farev/robotarmtest/sim/fea-v1/plots/stress_map.png

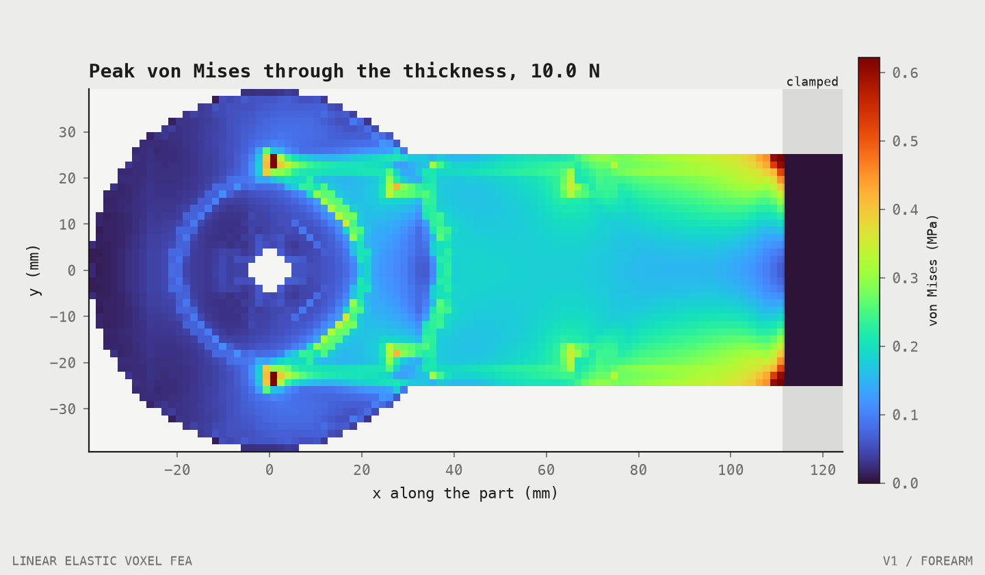
sim/fea-v1/plots/stress_map.png
