farev/robotarmtest/.mechy/reviews/2026-10-29-design-2.md

# Design review, 2026-10-29 (re-review 2)

Verdict: not ready (2 blocking, 13 should fix, 8 unverified)
Files read: design/v1/assembly.yaml, design/v1/poses/{elbow-up,reach-table,shoulder-down,yaw-150,service-tower,stretched,service-j2,up,folded}/assembly.yaml,
design/v1/printed/*.py (layout, gripper_layout, features, style and every part and coupon script), design/v1/printed/*.step (20),
design/v1/print_list.csv, design/v1/views/{iso,front,side,top}.png, design/v1/summary.md, design/v1/check_results.json,
docs/v1/build-notes.md, control/joint_limits.yaml, parts/models/{flange-coupling-5mm,nema17-42shdc}.yaml, parts/models/std_parts.py,
parts/models/std_parts_yaml.py, parts/components.yaml, requirements.yaml, decisions.md, previous review .mechy/reviews/2026-10-29-design.md,
.claude/skills/{assembly/SKILL.md, printable-part-design/references/fdm_pla_rules.md, industrial-design/references/legible_cad.md},
engine data standard_parts/fasteners_hex_nuts.csv, https://vxb.com/products/4-pack-5mm-rigid-flange-shaft-couplings-with-8-scr

## Blocking

1. **Carriage clamp nuts (stage-2 tension)**: the captive-nut slots are wide enough for the M3 nut to spin, so the two carriage clamp screws cannot be tightened.
   - The slot width is `nut_w / cos(30°)` = 5.8 / 0.866 = 6.70 mm (upper-arm.py:127-130). A section of upper-arm.step at print z = 1.35 measures both nut slots at **6.697 mm**.
   - An M3 nut is 5.5 across flats and 6.01 min / 6.35 nominal across corners (fasteners_hex_nuts.csv), so it turns freely in a 6.70 slot. §2 asks for a side-entry slot of s + 0.3 = 5.8.
   - You cannot hold the nut either. The slots sit 14 ± 3 mm from the intermediate shaft, under the 60T flange (r 21) and hub (1 mm off the wall). Build-notes §3.5 tensions stage 2 with those pulleys already fitted.
   - The screw also barely clears the nut. The M3 x 12 tip is at y -81.0 (placed bbox), and the nut seated on the slot floor spans -78.5..-80.9. That leaves 0.1 mm protruding, while §2 asks for at least 1 pitch (0.5).
   - Fix: make the slot 5.8 wide (drop the `/cos(30°)`), and deepen `CARR_CBORE` (pack-carriage.py:17) by 0.5 so the tip protrudes 0.6. It then still clears the 60T hub face at -82.2 by 0.7.
2. **J1 motor screws under the J1 belt**: as the build notes specify them, the two inner J1 screw heads sit inside the running belt, and a key cannot reach them once the belt is on.
   - Build-notes §2 calls for "M3 × 10 + 2 × M3 washers" on the deck top. That puts the head at z 61..64. The belt spans z 63.7..69.7 (centre 66.7, 20T teeth 63.2..70.2).
   - At the inner holes (±15.5, 57.57), the belt pitch line is at x = (38.2 − 0.4356·57.57)/0.9001 = 14.6. The head spans x 12.75..18.25, so it sits under the belt.
   - Scratch check (home pose plus 4 × m3x10-shcs at the J1 holes; nothing in the project changed):
     - with washers: `belt-j1 / screw-j1-1` and `belt-j1 / screw-j1-2` interfere, 2.261 mm³ each;
     - with the Ø5 key keep-outs, the keep-outs also cross the belt: 38.9 mm³ with washers, 40.9 mm³ without.
   - Without washers the heads clear the belt, but M3 x 10 through the 5 mm deck then engages 5.0 in a thread estimated at 4.5 deep (nema17-42shdc.yaml), so it bottoms out.
   - Build-notes §3.1 loops the belt and then says "Slide the J1 motor outward to tension; tighten its screws". The inner pair cannot be reached at that point. The J1 motor screws are not modelled (summary.md "Not modelled ... motor screws of J1/J3/J4"), which is why `check` passed.
   - Fix (re-check after either): rotate the J1 motor 45° about its axis. The screws then sit on the belt centreline (for example (0, 51.15): the belt runs are at x ±17.7 there) and clear the turret plate circle (r 43.1). Or tighten before looping the belt, with heads that clear the belt by at least 0.5 mm and a length that engages at least 4.5 without bottoming. Model the screws and key keep-outs either way.

## Should fix

1. **Thread engagement below 1.5 × d (§2)**: four joints engage only 4.0 mm, below 4.5.
   - J1: M3 x 10 + 2 washers through the 5 mm deck.
   - J2, J3, J4: M3 x 8 through the 4 mm plates.
   - build-notes §2 justifies this as "≥ 1 d in steel, machine_elements §7.3". That reference is not in this project's skills, and the rule in fdm_pla_rules.md §2 is 1.5 × d.
   - Fix: thin the plates locally or counterbore the heads.
2. **Re-tensioning the J2 drive needs a teardown**:
   - Stage 1 can only be set on the bench: summary.md says the J2 screws are behind the tower wall at every shoulder angle (scan_service.py).
   - Stage 2 needs the pack cover, the J3 motor and the J3 belt off.
   - decisions.md:8 accepts PLA everywhere for the deadline, and §8 says clamped and preloaded PLA creeps ("re-tension after a week").
   - Write the re-tension procedure in build-notes, or give one stage an adjuster you can reach in place.
3. **Hex-key keep-outs smaller than the assembly skill's**:
   - The skill asks for head Ø + 1 = 6.5 mm. m3-key-keepout is Ø5.0 (inspect bbox ±2.5), and m3-key-keepout-narrow is Ø3.5 (±1.75). The narrow one is used for J2 screws 2 and 4 (poses/service-j2/assembly.yaml:235-246, 283-294).
   - The two carriage clamp screws, which are tightened on the tower, have no keep-out in any pose (home or service-j2).
   - By hand: from +Y their key path clears the J2 body (screws at UA z ±7, body top z -29.6), and the elbow motor is off with the cover.
4. **pack-carriage 625 pocket walls (§4)**:
   - With `CH` = 25 the pocket wall is (25 − 16.1)/2 = 4.45, against max(3.0, 0.4 × 16.1 = 6.44).
   - The pocket-to-counterbore wall is 14 − 3.25 − 8.05 = 2.70, below 3.0.
   - Better than before (2.95), and the part is PETG, but the rule still fails.
5. **Nut-slot floor 1.3 mm**: the 4.0 wall minus the 2.7 nut slot leaves 1.3 mm (printcheck upper-arm min_wall_mm 1.3). This floor carries the clamp load, and §4 asks for 2.0 on a load-bearing wall. Fix it together with Blocking 1.
6. **Hardware list (parts/components.yaml:83)**:
   - It lists "M3 nuts x 3". Build-notes §2 needs 7: 4 behind the coupling flange, 2 captive carriage nuts and 1 jam nut.
   - The 8 washers are for the J1 stack. Update that count if Blocking 2 drops the washers.
   - parts/build_plan.md:25 still lists a "DIN 9021 M3 washer". The design now uses a 12 mm OD fender washer.
   - The screw total does match: §2 gives 19 × M3x10, 26 × M3x8, 10 × M3x12, 1 × M3x30 and 1 × M3x6, which is 57.
7. **Out-of-date or conflicting documents**:
   - control/joint_limits.yaml:10 says the servo is powered from "the D24V22F6 regulator"; components.yaml lists an LM2596.
   - layout.py:13 and layout.py:247 (comment "4 mm of the 5 mm hub on the shaft") and decisions.md:20 still describe the Pololu 1998 hub.
   - pack-cover.py:2, forearm-cover.py:1 and base-deck.py:42 say "button heads"; build-notes §2 and style.py `DRIVE` say SHCS throughout.
   - gripper-finger-right.py:2 still says "DIN 9021 washer".
   - decisions.md:34 gives a shoulder height of 201; it is now 187.
   - summary.md gives the finger overhang as 64; printcheck gives 56.0.
   - Driver current conflicts: build-notes §0 and joint_limits.yaml:22 say 0.6 A, build-notes §4 says "start at **0.7 A**".
   - hub-pololu-1998.step/.yaml are now unused model files.
8. **Kinematics length**: joint_limits.yaml:18 and summary.md:17 give elbow → pad centre as 219. From the CAD it is 220: `COUPLING_FACE` 145 (layout.py:247) plus `X_TIP` 75 (gripper_layout.py:25) in the G frame, which starts at the flange face. That is a 1 mm IK error.
9. **Print files**: print_list.csv has no rows for coupon-fits and coupon-yaw. Build-notes §1 says "not in print_list.csv", but both are printed models with STLs and are meant to print first.
10. **Soft limits are not backed by a check**:
    - joint_limits.yaml:20-21 says "J2 < 0 together with J3 < -45 can reach the base: test reachable poses slowly first". Summary says J2 −30 with J3 −60 collides.
    - No pose sits on the stated boundary (r 130 / z 100). The poses cover (0,45,−90), (0,0,0), (0,90,0), (0,90,−135), (0,0,−60), (90,−30,0), (0,30,120) and (150,45,−90).
    - Add a pose at the limit, for example J2 −30 / J3 −45, and check it.
11. **End-stops**: build-notes §4 says "Mounts are not in v1: home by eye", and the soft limits above depend on homing. This is carried over from the previous review.
12. **Tower lightening window is a finger trap (legible_cad §5.7)**:
    - The window is 26 mm wide (`hw` 13) and spans z 104.2..151 (shoulder-tower.py:64-68), which is in the 10.2-35.6 mm finger range.
    - The stage-2 20T and belt pass 2.7 mm off the tower's +Y face (layout.py:166). At J2 = 90 the 20T sits at z ≈ 141, in front of the window.
    - Fix: close the window, or make it smaller than 10 mm.
13. **Looks (legible_cad §5.3, §5.8)**:
    - Only base-shell has the `C_BED` bed-edge chamfer (summary.md "Open items for looks").
    - pack-carriage.py has a literal chamfer `CORNER_CHAMFER = 3.0` (line 21) and a fillet of `R_INNER - 1.0` (line 41) outside style.py.
    - Dead constants remain: `CLAMP_Z` (shoulder-tower.py:26) and `M2_PILOT` (layout.py:110).
    - The PETG parts carry the PLA Jade White colour, and no PETG filament is named.

## Unverified

1. **Generic 5 mm flange coupling (hub-j4)**: most of its dimensions are not on the page cited.
   - The VXB page (opened today) gives only "Cylinder bore ID 5 mm", "Base plate diameter 22 mm with M3 screw holes" and "OD 10 mm", "height 10 mm".
   - The 16 mm hole circle ("WHEELTEC listing", no URL), the 2 mm flange thickness and whether the holes are plain or tapped are not confirmed. The purchase is an Amazon search (components.yaml:232).
   - The nuts behind the flange are tight against the hub. A nut flat sits at 8 − 2.75 = 5.25 from the axis against the hub at r 5.0, a 0.25 mm gap. The corners (r 4.82-5.0) reach the hub.
   - If the hole circle is ≤ 15.5 or the hub is > 10.5, the nuts do not seat.
   - Measure the coupling before printing gripper-base.
2. **Motor body 40 / shaft 24** (estimates, nema17-42shdc.yaml:15-16): several clearances depend on these numbers.
   - The J1 shaft tip at z 79.0 is 1.2 mm under the rotating turret plate (80.2).
   - The pack axial gap is 1.0.
   - The J4 motor back (x 80) is 6 mm from the forearm cover bosses (x 66-74).
   - The coupling engagement also depends on the shaft length.
   - Measure an owned motor before printing.
3. **Pulley envelopes** (gt2-20t/60t yaml: flange, hub and length are all "estimate"). These set whether the 60T covers the nut slots (Blocking 1), the 2.7 mm gap from the 20T to the tower, and the J1 belt height in Blocking 2.
4. **Bearing inner-ring lands** (6806 ~33.5, 608 ~12.1 "[est]"): carried over.
5. **MG90S horn dimensions** ("[est]" in gripper-finger-left.py:15-18): carried over.
6. **E-stop and panel jack inside the base**: not modelled. Carried over.
7. **Slicer**: printcheck's slice failed on all 20 STEPs ("BambuStudio crashed (signal 11)").
8. **Stiffness of the 6 mm turret plate and the shoulder rod in PLA bores**: rough estimates only. Carried over.

## Checked

- `check v1` and all 9 poses (elbow-up, reach-table, shoulder-down, yaw-150, service-tower, stretched, service-j2, up, folded) ran today: 0 interferences, 0 clearance issues, 0 unverified_contacts. uno-cnc-shield has 33 solids and 0 non-solid bodies; every other part is 1 solid.
- Large allow_contact pairs: I re-ran the home pose and 7 poses in a scratch copy without forearm/motor-j4 and shoulder-tower/shoulder-pulley-80t. The only overlap was forearm/motor-j4 at 0.055 mm³ (shoulder-down), which matches the boolean-noise reason in summary.md.
- `printcheck` on all 20 STEPs: every part fits the bed, with no thin walls and no small holes.
  - Overhangs: base-shell 87.22, turret-hub 85.14, 80T 106.95, forearm 207.26, upper-arm 216.27, pack-carriage 84.89, gripper-base 24.97, fingers 56.0, tower 2.52, coupon-fits 25.31 mm².
  - Each overhang has a written reason in summary.md.
- Previous Blocking 1 (tower foot) is fixed.
  - The inserts are at (±30, −136.4 / −110.4): 6.5 mm off the wall's −Y face and 7.5 mm off its +Y face. The head edge is at x 32.75, against the gussets at 37.5.
  - The placed axes match the turret inserts (perpendicular offset 0.000). An M3 x 12 engages 6 mm.
  - The turret insert hole runs through the 6 mm plate (depth 6.0, not 6.7). Acceptable, because nothing is below it there.
- Previous Blocking 2 (shaft lock) is fixed. The M3 x 30 tip is at z 191, the rod top (placed bbox). The passage is 3.6 and the head stands 4 mm proud, which fits the 2.4 jam nut.
- Previous Blocking 3: J2 moved to 300°. service-j2 checks clean with keep-outs, which are undersized (Should fix 3). The carriage screws are now put in from inside the pack, but Blocking 1 is new on that joint.
- Placed hole axes, computed with the assembly transform: all perpendicular offsets 0.000 and all axes parallel.
  - Joints: hub-j4/gripper-base (4), motor-j4/forearm (4), 80T/tower (4), tower/turret (4), pack-cover/upper-arm (5), forearm-cover/forearm (4), servo/gripper-base (2).
  - The coupling and gripper-plate hole centres are 3.00 apart along the axis, which is 1 + 2 half-depths, so the faces touch.
- Screw lengths and engagement:
  - Into inserts: deck M3x10 (5), foot M3x12 (6), 80T M3x12 (5.5), pack cover M3x10 (6), forearm cover M3x8 (5), idler M3x6 + 0.8 washer (5.2). The idler washer overlaps the 8.4 bore by 1.8 mm.
  - Through nuts: servo M2x8 through 2.5 + 3 + nut protrudes 0.9.
  - All are OK except the items in Blocking 1-2 and Should fix 1.
- Previous should-fix items now resolved:
  - forearm insert wall is 2.0 (INS_Z 20.85, boss flush with ZW_OUT 24.85);
  - tower bore is an 8.3 teardrop;
  - panel holes are teardrops;
  - the stage-2 20T clears the tower by 2.7;
  - the web and floor holes are gone;
  - the motor-against-mount allowances are removed;
  - the coupons have 4 columns (−0.1..+0.2).
- Views: the 4 home views are newer than assembly.yaml, so I did not re-render them. Looked at all 4: nothing floats or is sunk, belts sit on their pulleys, and the keep-outs show the plug exits. The reach-table pose views are older than that pose's assembly and were not re-rendered or used.
- print_list.csv: 18 rows; bearing-shim qty 3 matches its 3 instances. PETG on base-deck, upper-arm, pack-cover, pack-carriage and forearm, the same as assembly.yaml. Every listed STL exists and is newer than its STEP, and there are no stale STLs.
- flange-coupling-5mm.step inspected: 22 × 12, 4 × Ø3.2 holes at r 8.0, Ø5 bore, matching `model_mm`.
