farev/robotarmtest/.mechy/reviews/2026-10-29-design-3.md

# Design review, 2026-10-29 (re-review 3)

Verdict: ready (0 blocking, 8 should fix, 8 unverified)
Files read: design/v1/assembly.yaml, design/v1/poses/{elbow-up,folded,reach-table,service-j2,service-tower,shoulder-down,soft-limit,stretched,up,yaw-150}/assembly.yaml,
design/v1/check_results.json, design/v1/make_assembly.py, design/v1/scan_j2.py, design/v1/printed/{layout,gripper_layout,upper-arm,pack-carriage,base-deck,base-shell,turret-hub,shoulder-tower,gripper-base}.py,
design/v1/printed/*.step (20, printcheck), design/v1/print_list.csv, design/v1/views/{iso,front,side,top}.png, design/v1/poses/reach-table/views/front.png,
design/v1/summary.md, docs/v1/build-notes.md, control/joint_limits.yaml, parts/models/{nema17-42shdc,nema17-42shdc.py,flange-coupling-5mm,m3-key-keepout}.yaml,
parts/components.yaml, parts/build_plan.md, .claude/skills/{assembly/SKILL.md, printable-part-design/references/fdm_pla_rules.md, build-plan/references/machine_elements.md §7.3},
previous reviews .mechy/reviews/2026-10-29-design.md and -2.md

## Blocking

None.

## Should fix

1. **Soft limits and the table (new)**: the documented soft limit lets the gripper go deep into the table. `check` cannot catch this because the table is not modelled.
   - Pad-centre height = Z_SH + L2·sin q2 + 220·sin(q2 + q3), with Z_SH 187, L2 135 and elbow → pad 220 (layout.py, joint_limits.yaml:16-18).
   - Pose `soft-limit` (0, −30, −30) is called "clear" in joint_limits.yaml:20-21 and summary.md:19-21. Its pad is at 187 − 67.5 − 190.5 = **−71 mm**, at x = 116.9 + 110 = 227, which is outside the base (r 115), so the pad is inside the table.
   - Pose `reach-table` (0, 0, −60): in poses/reach-table/assembly.yaml:585-596 the coupling face is placed at (207.5, 61.43). The pad centre, 75 further on, is at z = 61.43 − 75·0.866 = **−3.5**, and the pad's lower edge is at about −6. make_assembly.py:265 says "pads ~11 mm above the table". That was true with the old shoulder height of 201 (201 − 190.5).
   - The rule "only when J2 < 0" also misses J2 ≥ 0. For example, (0, 0, −90) puts the pad at 187 − 220 = −33.
   - Fix: make the firmware limit a table constraint: 187 + 135 sin q2 + 223 sin(q2 + q3) ≥ 10, which is about q3 ≥ −53° at J2 = 0. Or add a table keep-out slab (z −20..0, r 400) to the poses and re-check. Then correct joint_limits.yaml:20-21, summary.md:19-21 and the reach-table comment.
2. **Thread engagement in the motor threads**: engagement is at or below the rule, and the written justification does not hold.
   - J2, J3 and J4 use M3 × 8 through 4 mm plates, which engages 4.0 mm. Build-notes §2 cites machine_elements.md §7.3, "steel ≥ 1 d". But the same line (machine_elements.md:716) says "aluminium ≥ 1.5–2 d", and NEMA 17 front end caps are aluminium. So 4.0 is below 4.5.
   - J1 uses M3 × 10 + 1 washer through the 5 mm deck, which engages 4.5. That equals the *estimated* thread depth of 4.5 ± 0.5 (nema17-42shdc.yaml:11), so there is zero margin before the screw bottoms.
   - Fix: extend the "screw an M3 into a motor hole and measure" step in build-notes §2 to J1. If the depth is under 5 mm, use 2 washers on J1: the heads now sit clear of the belt in XY, so the extra 0.5 mm costs nothing.
3. **Hex-key keep-outs are Ø5; the assembly skill asks for head Ø + 1 = 6.5** (m3-key-keepout.yaml:10). I checked the Ø6.5 case by hand, and every tightened screw still clears by more than 0.5 mm:
   - J1 (0, 51.15): 47.9 to the 120T flange (r 39.2), 14.4 to the belt runs at x ±17.7.
   - J1 (±21.92, 73.07): 10.7 to the 20T flange.
   - J2 screw (−32.23, −35.26): it sits inside the stage-1 loop, about 2.1 mm from the belt's inner face.
   - Tower foot: 4.25 to the gussets.
   - Carriage: Ø6.5 equals its counterbore.
   - Enlarge the keep-out model so `check` covers this.
4. **pack-carriage 625 pocket walls (§4)**: unchanged. The pocket wall is 4.45 against the required 6.44, and the pocket-to-counterbore wall is 14 − 3.25 − 8.05 = 2.70 against 3.0 (pack-carriage.py:16; printcheck min wall 2.13). summary.md:75 now gives a reason. Confirm the press fit on the PETG coupon before relying on it.
5. **End-stops**: still "Mounts are not in v1: home by eye" (build-notes §4). Every soft limit in item 1 depends on homing, so with no switches the item-1 limits are only as good as by-eye homing.
6. **Out-of-date documents and numbers**:
   - parts/components.yaml:239 says "4 x M3 x 10 + nuts" for the coupling. Build-notes §2 and gripper-base.py:1 say M3 × 8, which leaves the tip 1.0 mm past the plate front.
   - docs/v1/build-notes.md:20 still says the coupons are "not in print_list.csv". They are now rows 2-3.
   - summary.md:39-40 says the upper J2 pair is checked with a "narrow Ø3.5 key envelope". Every J2 keep-out in poses/service-j2 is now m3-key-keepout (Ø5).
   - summary.md:40 claims "≥ 4 mm for the full Ø5 envelope". scan_j2.py:11 and :35 measure to the belt's *outer* surface. Screw (−32.23, −35.26) sits inside the loop, so the gap to the inner face is about 2.8 (Ø5).
   - summary.md:80 gives upper-arm as 231.7 × 141.6 × 55.8. printcheck gives 231.74 × 155.59 × 55.8.
   - poses/reach-table/views/*.png are stale. They still show the tower window and web holes, which no longer exist. Re-render them or delete them; summary.md:53 cites them as looked at.
   - print_list.csv rows 2-3 make the coupons PLA only. The PETG reprints of base-deck, upper-arm, pack-carriage and forearm (608/625/6806 pockets) need a PETG coupon first. Say so in build-notes §1.
7. **STEPs older than their sources**:
   - pack-cover.py (19:42:13) vs .step (19:41:04).
   - shoulder-tower.py (19:42:10) vs .step (19:41:14).
   - forearm-cover.py (19:42:15) vs .step (15:37:50).
   - gripper-finger-right.py (19:42:12) vs .step (18:29:09).
   - layout.py was also edited at 19:42:09, after most STEPs.
   - base-deck.step does match the new layout: inspect shows the J1 slots at (±21.92, 73.07), (0, 51.15) and (0, 95.0) in assembled coordinates. I could not confirm that the other edits are comment-only.
   - Re-run build_all.py, then `export` and `check`, so that every STEP and STL is newer than its source.
8. **Looks (legible_cad §5.3, §5.8)**:
   - Only base-shell has the `C_BED` chamfer (summary.md:86).
   - pack-carriage.py:22 has the literal `CORNER_CHAMFER = 3.0`, and pack-carriage.py:42 has `R_INNER - 1.0`. Both live outside style.py.
   - shoulder-tower.py:63 has a dead `win` plane.
   - The PETG parts still use the PLA Jade White colour, and no PETG filament is named.
   - parts/models/mg90s-keepout.step has no yaml.

## Unverified

1. **Generic 5 mm flange coupling**: the 16 mm hole circle, the 2 mm flange and the 10 mm hub are not on the cited VXB page (flange-coupling-5mm.yaml:19-38; components.yaml:232 is an Amazon search).
   - With the new layout, the M3 heads sit behind the flange. The head edge is at 8 − 2.75 = 5.25 from the axis, against the hub at r 5.0, a **0.25 mm** gap.
   - With a 10.5 hub (the build-notes §3.8 limit) the gap is 0.0.
   - Measure the coupling before printing gripper-base.
2. **Motor body 40, shaft 24, thread depth 4.5, corner chamfer 5** (all estimates, nema17-42shdc.yaml:11-16 and nema17-42shdc.py:17). These feed:
   - the J1 shaft tip at 1.2 under the turret plate;
   - the 1.0 pack axial gap;
   - item 2 above;
   - the J1 motor, now turned 45°. Its +Y corner (r 26.4 with the 5 mm chamfer) is 4.1 mm from the shell's deck boss at (0, 108.5, r 5), and 1.1 mm at the +3 slot end. A smaller real chamfer reduces this.
3. **Pulley envelopes** (gt2-20t/60t yaml, estimates). The carriage screw tip, 0.3 past the wall, clears the 60T hub face (1 mm off the wall) by 0.7 only if the hub is where the model has it.
4. **Bearing inner-ring lands** (6806 ~33.5, 608 ~12.1 "[est]"): carried over.
5. **MG90S horn dimensions** ("[est]" in gripper-finger-left.py): carried over.
6. **E-stop, panel jack and LM2596 inside the base**: not modelled. Carried over.
7. **Slicer**: printcheck's slice failed on all 20 STEPs ("BambuStudio crashed (signal 11)").
8. **Stiffness** of the 6 mm turret plate and the shoulder rod in PLA bores: rough estimates only. Carried over.

## Checked

- `check v1` and all 10 poses ran today: elbow-up, folded, reach-table, service-j2, service-tower, shoulder-down, soft-limit, stretched, up and yaw-150.
  - Every run gave `ok: true`, with 0 interferences, 0 clearance issues and 0 unverified_contacts. check_results.json agrees.
  - The J1 motor screws (screw-j1-1..4) are now modelled in every pose. They have key keep-outs in service-tower, and the carriage screws have keep-outs in service-j2.
- `printcheck` on all 20 STEPs: every part fits the bed, with no thin walls and no small holes.
  - Overhangs: base-shell 87.22, coupon-fits 25.31, forearm 207.26, gripper-base 67.1, fingers 56.0, pack-carriage 84.89, 80T 106.95, tower 2.52, turret-hub 85.14, upper-arm 187.89 mm².
  - Each has a written reason in summary.md:64-81.
- Previous Blocking 1 (carriage nuts) is **fixed**.
  - `inspect upper-arm.step` shows both nut slots as Ø5.8 partial arcs, 2.7 deep, at print (−58.16, 7.0) and (−33.92, −7.0). That matches CARR_SCREWS. 5.8 < 6.01 min across corners, so the nut cannot turn.
  - CARR_CBORE = 16 + 4 + 0.3 − 12 = 8.3 puts the tip at y −81.5. The nut spans −78.5..−80.9, so the tip protrudes 0.6, which is at least 1 pitch.
  - The 1.3 mm slot floor is now justified as pure compression between the nut and the carriage face (summary.md:74). I accept that.
- Previous Blocking 2 (J1 screws under the belt) is **fixed**.
  - J1_MOTOR_ROT = −45 (layout.py:126). The model's (±15.5, ±15.5) holes rotate to (±21.92, 0) and (0, ±21.92), which match J1_SCREWS_XY and the deck slots (inspect).
  - Screw (0, 51.15) sits between the belt runs (x ±17.7). The other three are 10+ mm off the belt and the 20T.
  - Heads span z 60.5..63.5 and the belt spans 63.7..69.7.
  - Build-notes §3.1 now tightens them after tensioning, with the turret arm turned away.
- Previous should-fix items now resolved:
  - The re-tensioning procedure is in build-notes §3.
  - The tower window is gone: shoulder-tower.py:64 has no cut, and the front and iso views show a solid wall.
  - The coupons are in print_list.csv.
  - Elbow → pad is 220 in both joint_limits.yaml:18 and summary.md:17.
  - The LM2596 is consistent in components.yaml and joint_limits.yaml:10.
  - Driver current is 0.6 A everywhere (0.7 A once PETG).
  - No "button head", "DIN 9021", "201" or Pololu-hub leftovers remain in the sources, and hub-pololu-1998 model files are gone.
  - `CLAMP_Z` and `M2_PILOT` are removed.
  - components.yaml:83 now lists 7 nuts, 4 washers and the fender washer.
  - parts/build_plan.md:25 matches.
- Screw totals: 15 × M3x10, 30 × M3x8, 10 × M3x12, 1 × M3x30 and 1 × M3x6 = 57, which matches components.yaml:83. Inserts: 35 in both files.
- Gripper joint: the M3 × 8 runs through the 2 mm flange and the 5 mm plate into a 5.75 × 2.7 front nut pocket. The nut seats at 2.3 and the tip ends 1.0 past the plate front, so the full nut is engaged.
- Views: the 4 home views (19:47) are newer than assembly.yaml (19:46:52), so I did not re-render them. Looked at all 4:
  - nothing floats or is sunk;
  - the belts sit on their pulleys;
  - the J1 screws show around the 20T in the top view;
  - the plug keep-outs exit at the pack notches;
  - the tower has no window.
- print_list.csv: 20 rows, one per printed model; bearing-shim qty 3 matches its 3 instances. The PETG set matches make_assembly.py:85. Every listed STL exists, and there are no stale STLs.
