farev/robotarmtest/inbox/20261029-182627.md

---
from: user
created: 2026-10-29T22:26:27Z
---

Did you finish? Also I need to finish this saturday so lets use parts that I can get from here: https://epay.gatech.edu/C20793_ustores/web/store_main.jsp?STOREID=324&SINGLESTORE=true
or that I can order quickly from amazon. Also I have access to Georgia Tech’s Invention Studio so I have acess to screws and nuts of all types and to heat inserts if useful.
