farev/robotarmtest/inbox/done/20261030-162351.md

---
from: user
created: 2026-10-30T20:23:51Z
---

Here there is no gap for the belt. Fix that.

## Redlines

Numbers match the red badges I drew.

1. Freehand mark on the CAD tab, centre (x 60%, y 41%).

Attached inspiration:
- inspiration/redline-20261030-162351.png
