farev/robotarmtest/inbox/done/20261029-205316.md

---
from: user
created: 2026-10-30T00:53:16Z
---

Did you modify the design so we can buy most of the components from the Invention Studio Store? https://epay.gatech.edu/C20793_ustores/web/store_main.jsp?STOREID=324&SINGLESTORE=true

What parts can’t we get from the invention studio store currently?
