farev/robotarmtest/inbox/done/20261029-210241.md

---
from: user
created: 2026-10-30T01:02:41Z
---

My answers:

I can't see the Invention Studio Store's products: the page only loads them in a logged-in browser, so my tools see an empty page. Could you paste the store's product list (or the items under its mechanical/electronics categories), or a screenshot of them? Even just a yes/no on these would do: 608 bearings, 625 bearings, 6806 (30x42x7) bearings, GT2 pulleys (20T / 60T, 5 mm bore), GT2 closed belts (200 / 300 / 520 mm), 8 mm and 5 mm steel rod, 8 mm shaft collars, 5 mm flange coupling, MG90S servo, buck converter, DC barrel jack, E-stop button, inline fuse holder, stepper extension cables.
Here is the full extracted product catalog: {
  "store_name": "Invention Studio Store",
  "store_id": "324",
  "store_url": "https://epay.gatech.edu/C20793_ustores/web/store_main.jsp?STOREID=324&SINGLESTORE=true",
  "captured_date": "2026-10-29",
  "captured_timezone": "America/New_York",
  "capture_completed_at": "2026-10-29T20:59:12-04:00",
  "summary": {
    "products": 94,
    "top_level_categories": 17,
    "subcategories": 4,
    "option_choices": 19,
    "products_with_options": 5,
    "out_of_stock_products": 3
  },
  "notes": [
    "Snapshot captured October 29, 2026, America/New_York. Prices can change.",
    "Scope: all product links exposed by the store homepage, all 17 top-level categories, and all 4 discovered subcategories. 94 unique product IDs.",
    "The Miscellaneous category advertises 16 products but displays 15. The missing count could not be resolved from the public category page.",
    "Acrylic 12 x 12 (6706) is present on the homepage and in store search, but not in the category listings. It is included without an inferred category.",
    "Two top-level categories are named Electronics (IDs 577 and 688); they are kept distinct.",
    "Category membership comes from category listings. Product-page breadcrumbs retain the previously visited category and are not reliable membership data.",
    "No stock warning means the page displayed no out-of-stock notice. Checkout inventory was not tested. Listed prices exclude any charges only shown at checkout. USD is inferred from the dollar sign and US store.",
    "19 size/color choices were selected on 5 product pages. Their displayed prices stayed unchanged. No items were added to the cart.",
    "Product and category descriptions, eligibility restrictions, retailer reference links, and product image URLs are retained. Missing descriptions and images are left empty.",
    "Reference links are the store-provided links; their destination content and prices were not used to replace store details. Default placeholder images are omitted."
  ],
  "products": [
    {
      "product_id": "4873",
      "stock_number": "110001",
      "name": "11 oz. Industrial Strength Silicone Lubricant",
      "price": 4.0,
      "currency": "USD",
      "availability": "No stock warning",
      "purchase_restriction": "",
      "categories": [
        {
          "id": "683",
          "name": "Adhesives, Lubricants, & Removers",
          "path": "Adhesives, Lubricants, & Removers",
          "url": "https://epay.gatech.edu/C20793_ustores/web/store_cat.jsp?STOREID=324&CATID=683&SINGLESTORE=true"
        }
      ],
      "listing_descriptions": [
        "The Home Depot link (for reference only)\nPlease place orders on the Invention Studio store site for free pickup at the Studio Store"
      ],
      "product_description": "The Home Depot link (for reference only)\nPlease place orders on the Invention Studio store site for free pickup at the Studio Store",
      "options": [],
      "reference_urls": [
        "https://www.homedepot.com/p/Blaster-11-oz-Industrial-Strength-Silicone-Lubricant-Case-of-12-16-SL/205048085"
      ],
      "image_urls": [
        "https://epay.gatech.edu/C20793_ustores/web/uploaded_images/store_324/Silicone_Lubricant.PNG"
      ],
      "source_url": "https://epay.gatech.edu/C20793_ustores/web/product_detail.jsp?PRODUCTID=4873&SINGLESTORE=true",
      "category_source_urls": [
        "https://epay.gatech.edu/C20793_ustores/web/store_cat.jsp?STOREID=324&CATID=683&SINGLESTORE=true"
      ],
      "notes": ""
    },
    {
      "product_id": "6248",
      "stock_number": "",
      "name": "0.472\" Diameter, 0.197\" Thick Ceramic Disc Magnet Pack (40 pk)",
      "price": 14.0,
      "currency": "USD",
      "availability": "No stock warning",
      "purchase_restriction": "",
      "categories": [
        {
          "id": "682",
          "name": "Arts & Crafts",
          "path": "Arts & Crafts",
          "url": "https://epay.gatech.edu/C20793_ustores/web/store_cat.jsp?STOREID=324&CATID=682&SINGLESTORE=true"
        }
      ],
      "listing_descriptions": [],
      "product_description": "",
      "options": [],
      "reference_urls": [],
      "image_urls": [
        "https://epay.gatech.edu/C20793_ustores/web/uploaded_images/guid/b/f/f9d379-3d24-472e-b0c5-b491e6e8fbf3.jpg"
      ],
      "source_url": "https://epay.gatech.edu/C20793_ustores/web/product_detail.jsp?PRODUCTID=6248&SINGLESTORE=true",
      "category_source_urls": [
        "https://epay.gatech.edu/C20793_ustores/web/store_cat.jsp?STOREID=324&CATID=682&SINGLESTORE=true"
      ],
      "notes": ""
    },
    {
      "product_id": "6250",
      "stock_number": "",
      "name": "1\" x 0.875\" x 0.25\" Ceramic Latch Magnet (20 pk)",
      "price": 11.5,
      "currency": "USD",
      "availability": "No stock warning",
      "purchase_restriction": "",
      "categories": [
        {
          "id": "682",
          "name": "Arts & Crafts",
          "path": "Arts & Crafts",
          "url": "https://epay.gatech.edu/C20793_ustores/web/store_cat.jsp?STOREID=324&CATID=682&SINGLESTORE=true"
        }
      ],
      "listing_descriptions": [],
      "product_description": "",
      "options": [],
      "reference_urls": [],
      "image_urls": [
        "https://epay.gatech.edu/C20793_ustores/web/uploaded_images/guid/3/1/855525-ba03-44e2-8013-5e2c1c77afbe.jpg"
      ],
      "source_url": "https://epay.gatech.edu/C20793_ustores/web/product_detail.jsp?PRODUCTID=6250&SINGLESTORE=true",
      "category_source_urls": [
        "https://epay.gatech.edu/C20793_ustores/web/store_cat.jsp?STOREID=324&CATID=682&SINGLESTORE=true"
      ],
      "notes": ""
    },
    {
      "product_id": "5054",
      "stock_number": "100005",
      "name": "Canvas - 12'' x 12'', 1-1/2\"",
      "price": 12.0,
      "currency": "USD",
      "availability": "No stock warning",
      "purchase_restriction": "",
      "categories": [
        {
          "id": "682",
          "name": "Arts & Crafts",
          "path": "Arts & Crafts",
          "url": "https://epay.gatech.edu/C20793_ustores/web/store_cat.jsp?STOREID=324&CATID=682&SINGLESTORE=true"
        }
      ],
      "listing_descriptions": [
        "Blick Premier Gallery Profile Cotton Canvas - 12'' x 12''"
      ],
      "product_description": "",
      "options": [],
      "reference_urls": [],
      "image_urls": [
        "https://epay.gatech.edu/C20793_ustores/web/uploaded_images/store_324/07139-1212-2-4ww.jpg"
      ],
      "source_url": "https://epay.gatech.edu/C20793_ustores/web/product_detail.jsp?PRODUCTID=5054&SINGLESTORE=true",
      "category_source_urls": [
        "https://epay.gatech.edu/C20793_ustores/web/store_cat.jsp?STOREID=324&CATID=682&SINGLESTORE=true"
      ],
      "notes": ""
    },
    {
      "product_id": "5055",
      "stock_number": "100006",
      "name": "Canvas - 12'' x 12'', 2-3/8''",
      "price": 18.0,
      "currency": "USD",
      "availability": "No stock warning",
      "purchase_restriction": "",
      "categories": [
        {
          "id": "682",
          "name": "Arts & Crafts",
          "path": "Arts & Crafts",
          "url": "https://epay.gatech.edu/C20793_ustores/web/store_cat.jsp?STOREID=324&CATID=682&SINGLESTORE=true"
        }
      ],
      "listing_descriptions": [
        "Blick Premier Museum Profile Cotton Canvas - 12'' x 12'', 2-3/8'' Profile"
      ],
      "product_description": "",
      "options": [],
      "reference_urls": [],
      "image_urls": [
        "https://epay.gatech.edu/C20793_ustores/web/uploaded_images/store_324/07138-groupw-2-4ww.jpg"
      ],
      "source_url": "https://epay.gatech.edu/C20793_ustores/web/product_detail.jsp?PRODUCTID=5055&SINGLESTORE=true",
      "category_source_urls": [
        "https://epay.gatech.edu/C20793_ustores/web/store_cat.jsp?STOREID=324&CATID=682&SINGLESTORE=true"
      ],
      "notes": ""
    },
    {
      "product_id": "5053",
      "stock_number": "100007",
      "name": "Canvas - 18'' x 24'', 2-3/8''",
      "price": 32.0,
      "currency": "USD",
      "availability": "No stock warning",
      "purchase_restriction": "",
      "categories": [
        {
          "id": "682",
          "name": "Arts & Crafts",
          "path": "Arts & Crafts",
          "url": "https://epay.gatech.edu/C20793_ustores/web/store_cat.jsp?STOREID=324&CATID=682&SINGLESTORE=true"
        }
      ],
      "listing_descriptions": [
        "Blick Premier Museum Profile Cotton Canvas - 18'' x 24'', 2-3/8'' Profile"
      ],
      "product_description": "",
      "options": [],
      "reference_urls": [],
      "image_urls": [
        "https://epay.gatech.edu/C20793_ustores/web/uploaded_images/store_324/Screenshot_2021-07-09_213848.jpg"
      ],
      "source_url": "https://epay.gatech.edu/C20793_ustores/web/product_detail.jsp?PRODUCTID=5053&SINGLESTORE=true",
      "category_source_urls": [
        "https://epay.gatech.edu/C20793_ustores/web/store_cat.jsp?STOREID=324&CATID=682&SINGLESTORE=true"
      ],
      "notes": ""
    },
    {
      "product_id": "6232",
      "stock_number": "",
      "name": "Sunlite Bike Inner-Tube Replacement (26 x 2.00-2.40, 48mm Schrader valve))",
      "price": 8.0,
      "currency": "USD",
      "availability": "No stock warning",
      "purchase_restriction": "",
      "categories": [
        {
          "id": "686",
          "name": "Bike Repair",
          "path": "Bike Repair",
          "url": "https://epay.gatech.edu/C20793_ustores/web/store_cat.jsp?STOREID=324&CATID=686&SINGLESTORE=true"
        }
      ],
      "listing_descriptions": [],
      "product_description": "",
      "options": [],
      "reference_urls": [],
      "image_urls": [
        "https://epay.gatech.edu/C20793_ustores/web/uploaded_images/guid/9/6/352077-1165-4743-b2fc-3e5916564e8e.jpg"
      ],
      "source_url": "https://epay.gatech.edu/C20793_ustores/web/product_detail.jsp?PRODUCTID=6232&SINGLESTORE=true",
      "category_source_urls": [
        "https://epay.gatech.edu/C20793_ustores/web/store_cat.jsp?STOREID=324&CATID=686&SINGLESTORE=true"
      ],
      "notes": ""
    },
    {
      "product_id": "4990",
      "stock_number": "98",
      "name": "Breadboard",
      "price": 2.0,
      "currency": "USD",
      "availability": "No stock warning",
      "purchase_restriction": "",
      "categories": [
        {
          "id": "577",
          "name": "Electronics",
          "path": "Electronics",
          "url": "https://epay.gatech.edu/C20793_ustores/web/store_cat.jsp?STOREID=324&CATID=577&SINGLESTORE=true"
        }
      ],
      "listing_descriptions": [
        "Breadboard Prototype Board - 400 Pin Solderless Board Kit for Raspberry pi and Arduino Project"
      ],
      "product_description": "",
      "options": [],
      "reference_urls": [],
      "image_urls": [
        "https://epay.gatech.edu/C20793_ustores/web/uploaded_images/store_324/814w7RYd9qL._AC_SL1500_.jpg"
      ],
      "source_url": "https://epay.gatech.edu/C20793_ustores/web/product_detail.jsp?PRODUCTID=4990&SINGLESTORE=true",
      "category_source_urls": [
        "https://epay.gatech.edu/C20793_ustores/web/store_cat.jsp?STOREID=324&CATID=577&SINGLESTORE=true"
      ],
      "notes": ""
    },
    {
      "product_id": "6259",
      "stock_number": "",
      "name": "Electrical Tape (30' Length, 0.7\" Width)",
      "price": 1.5,
      "currency": "USD",
      "availability": "No stock warning",
      "purchase_restriction": "",
      "categories": [
        {
          "id": "688",
          "name": "Electronics",
          "path": "Electronics",
          "url": "https://epay.gatech.edu/C20793_ustores/web/store_cat.jsp?STOREID=324&CATID=688&SINGLESTORE=true"
        },
        {
          "id": "695",
          "name": "Tape & Zip Ties",
          "path": "Tape & Zip Ties",
          "url": "https://epay.gatech.edu/C20793_ustores/web/store_cat.jsp?STOREID=324&CATID=695&SINGLESTORE=true"
        }
      ],
      "listing_descriptions": [],
      "product_description": "",
      "options": [
        {
          "name": "Color",
          "values": [
            "Red",
            "Yellow",
            "Green",
            "Blue",
            "White",
            "Black"
          ],
          "source_field_id": "orderOpt29862590"
        }
      ],
      "reference_urls": [],
      "image_urls": [],
      "source_url": "https://epay.gatech.edu/C20793_ustores/web/product_detail.jsp?PRODUCTID=6259&SINGLESTORE=true",
      "category_source_urls": [
        "https://epay.gatech.edu/C20793_ustores/web/store_cat.jsp?STOREID=324&CATID=688&SINGLESTORE=true",
        "https://epay.gatech.edu/C20793_ustores/web/store_cat.jsp?STOREID=324&CATID=695&SINGLESTORE=true"
      ],
      "notes": ""
    },
    {
      "product_id": "6498",
      "stock_number": "",
      "name": "GFORTUN 4cmx6cm Double Sided 2.54 Protoboard",
      "price": 10.0,
      "currency": "USD",
      "availability": "No stock warning",
      "purchase_restriction": "",
      "categories": [
        {
          "id": "689",
          "name": "Arduinos & Boards",
          "path": "Electronics > Arduinos & Boards",
          "url": "https://epay.gatech.edu/C20793_ustores/web/store_cat.jsp?STOREID=324&CATID=689&SINGLESTORE=true"
        }
      ],
      "listing_descriptions": [
        "Link For Reference"
      ],
      "product_description": "",
      "options": [],
      "reference_urls": [
        "https://www.schmalztech.com/products/4-x-6-protoboard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"
      ],
      "image_urls": [
        "https://epay.gatech.edu/C20793_ustores/web/uploaded_images/guid/f/7/cf50a3-71d0-4e37-b690-8147b124aa27.png"
      ],
      "source_url": "https://epay.gatech.edu/C20793_ustores/web/product_detail.jsp?PRODUCTID=6498&SINGLESTORE=true",
      "category_source_urls": [
        "https://epay.gatech.edu/C20793_ustores/web/store_cat.jsp?STOREID=324&CATID=689&SINGLESTORE=true"
      ],
      "notes": ""
    },
    {
      "product_id": "6263",
      "stock_number": "",
      "name": "HiLetgo Finished Prototype PCB (Protoboard) - 5 cm x 7 cm",
      "price": 0.5,
      "currency": "USD",
      "availability": "No stock warning",
      "purchase_restriction": "",
      "categories": [
        {
          "id": "689",
          "name": "Arduinos & Boards",
          "path": "Electronics > Arduinos & Boards",
          "url": "https://epay.gatech.edu/C20793_ustores/web/store_cat.jsp?STOREID=324&CATID=689&SINGLESTORE=true"
        }
      ],
      "listing_descriptions": [],
      "product_description": "",
      "options": [],
      "reference_urls": [],
      "image_urls": [
        "https://epay.gatech.edu/C20793_ustores/web/uploaded_images/guid/8/a/5f4b61-2970-40f7-a238-796537c9fd2c.jpg"
      ],
      "source_url": "https://epay.gatech.edu/C20793_ustores/web/product_detail.jsp?PRODUCTID=6263&SINGLESTORE=true",
      "category_source_urls": [
        "https://epay.gatech.edu/C20793_ustores/web/store_cat.jsp?STOREID=324&CATID=689&SINGLESTORE=true"
      ],
      "notes": ""
    },
    {
      "product_id": "4907",
      "stock_number": "39",
      "name": "Raspberry Pi Zero",
      "price": 45.0,
      "currency": "USD",
      "availability": "No stock warning",
      "purchase_restriction": "",
      "categories": [
        {
          "id": "689",
          "name": "Arduinos & Boards",
          "path": "Electronics > Arduinos & Boards",
          "url": "https://epay.gatech.edu/C20793_ustores/web/store_cat.jsp?STOREID=324&CATID=689&SINGLESTORE=true"
        }
      ],
      "listing_descriptions": [
        "Raspberry Pi Zero"
      ],
      "product_description": "",
      "options": [],
      "reference_urls": [],
      "image_urls": [
        "https://epay.gatech.edu/C20793_ustores/web/uploaded_images/store_324/61IY5mYh8tL._AC_SL1000_.jpg"
      ],
      "source_url": "https://epay.gatech.edu/C20793_ustores/web/product_detail.jsp?PRODUCTID=4907&SINGLESTORE=true",
      "category_source_urls": [
        "https://epay.gatech.edu/C20793_ustores/web/store_cat.jsp?STOREID=324&CATID=689&SINGLESTORE=true"
      ],
      "notes": ""
    },
    {
      "product_id": "6267",
      "stock_number": "",
      "name": "Raspberry Pi Zero (2 W, Wireless/Bluetooth) 2021",
      "price": 22.0,
      "currency": "USD",
      "availability": "No stock warning",
      "purchase_restriction": "",
      "categories": [
        {
          "id": "689",
          "name": "Arduinos & Boards",
          "path": "Electronics > Arduinos & Boards",
          "url": "https://epay.gatech.edu/C20793_ustores/web/store_cat.jsp?STOREID=324&CATID=689&SINGLESTORE=true"
        }
      ],
      "listing_descriptions": [],
      "product_description": "",
      "options": [],
      "reference_urls": [],
      "image_urls": [
        "https://epay.gatech.edu/C20793_ustores/web/uploaded_images/guid/d/5/9054c4-cedc-4838-bf3a-c864b30b4556.jpg"
      ],
      "source_url": "https://epay.gatech.edu/C20793_ustores/web/product_detail.jsp?PRODUCTID=6267&SINGLESTORE=true",
      "category_source_urls": [
        "https://epay.gatech.edu/C20793_ustores/web/store_cat.jsp?STOREID=324&CATID=689&SINGLESTORE=true"
      ],
      "notes": ""
    },
    {
      "product_id": "6258",
      "stock_number": "",
      "name": "1602 LCD Display Module 16x02",
      "price": 4.0,
      "currency": "USD",
      "availability": "No stock warning",
      "purchase_restriction": "",
      "categories": [
        {
          "id": "690",
          "name": "Components",
          "path": "Electronics > Components",
          "url": "https://epay.gatech.edu/C20793_ustores/web/store_cat.jsp?STOREID=324&CATID=690&SINGLESTORE=true"
        }
      ],
      "listing_descriptions": [],
      "product_description": "",
      "options": [],
      "reference_urls": [],
      "image_urls": [
        "https://epay.gatech.edu/C20793_ustores/web/uploaded_images/guid/f/f/e9789c-e3e8-4f87-bb95-e25aa4c049c8.jpg"
      ],
      "source_url": "https://epay.gatech.edu/C20793_ustores/web/product_detail.jsp?PRODUCTID=6258&SINGLESTORE=true",
      "category_source_urls": [
        "https://epay.gatech.edu/C20793_ustores/web/store_cat.jsp?STOREID=324&CATID=690&SINGLESTORE=true"
      ],
      "notes": ""
    },
    {
      "product_id": "6268",
      "stock_number": "",
      "name": "Teyleten Robot Dual-axis XY Joystick Module",
      "price": 2.0,
      "currency": "USD",
      "availability": "No stock warning",
      "purchase_restriction": "",
      "categories": [
        {
          "id": "690",
          "name": "Components",
          "path": "Electronics > Components",
          "url": "https://epay.gatech.edu/C20793_ustores/web/store_cat.jsp?STOREID=324&CATID=690&SINGLESTORE=true"
        }
      ],
      "listing_descriptions": [],
      "product_description": "",
      "options": [],
      "reference_urls": [],
      "image_urls": [
        "https://epay.gatech.edu/C20793_ustores/web/uploaded_images/guid/1/0/fd9bf2-fa16-4065-956a-919519b32b66.jpg"
      ],
      "source_url": "https://epay.gatech.edu/C20793_ustores/web/product_detail.jsp?PRODUCTID=6268&SINGLESTORE=true",
      "category_source_urls": [
        "https://epay.gatech.edu/C20793_ustores/web/store_cat.jsp?STOREID=324&CATID=690&SINGLESTORE=true"
      ],
      "notes": ""
    },
    {
      "product_id": "6271",
      "stock_number": "",
      "name": "TMC2208 Stepper Motor Driver",
      "price": 4.0,
      "currency": "USD",
      "availability": "No stock warning",
      "purchase_restriction": "",
      "categories": [
        {
          "id": "690",
          "name": "Components",
          "path": "Electronics > Components",
          "url": "https://epay.gatech.edu/C20793_ustores/web/store_cat.jsp?STOREID=324&CATID=690&SINGLESTORE=true"
        }
      ],
      "listing_descriptions": [],
      "product_description": "",
      "options": [],
      "reference_urls": [],
      "image_urls": [
        "https://epay.gatech.edu/C20793_ustores/web/uploaded_images/guid/f/c/9423c7-5a3f-4eb8-a132-db857680efea.jpg"
      ],
      "source_url": "https://epay.gatech.edu/C20793_ustores/web/product_detail.jsp?PRODUCTID=6271&SINGLESTORE=true",
      "category_source_urls": [
        "https://epay.gatech.edu/C20793_ustores/web/store_cat.jsp?STOREID=324&CATID=690&SINGLESTORE=true"
      ],
      "notes": ""
    },
    {
      "product_id": "6264",
      "stock_number": "",
      "name": "MG995 55G Micro Servo Motor Metal Geared Motor Kit",
      "price": 7.0,
      "currency": "USD",
      "availability": "No stock warning",
      "purchase_restriction": "",
      "categories": [
        {
          "id": "692",
          "name": "Mechatronics",
          "path": "Electronics > Mechatronics",
          "url": "https://epay.gatech.edu/C20793_ustores/web/store_cat.jsp?STOREID=324&CATID=692&SINGLESTORE=true"
        }
      ],
      "listing_descriptions": [],
      "product_description": "",
      "options": [],
      "reference_urls": [],
      "image_urls": [
        "https://epay.gatech.edu/C20793_ustores/web/uploaded_images/guid/8/b/e4ef9f-39f8-4cb5-b28d-e223a29b4a9a.jpg"
      ],
      "source_url": "https://epay.gatech.edu/C20793_ustores/web/product_detail.jsp?PRODUCTID=6264&SINGLESTORE=true",
      "category_source_urls": [
        "https://epay.gatech.edu/C20793_ustores/web/store_cat.jsp?STOREID=324&CATID=692&SINGLESTORE=true"
      ],
      "notes": ""
    },
    {
      "product_id": "6265",
      "stock_number": "",
      "name": "Miuzei MG90S 9G Metal Geared Micro Servo Motor",
      "price": 3.5,
      "currency": "USD",
      "availability": "No stock warning",
      "purchase_restriction": "",
      "categories": [
        {
          "id": "692",
          "name": "Mechatronics",
          "path": "Electronics > Mechatronics",
          "url": "https://epay.gatech.edu/C20793_ustores/web/store_cat.jsp?STOREID=324&CATID=692&SINGLESTORE=true"
        }
      ],
      "listing_descriptions": [],
      "product_description": "",
      "options": [],
      "reference_urls": [],
      "image_urls": [
        "https://epay.gatech.edu/C20793_ustores/web/uploaded_images/guid/3/6/1064dd-eba7-4c99-a8e4-c0df6e08d969.jpg"
      ],
      "source_url": "https://epay.gatech.edu/C20793_ustores/web/product_detail.jsp?PRODUCTID=6265&SINGLESTORE=true",
      "category_source_urls": [
        "https://epay.gatech.edu/C20793_ustores/web/store_cat.jsp?STOREID=324&CATID=692&SINGLESTORE=true"
      ],
      "notes": ""
    },
    {
      "product_id": "6266",
      "stock_number": "",
      "name": "Nema 17 Stepper Motor",
      "price": 14.0,
      "currency": "USD",
      "availability": "No stock warning",
      "purchase_restriction": "",
      "categories": [
        {
          "id": "692",
          "name": "Mechatronics",
          "path": "Electronics > Mechatronics",
          "url": "https://epay.gatech.edu/C20793_ustores/web/store_cat.jsp?STOREID=324&CATID=692&SINGLESTORE=true"
        }
      ],
      "listing_descriptions": [],
      "product_description": "",
      "options": [],
      "reference_urls": [],
      "image_urls": [
        "https://epay.gatech.edu/C20793_ustores/web/uploaded_images/guid/a/d/fc28d0-7a46-43b5-a6ee-9d12c222095f.jpg"
      ],
      "source_url": "https://epay.gatech.edu/C20793_ustores/web/product_detail.jsp?PRODUCTID=6266&SINGLESTORE=true",
      "category_source_urls": [
        "https://epay.gatech.edu/C20793_ustores/web/store_cat.jsp?STOREID=324&CATID=692&SINGLESTORE=true"
      ],
      "notes": ""
    },
    {
      "product_id": "6449",
      "stock_number": "",
      "name": "Self-Balancing Robot Kit for Arduino",
      "price": 55.99,
      "currency": "USD",
      "availability": "No stock warning",
      "purchase_restriction": "ME4405 students only",
      "categories": [
        {
          "id": "692",
          "name": "Mechatronics",
          "path": "Electronics > Mechatronics",
          "url": "https://epay.gatech.edu/C20793_ustores/web/store_cat.jsp?STOREID=324&CATID=692&SINGLESTORE=true"
        }
      ],
      "listing_descriptions": [
        "**THIS PRODUCT IS FOR ME4405 STUDENTS ONLY**\n\nTumbller is a newly design for Arduino project of robotic car kit which has multiple fascinating functions like auto-follow, obstacle avoidance, bouncing mode and glowing in different LED colors and also you can control it with your mobile phone using our new ElegooKit APP"
      ],
      "product_description": "**THIS PRODUCT IS FOR ME4405 STUDENTS ONLY**\n\nTumbller is a newly design for Arduino project of robotic car kit which has multiple fascinating functions like auto-follow, obstacle avoidance, bouncing mode and glowing in different LED colors and also you can control it with your mobile phone using our new ElegooKit APP",
      "options": [],
      "reference_urls": [],
      "image_urls": [
        "https://epay.gatech.edu/C20793_ustores/web/uploaded_images/guid/4/8/828d04-be17-401a-8321-624df409a5d1.jpg"
      ],
      "source_url": "https://epay.gatech.edu/C20793_ustores/web/product_detail.jsp?PRODUCTID=6449&SINGLESTORE=true",
      "category_source_urls": [
        "https://epay.gatech.edu/C20793_ustores/web/store_cat.jsp?STOREID=324&CATID=692&SINGLESTORE=true"
      ],
      "notes": ""
    },
    {
      "product_id": "6448",
      "stock_number": "",
      "name": "STMicroelectronics NUCLEO-L476RG",
      "price": 14.83,
      "currency": "USD",
      "availability": "No stock warning",
      "purchase_restriction": "ME4405 students only",
      "categories": [
        {
          "id": "692",
          "name": "Mechatronics",
          "path": "Electronics > Mechatronics",
          "url": "https://epay.gatech.edu/C20793_ustores/web/store_cat.jsp?STOREID=324&CATID=692&SINGLESTORE=true"
        }
      ],
      "listing_descriptions": [
        "**THIS PRODUCT IS FOR ME4405 STUDENTS ONLY**\n\nDevelopment Boards & Kits - ARM STM32 Nucleo-64 development board STM32L476RG MCU, supports Arduino & ST morpho"
      ],
      "product_description": "**THIS PRODUCT IS FOR ME4405 STUDENTS ONLY**\n\nDevelopment Boards & Kits - ARM STM32 Nucleo-64 development board STM32L476RG MCU, supports Arduino & ST morpho",
      "options": [],
      "reference_urls": [],
      "image_urls": [
        "https://epay.gatech.edu/C20793_ustores/web/uploaded_images/guid/3/e/eba76d-1829-4b91-bf48-ffd64b6d6a3d.png"
      ],
      "source_url": "https://epay.gatech.edu/C20793_ustores/web/product_detail.jsp?PRODUCTID=6448&SINGLESTORE=true",
      "category_source_urls": [
        "https://epay.gatech.edu/C20793_ustores/web/store_cat.jsp?STOREID=324&CATID=692&SINGLESTORE=true"
      ],
      "notes": ""
    },
    {
      "product_id": "6270",
      "stock_number": "",
      "name": "TT Motor Dual DC with 1:48 Gearbox and Tire Wheel",
      "price": 2.25,
      "currency": "USD",
      "availability": "No stock warning",
      "purchase_restriction": "",
      "categories": [
        {
          "id": "692",
          "name": "Mechatronics",
          "path": "Electronics > Mechatronics",
          "url": "https://epay.gatech.edu/C20793_ustores/web/store_cat.jsp?STOREID=324&CATID=692&SINGLESTORE=true"
        }
      ],
      "listing_descriptions": [],
      "product_description": "",
      "options": [],
      "reference_urls": [],
      "image_urls": [
        "https://epay.gatech.edu/C20793_ustores/web/uploaded_images/guid/1/9/fd2189-3c02-4bb0-9964-5ae0751acb6d.jpg"
      ],
      "source_url": "https://epay.gatech.edu/C20793_ustores/web/product_detail.jsp?PRODUCTID=6270&SINGLESTORE=true",
      "category_source_urls": [
        "https://epay.gatech.edu/C20793_ustores/web/store_cat.jsp?STOREID=324&CATID=692&SINGLESTORE=true"
      ],
      "notes": ""
    },
    {
      "product_id": "6287",
      "stock_number": "",
      "name": "1/16 x 12 x 12 inch - 1.5mm Basswood Sheets Plywood Sheets",
      "price": 1.0,
      "currency": "USD",
      "availability": "No stock warning",
      "purchase_restriction": "",
      "categories": [
        {
          "id": "687",
          "name": "Laser Cutting Materials",
          "path": "Laser Cutting Materials",
          "url": "https://epay.gatech.edu/C20793_ustores/web/store_cat.jsp?STOREID=324&CATID=687&SINGLESTORE=true"
        },
        {
          "id": "684",
          "name": "Wood-Working",
          "path": "Wood-Working",
          "url": "https://epay.gatech.edu/C20793_ustores/web/store_cat.jsp?STOREID=324&CATID=684&SINGLESTORE=true"
        }
      ],
      "listing_descriptions": [],
      "product_description": "",
      "options": [],
      "reference_urls": [],
      "image_urls": [],
      "source_url": "https://epay.gatech.edu/C20793_ustores/web/product_detail.jsp?PRODUCTID=6287&SINGLESTORE=true",
      "category_source_urls": [
        "https://epay.gatech.edu/C20793_ustores/web/store_cat.jsp?STOREID=324&CATID=687&SINGLESTORE=true",
        "https://epay.gatech.edu/C20793_ustores/web/store_cat.jsp?STOREID=324&CATID=684&SINGLESTORE=true"
      ],
      "notes": ""
    },
    {
      "product_id": "5555",
      "stock_number": "",
      "name": "\"It's an Invention Studio Thing\" Hoodie",
      "price": 25.0,
      "currency": "USD",
      "availability": "No stock warning",
      "purchase_restriction": "",
      "categories": [
        {
          "id": "667",
          "name": "Merchandise",
          "path": "Merchandise",
          "url": "https://epay.gatech.edu/C20793_ustores/web/store_cat.jsp?STOREID=324&CATID=667&SINGLESTORE=true"
        }
      ],
      "listing_descriptions": [
        "\"It's an Invention Studio Thing\" Hoodie"
      ],
      "product_description": "",
      "options": [
        {
          "name": "Size",
          "values": [
            "Small",
            "Medium",
            "Large"
          ],
          "source_field_id": "orderOpt23255550"
        }
      ],
      "reference_urls": [],
      "image_urls": [
        "https://epay.gatech.edu/C20793_ustores/web/uploaded_images/store_324/WhiteHoodieBack.png",
        "https://epay.gatech.edu/C20793_ustores/web/uploaded_images/store_324/WhiteHoodie.png"
      ],
      "source_url": "https://epay.gatech.edu/C20793_ustores/web/product_detail.jsp?PRODUCTID=5555&SINGLESTORE=true",
      "category_source_urls": [
        "https://epay.gatech.edu/C20793_ustores/web/store_cat.jsp?STOREID=324&CATID=667&SINGLESTORE=true"
      ],
      "notes": ""
    },
    {
      "product_id": "5552",
      "stock_number": "",
      "name": "70's Theme Invention Studio Hoodie",
      "price": 25.0,
      "currency": "USD",
      "availability": "No stock warning",
      "purchase_restriction": "",
      "categories": [
        {
          "id": "667",
          "name": "Merchandise",
          "path": "Merchandise",
          "url": "https://epay.gatech.edu/C20793_ustores/web/store_cat.jsp?STOREID=324&CATID=667&SINGLESTORE=true"
        }
      ],
      "listing_descriptions": [
        "70's Theme Hoodie"
      ],
      "product_description": "",
      "options": [
        {
          "name": "Size",
          "values": [
            "Small",
            "Medium",
            "Large"
          ],
          "source_field_id": "orderOpt23355520"
        }
      ],
      "reference_urls": [],
      "image_urls": [
        "https://epay.gatech.edu/C20793_ustores/web/uploaded_images/store_324/YellowHoodieBack(1).png",
        "https://epay.gatech.edu/C20793_ustores/web/uploaded_images/store_324/YellowHoodie(1).png"
      ],
      "source_url": "https://epay.gatech.edu/C20793_ustores/web/product_detail.jsp?PRODUCTID=5552&SINGLESTORE=true",
      "category_source_urls": [
        "https://epay.gatech.edu/C20793_ustores/web/store_cat.jsp?STOREID=324&CATID=667&SINGLESTORE=true"
      ],
      "notes": ""
    },
    {
      "product_id": "5888",
      "stock_number": "317",
      "name": "Beanie",
      "price": 10.0,
      "currency": "USD",
      "availability": "No stock warning",
      "purchase_restriction": "",
      "categories": [
        {
          "id": "667",
          "name": "Merchandise",
          "path": "Merchandise",
          "url": "https://epay.gatech.edu/C20793_ustores/web/store_cat.jsp?STOREID=324&CATID=667&SINGLESTORE=true"
        }
      ],
      "listing_descriptions": [
        "Invention Studio Beanie"
      ],
      "product_description": "",
      "options": [],
      "reference_urls": [],
      "image_urls": [
        "https://epay.gatech.edu/C20793_ustores/web/uploaded_images/guid/1/a/023288-6c73-458b-8409-15f03675937c.png"
      ],
      "source_url": "https://epay.gatech.edu/C20793_ustores/web/product_detail.jsp?PRODUCTID=5888&SINGLESTORE=true",
      "category_source_urls": [
        "https://epay.gatech.edu/C20793_ustores/web/store_cat.jsp?STOREID=324&CATID=667&SINGLESTORE=true"
      ],
      "notes": ""
    },
    {
      "product_id": "6348",
      "stock_number": "",
      "name": "Metal Name Cards",
      "price": 0.6,
      "currency": "USD",
      "availability": "No stock warning",
      "purchase_restriction": "",
      "categories": [
        {
          "id": "667",
          "name": "Merchandise",
          "path": "Merchandise",
          "url": "https://epay.gatech.edu/C20793_ustores/web/store_cat.jsp?STOREID=324&CATID=667&SINGLESTORE=true"
        }
      ],
      "listing_descriptions": [
        "Metal Business Cards"
      ],
      "product_description": "https://www.amazon.com/PATIKIL-Stainless-Business-Engraving-Silver/dp/B0DY744LD1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",
      "options": [],
      "reference_urls": [
        "https://www.amazon.com/PATIKIL-Stainless-Business-Engraving-Silver/dp/B0DY744LD1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"
      ],
      "image_urls": [
        "https://epay.gatech.edu/C20793_ustores/web/uploaded_images/guid/7/5/bfe2cb-ea92-49fe-bdf9-f84bf2127c59.jpg"
      ],
      "source_url": "https://epay.gatech.edu/C20793_ustores/web/product_detail.jsp?PRODUCTID=6348&SINGLESTORE=true",
      "category_source_urls": [
        "https://epay.gatech.edu/C20793_ustores/web/store_cat.jsp?STOREID=324&CATID=667&SINGLESTORE=true"
      ],
      "notes": ""
    },
    {
      "product_id": "5887",
      "stock_number": "",
      "name": "White T-Shirt",
      "price": 15.0,
      "currency": "USD",
      "availability": "No stock warning",
      "purchase_restriction": "",
      "categories": [
        {
          "id": "667",
          "name": "Merchandise",
          "path": "Merchandise",
          "url": "https://epay.gatech.edu/C20793_ustores/web/store_cat.jsp?STOREID=324&CATID=667&SINGLESTORE=true"
        }
      ],
      "listing_descriptions": [
        "White Invention Studio T-Shirt"
      ],
      "product_description": "",
      "options": [
        {
          "name": "Size",
          "values": [
            "Small",
            "Medium",
            "Large"
          ],
          "source_field_id": "orderOpt27658870"
        }
      ],
      "reference_urls": [],
      "image_urls": [
        "https://epay.gatech.edu/C20793_ustores/web/uploaded_images/guid/d/7/49f504-95af-400a-b4d0-73d699d39d8f.png",
        "https://epay.gatech.edu/C20793_ustores/web/uploaded_images/guid/d/2/d9e11b-e784-4d6f-8035-a06fc6081b09.png"
      ],
      "source_url": "https://epay.gatech.edu/C20793_ustores/web/product_detail.jsp?PRODUCTID=5887&SINGLESTORE=true",
      "category_source_urls": [
        "https://epay.gatech.edu/C20793_ustores/web/store_cat.jsp?STOREID=324&CATID=667&SINGLESTORE=true"
      ],
      "notes": ""
    },
    {
      "product_id": "5886",
      "stock_number": "",
      "name": "Yellow T-Shirt",
      "price": 15.0,
      "currency": "USD",
      "availability": "No stock warning",
      "purchase_restriction": "",
      "categories": [
        {
          "id": "667",
          "name": "Merchandise",
          "path": "Merchandise",
          "url": "https://epay.gatech.edu/C20793_ustores/web/store_cat.jsp?STOREID=324&CATID=667&SINGLESTORE=true"
        }
      ],
      "listing_descriptions": [
        "Yellow Invention Studio T-Shirt"
      ],
      "product_description": "",
      "options": [
        {
          "name": "Size",
          "values": [
            "Small",
            "Medium",
            "Large",
            "X-Large"
          ],
          "source_field_id": "orderOpt27558860"
        }
      ],
      "reference_urls": [],
      "image_urls": [
        "https://epay.gatech.edu/C20793_ustores/web/uploaded_images/guid/4/0/ec9d7c-10ab-4842-aa5b-9fc5bba0b70e.png",
        "https://epay.gatech.edu/C20793_ustores/web/uploaded_images/guid/6/a/a7bc50-c17a-4e44-a092-3d4895879708.png"
      ],
      "source_url": "https://epay.gatech.edu/C20793_ustores/web/product_detail.jsp?PRODUCTID=5886&SINGLESTORE=true",
      "category_source_urls": [
        "https://epay.gatech.edu/C20793_ustores/web/store_cat.jsp?STOREID=324&CATID=667&SINGLESTORE=true"
      ],
      "notes": ""
    },
    {
      "product_id": "6307",
      "stock_number": "",
      "name": "6mm x 300mm 304 SS axle/shaft",
      "price": 2.75,
      "currency": "USD",
      "availability": "Out of stock",
      "purchase_restriction": "",
      "categories": [
        {
          "id": "685",
          "name": "Metal-Working",
          "path": "Metal-Working",
          "url": "https://epay.gatech.edu/C20793_ustores/web/store_cat.jsp?STOREID=324&CATID=685&SINGLESTORE=true"
        }
      ],
      "listing_descriptions": [],
      "product_description": "",
      "options": [],
      "reference_urls": [],
      "image_urls": [
        "https://epay.gatech.edu/C20793_ustores/web/uploaded_images/guid/a/4/0c188f-83e6-4713-afdf-3c09d0dccc79.png"
      ],
      "source_url": "https://epay.gatech.edu/C20793_ustores/web/product_detail.jsp?PRODUCTID=6307&SINGLESTORE=true",
      "category_source_urls": [
        "https://epay.gatech.edu/C20793_ustores/web/store_cat.jsp?STOREID=324&CATID=685&SINGLESTORE=true"
      ],
      "notes": ""
    },
    {
      "product_id": "6308",
      "stock_number": "",
      "name": "6mm x 40mm dowel pin/shaft (35 pk)",
      "price": 9.25,
      "currency": "USD",
      "availability": "No stock warning",
      "purchase_restriction": "",
      "categories": [
        {
          "id": "685",
          "name": "Metal-Working",
          "path": "Metal-Working",
          "url": "https://epay.gatech.edu/C20793_ustores/web/store_cat.jsp?STOREID=324&CATID=685&SINGLESTORE=true"
        }
      ],
      "listing_descriptions": [],
      "product_description": "",
      "options": [],
      "reference_urls": [],
      "image_urls": [
        "https://epay.gatech.edu/C20793_ustores/web/uploaded_images/guid/3/7/627ef5-3541-4ad8-a7f1-0ed0219aa0d3.jpg"
      ],
      "source_url": "https://epay.gatech.edu/C20793_ustores/web/product_detail.jsp?PRODUCTID=6308&SINGLESTORE=true",
      "category_source_urls": [
        "https://epay.gatech.edu/C20793_ustores/web/store_cat.jsp?STOREID=324&CATID=685&SINGLESTORE=true"
      ],
      "notes": ""
    },
    {
      "product_id": "6311",
      "stock_number": "",
      "name": "M6 threaded rod 300mm long",
      "price": 3.75,
      "currency": "USD",
      "availability": "No stock warning",
      "purchase_restriction": "",
      "categories": [
        {
          "id": "685",
          "name": "Metal-Working",
          "path": "Metal-Working",
          "url": "https://epay.gatech.edu/C20793_ustores/web/store_cat.jsp?STOREID=324&CATID=685&SINGLESTORE=true"
        }
      ],
      "listing_descriptions": [],
      "product_description": "",
      "options": [],
      "reference_urls": [],
      "image_urls": [
        "https://epay.gatech.edu/C20793_ustores/web/uploaded_images/guid/0/0/bb3a22-022f-465f-840a-70726dc4488c.jpg"
      ],
      "source_url": "https://epay.gatech.edu/C20793_ustores/web/product_detail.jsp?PRODUCTID=6311&SINGLESTORE=true",
      "category_source_urls": [
        "https://epay.gatech.edu/C20793_ustores/web/store_cat.jsp?STOREID=324&CATID=685&SINGLESTORE=true"
      ],
      "notes": ""
    },
    {
      "product_id": "4984",
      "stock_number": "91",
      "name": "1 in. x 2 ft. x 2 ft. R-5 Small Projects Rigid Pink Foam Board",
      "price": 6.0,
      "currency": "USD",
      "availability": "No stock warning",
      "purchase_restriction": "",
      "categories": [
        {
          "id": "572",
          "name": "Miscellaneous",
          "path": "Miscellaneous",
          "url": "https://epay.gatech.edu/C20793_ustores/web/store_cat.jsp?STOREID=324&CATID=572&SINGLESTORE=true"
        }
      ],
      "listing_descriptions": [
        "The Home Depot link (for reference only)\nPlease place orders on the Invention Studio store site for free pickup at the Studio Store"
      ],
      "product_description": "The Home Depot link (for reference only)\nPlease place orders on the Invention Studio store site for free pickup at the Studio Store",
      "options": [],
      "reference_urls": [
        "https://www.homedepot.com/p/Project-Panels-FOAMULAR-1-in-x-2-ft-x-2-ft-R-5-Small-Projects-Rigid-Pink-Foam-Board-Insulation-Sheathing-PP1/203553730"
      ],
      "image_urls": [
        "https://epay.gatech.edu/C20793_ustores/web/uploaded_images/store_324/Screenshot_2021-05-02_142528.jpg"
      ],
      "source_url": "https://epay.gatech.edu/C20793_ustores/web/product_detail.jsp?PRODUCTID=4984&SINGLESTORE=true",
      "category_source_urls": [
        "https://epay.gatech.edu/C20793_ustores/web/store_cat.jsp?STOREID=324&CATID=572&SINGLESTORE=true"
      ],
      "notes": ""
    },
    {
      "product_id": "6111",
      "stock_number": "170001",
      "name": "10 in. Full Extension Side Mount Ball Bearing Drawer Slide Set (2 slides per pack)",
      "price": 9.5,
      "currency": "USD",
      "availability": "No stock warning",
      "purchase_restriction": "",
      "categories": [
        {
          "id": "572",
          "name": "Miscellaneous",
          "path": "Miscellaneous",
          "url": "https://epay.gatech.edu/C20793_ustores/web/store_cat.jsp?STOREID=324&CATID=572&SINGLESTORE=true"
        }
      ],
      "listing_descriptions": [
        "https://www.homedepot.com/p/Everbilt-14-in-Full-Extension-Side-Mount-Ball-Bearing-Drawer-Slide-Set-1-Pair-2-Pieces-D80614E-ZP-W/302867645"
      ],
      "product_description": "",
      "options": [],
      "reference_urls": [
        "https://www.homedepot.com/p/Everbilt-14-in-Full-Extension-Side-Mount-Ball-Bearing-Drawer-Slide-Set-1-Pair-2-Pieces-D80614E-ZP-W/302867645"
      ],
      "image_urls": [
        "https://epay.gatech.edu/C20793_ustores/web/uploaded_images/guid/c/b/274ad0-eb6c-481d-af6c-9f2b0b440097.png"
      ],
      "source_url": "https://epay.gatech.edu/C20793_ustores/web/product_detail.jsp?PRODUCTID=6111&SINGLESTORE=true",
      "category_source_urls": [
        "https://epay.gatech.edu/C20793_ustores/web/store_cat.jsp?STOREID=324&CATID=572&SINGLESTORE=true"
      ],
      "notes": ""
    },
    {
      "product_id": "6229",
      "stock_number": "",
      "name": "17\"x11\"x11\" Cardboard Box",
      "price": 1.0,
      "currency": "USD",
      "availability": "Out of stock",
      "purchase_restriction": "",
      "categories": [
        {
          "id": "572",
          "name": "Miscellaneous",
          "path": "Miscellaneous",
          "url": "https://epay.gatech.edu/C20793_ustores/web/store_cat.jsp?STOREID=324&CATID=572&SINGLESTORE=true"
        }
      ],
      "listing_descriptions": [],
      "product_description": "",
      "options": [],
      "reference_urls": [],
      "image_urls": [
        "https://epay.gatech.edu/C20793_ustores/web/uploaded_images/guid/8/7/c08017-1672-41b1-9b68-e1f88a7f46b7.png"
      ],
      "source_url": "https://epay.gatech.edu/C20793_ustores/web/product_detail.jsp?PRODUCTID=6229&SINGLESTORE=true",
      "category_source_urls": [
        "https://epay.gatech.edu/C20793_ustores/web/store_cat.jsp?STOREID=324&CATID=572&SINGLESTORE=true"
      ],
      "notes": ""
    },
    {
      "product_id": "4876",
      "stock_number": "170003",
      "name": "18 in. Full Extension Side Mount Ball Bearing Drawer Slide Set (2 slides per pack)",
      "price": 16.0,
      "currency": "USD",
      "availability": "No stock warning",
      "purchase_restriction": "",
      "categories": [
        {
          "id": "572",
          "name": "Miscellaneous",
          "path": "Miscellaneous",
          "url": "https://epay.gatech.edu/C20793_ustores/web/store_cat.jsp?STOREID=324&CATID=572&SINGLESTORE=true"
        }
      ],
      "listing_descriptions": [
        "The Home Depot link (for reference only)\nPlease place orders on the Invention Studio store site for free pickup at the Studio Store"
      ],
      "product_description": "The Home Depot link (for reference only)\nPlease place orders on the Invention Studio store site for free pickup at the Studio Store",
      "options": [],
      "reference_urls": [
        "https://www.homedepot.com/p/Everbilt-18-in-Full-Extension-Side-Mount-Ball-Bearing-Drawer-Slide-Set-D80618E-ZP-W/302867747"
      ],
      "image_urls": [
        "https://epay.gatech.edu/C20793_ustores/web/uploaded_images/store_324/Screen_Shot_2021-02-17_at_11.46.29_AM.png"
      ],
      "source_url": "https://epay.gatech.edu/C20793_ustores/web/product_detail.jsp?PRODUCTID=4876&SINGLESTORE=true",
      "category_source_urls": [
        "https://epay.gatech.edu/C20793_ustores/web/store_cat.jsp?STOREID=324&CATID=572&SINGLESTORE=true"
      ],
      "notes": ""
    },
    {
      "product_id": "6166",
      "stock_number": "170005",
      "name": "26 in. Full Extension Side Mount Ball Bearing Drawer Slide Set (2 slides per pack)",
      "price": 18.0,
      "currency": "USD",
      "availability": "No stock warning",
      "purchase_restriction": "",
      "categories": [
        {
          "id": "572",
          "name": "Miscellaneous",
          "path": "Miscellaneous",
          "url": "https://epay.gatech.edu/C20793_ustores/web/store_cat.jsp?STOREID=324&CATID=572&SINGLESTORE=true"
        }
      ],
      "listing_descriptions": [
        "https://www.homedepot.com/p/Everbilt-24-in-Full-Extension-Side-Mount-Ball-Bearing-Drawer-Slide-Set-1-Pair-2-Pieces-D80624E-ZP-W/302854652"
      ],
      "product_description": "",
      "options": [],
      "reference_urls": [
        "https://www.homedepot.com/p/Everbilt-24-in-Full-Extension-Side-Mount-Ball-Bearing-Drawer-Slide-Set-1-Pair-2-Pieces-D80624E-ZP-W/302854652"
      ],
      "image_urls": [
        "https://epay.gatech.edu/C20793_ustores/web/uploaded_images/guid/a/3/1b834e-f3e0-4f6d-954a-ac53d5353c6f.png"
      ],
      "source_url": "https://epay.gatech.edu/C20793_ustores/web/product_detail.jsp?PRODUCTID=6166&SINGLESTORE=true",
      "category_source_urls": [
        "https://epay.gatech.edu/C20793_ustores/web/store_cat.jsp?STOREID=324&CATID=572&SINGLESTORE=true"
      ],
      "notes": ""
    },
    {
      "product_id": "6112",
      "stock_number": "170006",
      "name": "28 in. Full Extension Side Mount Ball Bearing Drawer Slide Set (2 slides per pack)",
      "price": 20.0,
      "currency": "USD",
      "availability": "No stock warning",
      "purchase_restriction": "",
      "categories": [
        {
          "id": "572",
          "name": "Miscellaneous",
          "path": "Miscellaneous",
          "url": "https://epay.gatech.edu/C20793_ustores/web/store_cat.jsp?STOREID=324&CATID=572&SINGLESTORE=true"
        }
      ],
      "listing_descriptions": [
        "The Home Depot link (for reference only)\nPlease place orders on the Invention Studio store site for free pickup at the Studio Store"
      ],
      "product_description": "The Home Depot link (for reference only)\nPlease place orders on the Invention Studio store site for free pickup at the Studio Store",
      "options": [],
      "reference_urls": [
        "https://www.homedepot.com/p/Everbilt-22-in-Full-Extension-Side-Mount-Ball-Bearing-Drawer-Slide-Set-D80622E-ZP-W/302867528"
      ],
      "image_urls": [
        "https://epay.gatech.edu/C20793_ustores/web/uploaded_images/guid/f/2/1443d4-c3a3-4438-bc59-8bb7f284c813.png"
      ],
      "source_url": "https://epay.gatech.edu/C20793_ustores/web/product_detail.jsp?PRODUCTID=6112&SINGLESTORE=true",
      "category_source_urls": [
        "https://epay.gatech.edu/C20793_ustores/web/store_cat.jsp?STOREID=324&CATID=572&SINGLESTORE=true"
      ],
      "notes": ""
    },
    {
      "product_id": "6727",
      "stock_number": "",
      "name": "606-2RS Bearing 6x17x6mm",
      "price": 9.99,
      "currency": "USD",
      "availability": "No stock warning",
      "purchase_restriction": "",
      "categories": [
        {
          "id": "572",
          "name": "Miscellaneous",
          "path": "Miscellaneous",
          "url": "https://epay.gatech.edu/C20793_ustores/web/store_cat.jsp?STOREID=324&CATID=572&SINGLESTORE=true"
        },
        {
          "id": "696",
          "name": "Slides, Pulleys, Belts, and Bearings",
          "path": "Slides, Pulleys, Belts, and Bearings",
          "url": "https://epay.gatech.edu/C20793_ustores/web/store_cat.jsp?STOREID=324&CATID=696&SINGLESTORE=true"
        }
      ],
      "listing_descriptions": [],
      "product_description": "",
      "options": [],
      "reference_urls": [],
      "image_urls": [
        "https://epay.gatech.edu/C20793_ustores/web/uploaded_images/guid/5/0/6b7aef-7d54-4c77-a25d-3e527189be8e.jpg"
      ],
      "source_url": "https://epay.gatech.edu/C20793_ustores/web/product_detail.jsp?PRODUCTID=6727&SINGLESTORE=true",
      "category_source_urls": [
        "https://epay.gatech.edu/C20793_ustores/web/store_cat.jsp?STOREID=324&CATID=572&SINGLESTORE=true",
        "https://epay.gatech.edu/C20793_ustores/web/store_cat.jsp?STOREID=324&CATID=696&SINGLESTORE=true"
      ],
      "notes": ""
    },
    {
      "product_id": "6309",
      "stock_number": "",
      "name": "7\" Steel Wheel",
      "price": 9.0,
      "currency": "USD",
      "availability": "No stock warning",
      "purchase_restriction": "",
      "categories": [
        {
          "id": "572",
          "name": "Miscellaneous",
          "path": "Miscellaneous",
          "url": "https://epay.gatech.edu/C20793_ustores/web/store_cat.jsp?STOREID=324&CATID=572&SINGLESTORE=true"
        }
      ],
      "listing_descriptions": [],
      "product_description": "",
      "options": [],
      "reference_urls": [],
      "image_urls": [],
      "source_url": "https://epay.gatech.edu/C20793_ustores/web/product_detail.jsp?PRODUCTID=6309&SINGLESTORE=true",
      "category_source_urls": [
        "https://epay.gatech.edu/C20793_ustores/web/store_cat.jsp?STOREID=324&CATID=572&SINGLESTORE=true"
      ],
      "notes": ""
    },
    {
      "product_id": "5500",
      "stock_number": "125",
      "name": "Acrylic Sheet 20 in. x 32 in. x 0.093 in.",
      "price": 18.0,
      "currency": "USD",
      "availability": "No stock warning",
      "purchase_restriction": "",
      "categories": [
        {
          "id": "572",
          "name": "Miscellaneous",
          "path": "Miscellaneous",
          "url": "https://epay.gatech.edu/C20793_ustores/web/store_cat.jsp?STOREID=324&CATID=572&SINGLESTORE=true"
        }
      ],
      "listing_descriptions": [
        "The Home Depot link (for reference only)"
      ],
      "product_description": "",
      "options": [],
      "reference_urls": [
        "https://www.homedepot.com/p/OPTIX-20-in-x-32-in-x-0-093-in-Acrylic-Sheet-MC-17/202038049",
        "https://www.homedepot.com/p/OPTIX-20-in-x-32-in-x-0-093-3-32-in-Clear-Acrylic-Sheet-MC-17/202038049"
      ],
      "image_urls": [
        "https://epay.gatech.edu/C20793_ustores/web/uploaded_images/store_324/optix-acrylic-sheets-mc-17-64_600.jpg"
      ],
      "source_url": "https://epay.gatech.edu/C20793_ustores/web/product_detail.jsp?PRODUCTID=5500&SINGLESTORE=true",
      "category_source_urls": [
        "https://epay.gatech.edu/C20793_ustores/web/store_cat.jsp?STOREID=324&CATID=572&SINGLESTORE=true"
      ],
      "notes": ""
    },
    {
      "product_id": "5498",
      "stock_number": "122",
      "name": "Aluminum Bar 1/8 in. x 3/4in. x 36 in.",
      "price": 5.0,
      "currency": "USD",
      "availability": "No stock warning",
      "purchase_restriction": "",
      "categories": [
        {
          "id": "572",
          "name": "Miscellaneous",
          "path": "Miscellaneous",
          "url": "https://epay.gatech.edu/C20793_ustores/web/store_cat.jsp?STOREID=324&CATID=572&SINGLESTORE=true"
        }
      ],
      "listing_descriptions": [
        "Aluminum Bar"
      ],
      "product_description": "",
      "options": [],
      "reference_urls": [],
      "image_urls": [
        "https://epay.gatech.edu/C20793_ustores/web/uploaded_images/store_324/everbilt-flat-bars-801947-e1_600.jpg"
      ],
      "source_url": "https://epay.gatech.edu/C20793_ustores/web/product_detail.jsp?PRODUCTID=5498&SINGLESTORE=true",
      "category_source_urls": [
        "https://epay.gatech.edu/C20793_ustores/web/store_cat.jsp?STOREID=324&CATID=572&SINGLESTORE=true"
      ],
      "notes": ""
    },
    {
      "product_id": "6313",
      "stock_number": "",
      "name": "Machine Screw Assortment 440pcs M3",
      "price": 10.0,
      "currency": "USD",
      "availability": "No stock warning",
      "purchase_restriction": "",
      "categories": [
        {
          "id": "572",
          "name": "Miscellaneous",
          "path": "Miscellaneous",
          "url": "https://epay.gatech.edu/C20793_ustores/web/store_cat.jsp?STOREID=324&CATID=572&SINGLESTORE=true"
        }
      ],
      "listing_descriptions": [],
      "product_description": "",
      "options": [],
      "reference_urls": [],
      "image_urls": [
        "https://epay.gatech.edu/C20793_ustores/web/uploaded_images/guid/c/d/686dd1-77b2-4104-a4c4-86af82f0b59e.jpg"
      ],
      "source_url": "https://epay.gatech.edu/C20793_ustores/web/product_detail.jsp?PRODUCTID=6313&SINGLESTORE=true",
      "category_source_urls": [
        "https://epay.gatech.edu/C20793_ustores/web/store_cat.jsp?STOREID=324&CATID=572&SINGLESTORE=true"
      ],
      "notes": ""
    },
    {
      "product_id": "6734",
      "stock_number": "",
      "name": "Mouse Trap",
      "price": 2.5,
      "currency": "USD",
      "availability": "No stock warning",
      "purchase_restriction": "",
      "categories": [
        {
          "id": "572",
          "name": "Miscellaneous",
          "path": "Miscellaneous",
          "url": "https://epay.gatech.edu/C20793_ustores/web/store_cat.jsp?STOREID=324&CATID=572&SINGLESTORE=true"
        }
      ],
      "listing_descriptions": [],
      "product_description": "",
      "options": [],
      "reference_urls": [],
      "image_urls": [],
      "source_url": "https://epay.gatech.edu/C20793_ustores/web/product_detail.jsp?PRODUCTID=6734&SINGLESTORE=true",
      "category_source_urls": [
        "https://epay.gatech.edu/C20793_ustores/web/store_cat.jsp?STOREID=324&CATID=572&SINGLESTORE=true"
      ],
      "notes": ""
    },
    {
      "product_id": "5517",
      "stock_number": "149",
      "name": "Simpson Strong-Tie HRS 12 in. 12-Gauge Galvanized Heavy Strap Tie",
      "price": 4.0,
      "currency": "USD",
      "availability": "No stock warning",
      "purchase_restriction": "",
      "categories": [
        {
          "id": "572",
          "name": "Miscellaneous",
          "path": "Miscellaneous",
          "url": "https://epay.gatech.edu/C20793_ustores/web/store_cat.jsp?STOREID=324&CATID=572&SINGLESTORE=true"
        }
      ],
      "listing_descriptions": [
        "The Home Depot link (for reference only)"
      ],
      "product_description": "",
      "options": [],
      "reference_urls": [
        "https://www.homedepot.com/p/Simpson-Strong-Tie-HRS-12-in-12-Gauge-Galvanized-Heavy-Strap-Tie-HRS12/100375113"
      ],
      "image_urls": [
        "https://epay.gatech.edu/C20793_ustores/web/uploaded_images/store_324/Screen_Shot_2022-10-12_at_1.19.02_PM.png"
      ],
      "source_url": "https://epay.gatech.edu/C20793_ustores/web/product_detail.jsp?PRODUCTID=5517&SINGLESTORE=true",
      "category_source_urls": [
        "https://epay.gatech.edu/C20793_ustores/web/store_cat.jsp?STOREID=324&CATID=572&SINGLESTORE=true"
      ],
      "notes": ""
    },
    {
      "product_id": "5516",
      "stock_number": "148",
      "name": "Simpson Strong-Tie HRS 8 in. 12-Gauge Galvanized Heavy Strap Tie",
      "price": 3.0,
      "currency": "USD",
      "availability": "No stock warning",
      "purchase_restriction": "",
      "categories": [
        {
          "id": "572",
          "name": "Miscellaneous",
          "path": "Miscellaneous",
          "url": "https://epay.gatech.edu/C20793_ustores/web/store_cat.jsp?STOREID=324&CATID=572&SINGLESTORE=true"
        }
      ],
      "listing_descriptions": [
        "The Home Depot link (for reference only)"
      ],
      "product_description": "",
      "options": [],
      "reference_urls": [
        "https://www.homedepot.com/p/Simpson-Strong-Tie-HRS-8-in-12-Gauge-Galvanized-Heavy-Strap-Tie-HRS8/100374841"
      ],
      "image_urls": [
        "https://epay.gatech.edu/C20793_ustores/web/uploaded_images/store_324/Screen_Shot_2022-10-12_at_1.13.24_PM.png"
      ],
      "source_url": "https://epay.gatech.edu/C20793_ustores/web/product_detail.jsp?PRODUCTID=5516&SINGLESTORE=true",
      "category_source_urls": [
        "https://epay.gatech.edu/C20793_ustores/web/store_cat.jsp?STOREID=324&CATID=572&SINGLESTORE=true"
      ],
      "notes": ""
    },
    {
      "product_id": "6719",
      "stock_number": "",
      "name": "Super Glue - Clear, 3g",
      "price": 0.3,
      "currency": "USD",
      "availability": "No stock warning",
      "purchase_restriction": "",
      "categories": [
        {
          "id": "572",
          "name": "Miscellaneous",
          "path": "Miscellaneous",
          "url": "https://epay.gatech.edu/C20793_ustores/web/store_cat.jsp?STOREID=324&CATID=572&SINGLESTORE=true"
        },
        {
          "id": "683",
          "name": "Adhesives, Lubricants, & Removers",
          "path": "Adhesives, Lubricants, & Removers",
          "url": "https://epay.gatech.edu/C20793_ustores/web/store_cat.jsp?STOREID=324&CATID=683&SINGLESTORE=true"
        },
        {
          "id": "682",
          "name": "Arts & Crafts",
          "path": "Arts & Crafts",
          "url": "https://epay.gatech.edu/C20793_ustores/web/store_cat.jsp?STOREID=324&CATID=682&SINGLESTORE=true"
        }
      ],
      "listing_descriptions": [
        "48 X 3g Super Glue Clear, Strong Adhesive, Super Glue Fast Drying Cyanoacrylate Glue for Wood, Rubber, Leather, Plastic, Metal, Rhinestone Jewelry, DIY Crafts and More"
      ],
      "product_description": "",
      "options": [],
      "reference_urls": [],
      "image_urls": [
        "https://epay.gatech.edu/C20793_ustores/web/uploaded_images/guid/8/a/15ef3b-c4eb-4b87-a3f7-d2212b74201e.jpg"
      ],
      "source_url": "https://epay.gatech.edu/C20793_ustores/web/product_detail.jsp?PRODUCTID=6719&SINGLESTORE=true",
      "category_source_urls": [
        "https://epay.gatech.edu/C20793_ustores/web/store_cat.jsp?STOREID=324&CATID=572&SINGLESTORE=true",
        "https://epay.gatech.edu/C20793_ustores/web/store_cat.jsp?STOREID=324&CATID=683&SINGLESTORE=true",
        "https://epay.gatech.edu/C20793_ustores/web/store_cat.jsp?STOREID=324&CATID=682&SINGLESTORE=true"
      ],
      "notes": ""
    },
    {
      "product_id": "4901",
      "stock_number": "33",
      "name": "8 oz. Espresso Classic Wood Interior Stain",
      "price": 5.0,
      "currency": "USD",
      "availability": "No stock warning",
      "purchase_restriction": "",
      "categories": [
        {
          "id": "584",
          "name": "Paint",
          "path": "Paint",
          "url": "https://epay.gatech.edu/C20793_ustores/web/store_cat.jsp?STOREID=324&CATID=584&SINGLESTORE=true"
        }
      ],
      "listing_descriptions": [
        "The Home Depot link (for reference only)\nPlease place orders on the Invention Studio store site for free pickup at the Studio Store"
      ],
      "product_description": "The Home Depot link (for reference only)\nPlease place orders on the Invention Studio store site for free pickup at the Studio Store",
      "options": [],
      "reference_urls": [
        "https://www.homedepot.com/p/Varathane-8-oz-Espresso-Classic-Wood-Interior-Stain-4-Pack-339743/305518203"
      ],
      "image_urls": [
        "https://epay.gatech.edu/C20793_ustores/web/uploaded_images/store_324/espresso-varathane-interior-wood-stains-339743-64_1000.jpg"
      ],
      "source_url": "https://epay.gatech.edu/C20793_ustores/web/product_detail.jsp?PRODUCTID=4901&SINGLESTORE=true",
      "category_source_urls": [
        "https://epay.gatech.edu/C20793_ustores/web/store_cat.jsp?STOREID=324&CATID=584&SINGLESTORE=true"
      ],
      "notes": ""
    },
    {
      "product_id": "4902",
      "stock_number": "34",
      "name": "8 oz. Golden Oak Classic Wood Interior Stain",
      "price": 5.0,
      "currency": "USD",
      "availability": "No stock warning",
      "purchase_restriction": "",
      "categories": [
        {
          "id": "584",
          "name": "Paint",
          "path": "Paint",
          "url": "https://epay.gatech.edu/C20793_ustores/web/store_cat.jsp?STOREID=324&CATID=584&SINGLESTORE=true"
        }
      ],
      "listing_descriptions": [
        "The Home Depot link (for reference only)\nPlease place orders on the Invention Studio store site for free pickup at the Studio Store"
      ],
      "product_description": "The Home Depot link (for reference only)\nPlease place orders on the Invention Studio store site for free pickup at the Studio Store",
      "options": [],
      "reference_urls": [
        "https://www.homedepot.com/p/Varathane-8-oz-Golden-Oak-Classic-Wood-Interior-Stain-4-Pack-339726/305518190"
      ],
      "image_urls": [
        "https://epay.gatech.edu/C20793_ustores/web/uploaded_images/store_324/golden-oak-varathane-interior-wood-stains-339726-64_1000.jpg"
      ],
      "source_url": "https://epay.gatech.edu/C20793_ustores/web/product_detail.jsp?PRODUCTID=4902&SINGLESTORE=true",
      "category_source_urls": [
        "https://epay.gatech.edu/C20793_ustores/web/store_cat.jsp?STOREID=324&CATID=584&SINGLESTORE=true"
      ],
      "notes": ""
    },
    {
      "product_id": "6230",
      "stock_number": "",
      "name": "Flat Black Spray Paint & Primer",
      "price": 5.0,
      "currency": "USD",
      "availability": "No stock warning",
      "purchase_restriction": "",
      "categories": [
        {
          "id": "584",
          "name": "Paint",
          "path": "Paint",
          "url": "https://epay.gatech.edu/C20793_ustores/web/store_cat.jsp?STOREID=324&CATID=584&SINGLESTORE=true"
        }
      ],
      "listing_descriptions": [],
      "product_description": "",
      "options": [],
      "reference_urls": [],
      "image_urls": [
        "https://epay.gatech.edu/C20793_ustores/web/uploaded_images/guid/1/f/127818-b646-486e-aead-fd3400fe5a7d.png"
      ],
      "source_url": "https://epay.gatech.edu/C20793_ustores/web/product_detail.jsp?PRODUCTID=6230&SINGLESTORE=true",
      "category_source_urls": [
        "https://epay.gatech.edu/C20793_ustores/web/store_cat.jsp?STOREID=324&CATID=584&SINGLESTORE=true"
      ],
      "notes": ""
    },
    {
      "product_id": "5028",
      "stock_number": "103",
      "name": "Gloss Apple Red Spray Paint",
      "price": 5.0,
      "currency": "USD",
      "availability": "No stock warning",
      "purchase_restriction": "",
      "categories": [
        {
          "id": "584",
          "name": "Paint",
          "path": "Paint",
          "url": "https://epay.gatech.edu/C20793_ustores/web/store_cat.jsp?STOREID=324&CATID=584&SINGLESTORE=true"
        }
      ],
      "listing_descriptions": [
        "The Home Depot link (for reference only)\nPlease place orders on the Invention Studio store site for free pickup at the Studio Store"
      ],
      "product_description": "The Home Depot link (for reference only)\nPlease place orders on the Invention Studio store site for free pickup at the Studio Store",
      "options": [],
      "reference_urls": [
        "https://www.homedepot.com/p/Rust-Oleum-Painter-s-Touch-2X-12-oz-Gloss-Apple-Red-General-Purpose-Spray-Paint-334024/307244838"
      ],
      "image_urls": [
        "https://epay.gatech.edu/C20793_ustores/web/uploaded_images/store_324/Screen_Shot_2021-06-10_at_12.53.00_PM.png"
      ],
      "source_url": "https://epay.gatech.edu/C20793_ustores/web/product_detail.jsp?PRODUCTID=5028&SINGLESTORE=true",
      "category_source_urls": [
        "https://epay.gatech.edu/C20793_ustores/web/store_cat.jsp?STOREID=324&CATID=584&SINGLESTORE=true"
      ],
      "notes": ""
    },
    {
      "product_id": "5466",
      "stock_number": "110",
      "name": "Gloss Black Spray Paint",
      "price": 5.0,
      "currency": "USD",
      "availability": "No stock warning",
      "purchase_restriction": "",
      "categories": [
        {
          "id": "584",
          "name": "Paint",
          "path": "Paint",
          "url": "https://epay.gatech.edu/C20793_ustores/web/store_cat.jsp?STOREID=324&CATID=584&SINGLESTORE=true"
        }
      ],
      "listing_descriptions": [
        "Protective Enamel"
      ],
      "product_description": "",
      "options": [],
      "reference_urls": [
        "https://www.homedepot.com/p/Rust-Oleum-Stops-Rust-12-oz-Protective-Enamel-Gloss-Black-Spray-Paint-7779830/202315069"
      ],
      "image_urls": [
        "https://epay.gatech.edu/C20793_ustores/web/uploaded_images/store_324/download.jpeg"
      ],
      "source_url": "https://epay.gatech.edu/C20793_ustores/web/product_detail.jsp?PRODUCTID=5466&SINGLESTORE=true",
      "category_source_urls": [
        "https://epay.gatech.edu/C20793_ustores/web/store_cat.jsp?STOREID=324&CATID=584&SINGLESTORE=true"
      ],
      "notes": ""
    },
    {
      "product_id": "5029",
      "stock_number": "104",
      "name": "Gloss Brilliant Blue Spray Paint",
      "price": 5.0,
      "currency": "USD",
      "availability": "No stock warning",
      "purchase_restriction": "",
      "categories": [
        {
          "id": "584",
          "name": "Paint",
          "path": "Paint",
          "url": "https://epay.gatech.edu/C20793_ustores/web/store_cat.jsp?STOREID=324&CATID=584&SINGLESTORE=true"
        }
      ],
      "listing_descriptions": [
        "The Home Depot link (for reference only)\nPlease place orders on the Invention Studio store site for free pickup at the Studio Store"
      ],
      "product_description": "The Home Depot link (for reference only)\nPlease place orders on the Invention Studio store site for free pickup at the Studio Store",
      "options": [],
      "reference_urls": [
        "https://www.homedepot.com/p/Rust-Oleum-Painter-s-Touch-2X-12-oz-Gloss-Brilliant-Blue-General-Purpose-Spray-Paint-334027/307244835"
      ],
      "image_urls": [
        "https://epay.gatech.edu/C20793_ustores/web/uploaded_images/store_324/Screen_Shot_2021-06-10_at_12.57.31_PM.png"
      ],
      "source_url": "https://epay.gatech.edu/C20793_ustores/web/product_detail.jsp?PRODUCTID=5029&SINGLESTORE=true",
      "category_source_urls": [
        "https://epay.gatech.edu/C20793_ustores/web/store_cat.jsp?STOREID=324&CATID=584&SINGLESTORE=true"
      ],
      "notes": ""
    },
    {
      "product_id": "5027",
      "stock_number": "105",
      "name": "Gloss Spring Green Spray Paint",
      "price": 5.0,
      "currency": "USD",
      "availability": "No stock warning",
      "purchase_restriction": "",
      "categories": [
        {
          "id": "584",
          "name": "Paint",
          "path": "Paint",
          "url": "https://epay.gatech.edu/C20793_ustores/web/store_cat.jsp?STOREID=324&CATID=584&SINGLESTORE=true"
        }
      ],
      "listing_descriptions": [
        "The Home Depot link (for reference only)\nPlease place orders on the Invention Studio store site for free pickup at the Studio Store"
      ],
      "product_description": "The Home Depot link (for reference only)\nPlease place orders on the Invention Studio store site for free pickup at the Studio Store",
      "options": [],
      "reference_urls": [
        "https://www.homedepot.com/p/Rust-Oleum-Painter-s-Touch-2X-12-oz-Gloss-Spring-Green-General-Purpose-Spray-Paint-334055/307244845"
      ],
      "image_urls": [
        "https://epay.gatech.edu/C20793_ustores/web/uploaded_images/store_324/Screen_Shot_2021-06-10_at_12.49.46_PM.png"
      ],
      "source_url": "https://epay.gatech.edu/C20793_ustores/web/product_detail.jsp?PRODUCTID=5027&SINGLESTORE=true",
      "category_source_urls": [
        "https://epay.gatech.edu/C20793_ustores/web/store_cat.jsp?STOREID=324&CATID=584&SINGLESTORE=true"
      ],
      "notes": ""
    },
    {
      "product_id": "5026",
      "stock_number": "102",
      "name": "Gloss White Spray Paint",
      "price": 5.0,
      "currency": "USD",
      "availability": "No stock warning",
      "purchase_restriction": "",
      "categories": [
        {
          "id": "584",
          "name": "Paint",
          "path": "Paint",
          "url": "https://epay.gatech.edu/C20793_ustores/web/store_cat.jsp?STOREID=324&CATID=584&SINGLESTORE=true"
        }
      ],
      "listing_descriptions": [
        "The Home Depot link (for reference only)\nPlease place orders on the Invention Studio store site for free pickup at the Studio Store"
      ],
      "product_description": "The Home Depot link (for reference only)\nPlease place orders on the Invention Studio store site for free pickup at the Studio Store",
      "options": [],
      "reference_urls": [
        "https://www.homedepot.com/p/Rust-Oleum-Painter-s-Touch-2X-12-oz-Gloss-White-General-Purpose-Spray-Paint-334048/307244833"
      ],
      "image_urls": [
        "https://epay.gatech.edu/C20793_ustores/web/uploaded_images/store_324/Screen_Shot_2021-06-10_at_12.48.10_PM.png"
      ],
      "source_url": "https://epay.gatech.edu/C20793_ustores/web/product_detail.jsp?PRODUCTID=5026&SINGLESTORE=true",
      "category_source_urls": [
        "https://epay.gatech.edu/C20793_ustores/web/store_cat.jsp?STOREID=324&CATID=584&SINGLESTORE=true"
      ],
      "notes": ""
    },
    {
      "product_id": "5467",
      "stock_number": "111",
      "name": "Gold Metallic Spray Paint",
      "price": 5.0,
      "currency": "USD",
      "availability": "No stock warning",
      "purchase_restriction": "",
      "categories": [
        {
          "id": "584",
          "name": "Paint",
          "path": "Paint",
          "url": "https://epay.gatech.edu/C20793_ustores/web/store_cat.jsp?STOREID=324&CATID=584&SINGLESTORE=true"
        }
      ],
      "listing_descriptions": [
        "Brilliant Metal Finish"
      ],
      "product_description": "",
      "options": [],
      "reference_urls": [],
      "image_urls": [
        "https://epay.gatech.edu/C20793_ustores/web/uploaded_images/store_324/images(1).jpeg"
      ],
      "source_url": "https://epay.gatech.edu/C20793_ustores/web/product_detail.jsp?PRODUCTID=5467&SINGLESTORE=true",
      "category_source_urls": [
        "https://epay.gatech.edu/C20793_ustores/web/store_cat.jsp?STOREID=324&CATID=584&SINGLESTORE=true"
      ],
      "notes": ""
    },
    {
      "product_id": "6305",
      "stock_number": "",
      "name": "6mm bore to M4 threaded/12mm hex shaft coupler",
      "price": 2.5,
      "currency": "USD",
      "availability": "No stock warning",
      "purchase_restriction": "",
      "categories": [
        {
          "id": "681",
          "name": "Piping & Couplers",
          "path": "Piping & Couplers",
          "url": "https://epay.gatech.edu/C20793_ustores/web/store_cat.jsp?STOREID=324&CATID=681&SINGLESTORE=true"
        }
      ],
      "listing_descriptions": [],
      "product_description": "",
      "options": [],
      "reference_urls": [],
      "image_urls": [
        "https://epay.gatech.edu/C20793_ustores/web/uploaded_images/guid/7/1/8eadfc-4bd0-4915-9c8c-758724bafe3c.jpg"
      ],
      "source_url": "https://epay.gatech.edu/C20793_ustores/web/product_detail.jsp?PRODUCTID=6305&SINGLESTORE=true",
      "category_source_urls": [
        "https://epay.gatech.edu/C20793_ustores/web/store_cat.jsp?STOREID=324&CATID=681&SINGLESTORE=true"
      ],
      "notes": ""
    },
    {
      "product_id": "6306",
      "stock_number": "",
      "name": "6mm to 6mm shaft coupler",
      "price": 1.5,
      "currency": "USD",
      "availability": "No stock warning",
      "purchase_restriction": "",
      "categories": [
        {
          "id": "681",
          "name": "Piping & Couplers",
          "path": "Piping & Couplers",
          "url": "https://epay.gatech.edu/C20793_ustores/web/store_cat.jsp?STOREID=324&CATID=681&SINGLESTORE=true"
        }
      ],
      "listing_descriptions": [],
      "product_description": "",
      "options": [],
      "reference_urls": [],
      "image_urls": [
        "https://epay.gatech.edu/C20793_ustores/web/uploaded_images/guid/6/7/2fed0f-fa95-4fd2-828e-fd448fc7b02d.jpg"
      ],
      "source_url": "https://epay.gatech.edu/C20793_ustores/web/product_detail.jsp?PRODUCTID=6306&SINGLESTORE=true",
      "category_source_urls": [
        "https://epay.gatech.edu/C20793_ustores/web/store_cat.jsp?STOREID=324&CATID=681&SINGLESTORE=true"
      ],
      "notes": ""
    },
    {
      "product_id": "6281",
      "stock_number": "",
      "name": "1\" Diameter, 2' long PVC Pipe",
      "price": 1.25,
      "currency": "USD",
      "availability": "No stock warning",
      "purchase_restriction": "",
      "categories": [
        {
          "id": "693",
          "name": "PVC Piping",
          "path": "Piping & Couplers > PVC Piping",
          "url": "https://epay.gatech.edu/C20793_ustores/web/store_cat.jsp?STOREID=324&CATID=693&SINGLESTORE=true"
        }
      ],
      "listing_descriptions": [],
      "product_description": "",
      "options": [],
      "reference_urls": [],
      "image_urls": [
        "https://epay.gatech.edu/C20793_ustores/web/uploaded_images/guid/3/b/1fbf96-a4a1-48d6-8ef0-1ab16cbeb0da.jpg"
      ],
      "source_url": "https://epay.gatech.edu/C20793_ustores/web/product_detail.jsp?PRODUCTID=6281&SINGLESTORE=true",
      "category_source_urls": [
        "https://epay.gatech.edu/C20793_ustores/web/store_cat.jsp?STOREID=324&CATID=693&SINGLESTORE=true"
      ],
      "notes": ""
    },
    {
      "product_id": "6284",
      "stock_number": "",
      "name": "1/2\" Diameter, 5' long PVC Pipe",
      "price": 2.0,
      "currency": "USD",
      "availability": "No stock warning",
      "purchase_restriction": "",
      "categories": [
        {
          "id": "693",
          "name": "PVC Piping",
          "path": "Piping & Couplers > PVC Piping",
          "url": "https://epay.gatech.edu/C20793_ustores/web/store_cat.jsp?STOREID=324&CATID=693&SINGLESTORE=true"
        }
      ],
      "listing_descriptions": [],
      "product_description": "",
      "options": [],
      "reference_urls": [],
      "image_urls": [],
      "source_url": "https://epay.gatech.edu/C20793_ustores/web/product_detail.jsp?PRODUCTID=6284&SINGLESTORE=true",
      "category_source_urls": [
        "https://epay.gatech.edu/C20793_ustores/web/store_cat.jsp?STOREID=324&CATID=693&SINGLESTORE=true"
      ],
      "notes": ""
    },
    {
      "product_id": "6285",
      "stock_number": "",
      "name": "2\" Diameter, 2' long PVC Pipe",
      "price": 2.5,
      "currency": "USD",
      "availability": "No stock warning",
      "purchase_restriction": "",
      "categories": [
        {
          "id": "693",
          "name": "PVC Piping",
          "path": "Piping & Couplers > PVC Piping",
          "url": "https://epay.gatech.edu/C20793_ustores/web/store_cat.jsp?STOREID=324&CATID=693&SINGLESTORE=true"
        }
      ],
      "listing_descriptions": [],
      "product_description": "",
      "options": [],
      "reference_urls": [],
      "image_urls": [],
      "source_url": "https://epay.gatech.edu/C20793_ustores/web/product_detail.jsp?PRODUCTID=6285&SINGLESTORE=true",
      "category_source_urls": [
        "https://epay.gatech.edu/C20793_ustores/web/store_cat.jsp?STOREID=324&CATID=693&SINGLESTORE=true"
      ],
      "notes": ""
    },
    {
      "product_id": "6001",
      "stock_number": "150009",
      "name": "2\" Diameter, 5' long PVC Pipe",
      "price": 5.5,
      "currency": "USD",
      "availability": "No stock warning",
      "purchase_restriction": "",
      "categories": [
        {
          "id": "693",
          "name": "PVC Piping",
          "path": "Piping & Couplers > PVC Piping",
          "url": "https://epay.gatech.edu/C20793_ustores/web/store_cat.jsp?STOREID=324&CATID=693&SINGLESTORE=true"
        }
      ],
      "listing_descriptions": [],
      "product_description": "",
      "options": [],
      "reference_urls": [
        "https://www.homedepot.com/p/3-4-in-x-10-ft-White-PVC-Class-200-Pressure-Plain-End-Pipe-57570/100168741",
        "https://www.homedepot.com/p/Charlotte-Pipe-3-4-in-x-10-ft-PVC-Schedule-40-Pressure-Plain-End-Pipe-PVC-04007-0600/100348472"
      ],
      "image_urls": [],
      "source_url": "https://epay.gatech.edu/C20793_ustores/web/product_detail.jsp?PRODUCTID=6001&SINGLESTORE=true",
      "category_source_urls": [
        "https://epay.gatech.edu/C20793_ustores/web/store_cat.jsp?STOREID=324&CATID=693&SINGLESTORE=true"
      ],
      "notes": ""
    },
    {
      "product_id": "6718",
      "stock_number": "",
      "name": "Acrylic Sheets 12 x 8, 1/8\" thickness",
      "price": 2.5,
      "currency": "USD",
      "availability": "No stock warning",
      "purchase_restriction": "",
      "categories": [
        {
          "id": "575",
          "name": "Raw Materials",
          "path": "Raw Materials",
          "url": "https://epay.gatech.edu/C20793_ustores/web/store_cat.jsp?STOREID=324&CATID=575&SINGLESTORE=true"
        },
        {
          "id": "682",
          "name": "Arts & Crafts",
          "path": "Arts & Crafts",
          "url": "https://epay.gatech.edu/C20793_ustores/web/store_cat.jsp?STOREID=324&CATID=682&SINGLESTORE=true"
        },
        {
          "id": "687",
          "name": "Laser Cutting Materials",
          "path": "Laser Cutting Materials",
          "url": "https://epay.gatech.edu/C20793_ustores/web/store_cat.jsp?STOREID=324&CATID=687&SINGLESTORE=true"
        }
      ],
      "listing_descriptions": [],
      "product_description": "",
      "options": [],
      "reference_urls": [],
      "image_urls": [
        "https://epay.gatech.edu/C20793_ustores/web/uploaded_images/guid/1/1/4457a7-0b26-46e9-b784-48aae300bcb3.jpg"
      ],
      "source_url": "https://epay.gatech.edu/C20793_ustores/web/product_detail.jsp?PRODUCTID=6718&SINGLESTORE=true",
      "category_source_urls": [
        "https://epay.gatech.edu/C20793_ustores/web/store_cat.jsp?STOREID=324&CATID=575&SINGLESTORE=true",
        "https://epay.gatech.edu/C20793_ustores/web/store_cat.jsp?STOREID=324&CATID=682&SINGLESTORE=true",
        "https://epay.gatech.edu/C20793_ustores/web/store_cat.jsp?STOREID=324&CATID=687&SINGLESTORE=true"
      ],
      "notes": ""
    },
    {
      "product_id": "5505",
      "stock_number": "150",
      "name": "Everbilt 1/4 in. x 100 ft. White Twisted Polypropylene Rope",
      "price": 10.0,
      "currency": "USD",
      "availability": "No stock warning",
      "purchase_restriction": "",
      "categories": [
        {
          "id": "680",
          "name": "Rope, Twine, and Wire",
          "path": "Rope, Twine, and Wire",
          "url": "https://epay.gatech.edu/C20793_ustores/web/store_cat.jsp?STOREID=324&CATID=680&SINGLESTORE=true"
        }
      ],
      "listing_descriptions": [
        "The Home Depot link (for reference only)\nPlease place orders on the Invention Studio store site for free pickup at the Studio Store"
      ],
      "product_description": "",
      "options": [],
      "reference_urls": [
        "https://www.homedepot.com/p/Everbilt-1-4-in-x-100-ft-White-Twisted-Polypropylene-Rope-72747/206094293"
      ],
      "image_urls": [
        "https://epay.gatech.edu/C20793_ustores/web/uploaded_images/store_324/Screen_Shot_2022-10-10_at_4.08.21_PM.png"
      ],
      "source_url": "https://epay.gatech.edu/C20793_ustores/web/product_detail.jsp?PRODUCTID=5505&SINGLESTORE=true",
      "category_source_urls": [
        "https://epay.gatech.edu/C20793_ustores/web/store_cat.jsp?STOREID=324&CATID=680&SINGLESTORE=true"
      ],
      "notes": ""
    },
    {
      "product_id": "6294",
      "stock_number": "",
      "name": "10mm Dia V-groove ball bearing (10 pk)",
      "price": 7.0,
      "currency": "USD",
      "availability": "No stock warning",
      "purchase_restriction": "",
      "categories": [
        {
          "id": "696",
          "name": "Slides, Pulleys, Belts, and Bearings",
          "path": "Slides, Pulleys, Belts, and Bearings",
          "url": "https://epay.gatech.edu/C20793_ustores/web/store_cat.jsp?STOREID=324&CATID=696&SINGLESTORE=true"
        }
      ],
      "listing_descriptions": [],
      "product_description": "",
      "options": [],
      "reference_urls": [],
      "image_urls": [
        "https://epay.gatech.edu/C20793_ustores/web/uploaded_images/guid/d/a/60c143-7f18-46b6-bfa3-fccc77428388.jpg"
      ],
      "source_url": "https://epay.gatech.edu/C20793_ustores/web/product_detail.jsp?PRODUCTID=6294&SINGLESTORE=true",
      "category_source_urls": [
        "https://epay.gatech.edu/C20793_ustores/web/store_cat.jsp?STOREID=324&CATID=696&SINGLESTORE=true"
      ],
      "notes": ""
    },
    {
      "product_id": "6295",
      "stock_number": "",
      "name": "20 & 80 tooth GT2 1:4 timing belt reduction 6mm bore w/ belt",
      "price": 8.5,
      "currency": "USD",
      "availability": "No stock warning",
      "purchase_restriction": "",
      "categories": [
        {
          "id": "696",
          "name": "Slides, Pulleys, Belts, and Bearings",
          "path": "Slides, Pulleys, Belts, and Bearings",
          "url": "https://epay.gatech.edu/C20793_ustores/web/store_cat.jsp?STOREID=324&CATID=696&SINGLESTORE=true"
        }
      ],
      "listing_descriptions": [],
      "product_description": "",
      "options": [],
      "reference_urls": [],
      "image_urls": [],
      "source_url": "https://epay.gatech.edu/C20793_ustores/web/product_detail.jsp?PRODUCTID=6295&SINGLESTORE=true",
      "category_source_urls": [
        "https://epay.gatech.edu/C20793_ustores/web/store_cat.jsp?STOREID=324&CATID=696&SINGLESTORE=true"
      ],
      "notes": ""
    },
    {
      "product_id": "6296",
      "stock_number": "",
      "name": "2GT Timing Belt; Closed Loop, 6mm Width x 300mm Length",
      "price": 2.0,
      "currency": "USD",
      "availability": "No stock warning",
      "purchase_restriction": "",
      "categories": [
        {
          "id": "696",
          "name": "Slides, Pulleys, Belts, and Bearings",
          "path": "Slides, Pulleys, Belts, and Bearings",
          "url": "https://epay.gatech.edu/C20793_ustores/web/store_cat.jsp?STOREID=324&CATID=696&SINGLESTORE=true"
        }
      ],
      "listing_descriptions": [],
      "product_description": "",
      "options": [],
      "reference_urls": [],
      "image_urls": [],
      "source_url": "https://epay.gatech.edu/C20793_ustores/web/product_detail.jsp?PRODUCTID=6296&SINGLESTORE=true",
      "category_source_urls": [
        "https://epay.gatech.edu/C20793_ustores/web/store_cat.jsp?STOREID=324&CATID=696&SINGLESTORE=true"
      ],
      "notes": ""
    },
    {
      "product_id": "6298",
      "stock_number": "",
      "name": "GT2 Timing Belt; Open Loop, 6mm Width x 10m Length",
      "price": 20.0,
      "currency": "USD",
      "availability": "No stock warning",
      "purchase_restriction": "",
      "categories": [
        {
          "id": "696",
          "name": "Slides, Pulleys, Belts, and Bearings",
          "path": "Slides, Pulleys, Belts, and Bearings",
          "url": "https://epay.gatech.edu/C20793_ustores/web/store_cat.jsp?STOREID=324&CATID=696&SINGLESTORE=true"
        }
      ],
      "listing_descriptions": [],
      "product_description": "",
      "options": [],
      "reference_urls": [],
      "image_urls": [],
      "source_url": "https://epay.gatech.edu/C20793_ustores/web/product_detail.jsp?PRODUCTID=6298&SINGLESTORE=true",
      "category_source_urls": [
        "https://epay.gatech.edu/C20793_ustores/web/store_cat.jsp?STOREID=324&CATID=696&SINGLESTORE=true"
      ],
      "notes": ""
    },
    {
      "product_id": "6299",
      "stock_number": "",
      "name": "GT2 Timing Belt; Open Loop, 6mm Width x 2m Length",
      "price": 9.0,
      "currency": "USD",
      "availability": "No stock warning",
      "purchase_restriction": "",
      "categories": [
        {
          "id": "696",
          "name": "Slides, Pulleys, Belts, and Bearings",
          "path": "Slides, Pulleys, Belts, and Bearings",
          "url": "https://epay.gatech.edu/C20793_ustores/web/store_cat.jsp?STOREID=324&CATID=696&SINGLESTORE=true"
        }
      ],
      "listing_descriptions": [],
      "product_description": "",
      "options": [],
      "reference_urls": [],
      "image_urls": [],
      "source_url": "https://epay.gatech.edu/C20793_ustores/web/product_detail.jsp?PRODUCTID=6299&SINGLESTORE=true",
      "category_source_urls": [
        "https://epay.gatech.edu/C20793_ustores/web/store_cat.jsp?STOREID=324&CATID=696&SINGLESTORE=true"
      ],
      "notes": ""
    },
    {
      "product_id": "6300",
      "stock_number": "",
      "name": "Timing Belt GT2 6mm idler pulley (non-driven)",
      "price": 2.0,
      "currency": "USD",
      "availability": "No stock warning",
      "purchase_restriction": "",
      "categories": [
        {
          "id": "696",
          "name": "Slides, Pulleys, Belts, and Bearings",
          "path": "Slides, Pulleys, Belts, and Bearings",
          "url": "https://epay.gatech.edu/C20793_ustores/web/store_cat.jsp?STOREID=324&CATID=696&SINGLESTORE=true"
        }
      ],
      "listing_descriptions": [],
      "product_description": "",
      "options": [],
      "reference_urls": [],
      "image_urls": [],
      "source_url": "https://epay.gatech.edu/C20793_ustores/web/product_detail.jsp?PRODUCTID=6300&SINGLESTORE=true",
      "category_source_urls": [
        "https://epay.gatech.edu/C20793_ustores/web/store_cat.jsp?STOREID=324&CATID=696&SINGLESTORE=true"
      ],
      "notes": ""
    },
    {
      "product_id": "6310",
      "stock_number": "",
      "name": "Black zip tie bundle (4\", 6\". 8\", and 12\", 100pk each)",
      "price": 6.0,
      "currency": "USD",
      "availability": "Out of stock",
      "purchase_restriction": "",
      "categories": [
        {
          "id": "695",
          "name": "Tape & Zip Ties",
          "path": "Tape & Zip Ties",
          "url": "https://epay.gatech.edu/C20793_ustores/web/store_cat.jsp?STOREID=324&CATID=695&SINGLESTORE=true"
        }
      ],
      "listing_descriptions": [],
      "product_description": "",
      "options": [],
      "reference_urls": [],
      "image_urls": [],
      "source_url": "https://epay.gatech.edu/C20793_ustores/web/product_detail.jsp?PRODUCTID=6310&SINGLESTORE=true",
      "category_source_urls": [
        "https://epay.gatech.edu/C20793_ustores/web/store_cat.jsp?STOREID=324&CATID=695&SINGLESTORE=true"
      ],
      "notes": ""
    },
    {
      "product_id": "6257",
      "stock_number": "",
      "name": "SWRT 9 Mil Silver Heavy Duty Duct Tape, 2 in x 30 YD",
      "price": 4.0,
      "currency": "USD",
      "availability": "No stock warning",
      "purchase_restriction": "",
      "categories": [
        {
          "id": "695",
          "name": "Tape & Zip Ties",
          "path": "Tape & Zip Ties",
          "url": "https://epay.gatech.edu/C20793_ustores/web/store_cat.jsp?STOREID=324&CATID=695&SINGLESTORE=true"
        }
      ],
      "listing_descriptions": [],
      "product_description": "",
      "options": [],
      "reference_urls": [],
      "image_urls": [
        "https://epay.gatech.edu/C20793_ustores/web/uploaded_images/guid/3/c/17e889-986f-4fc7-85b6-f6475fb79a0b.jpg"
      ],
      "source_url": "https://epay.gatech.edu/C20793_ustores/web/product_detail.jsp?PRODUCTID=6257&SINGLESTORE=true",
      "category_source_urls": [
        "https://epay.gatech.edu/C20793_ustores/web/store_cat.jsp?STOREID=324&CATID=695&SINGLESTORE=true"
      ],
      "notes": ""
    },
    {
      "product_id": "6317",
      "stock_number": "",
      "name": "Fangfo 14-In-1 Multitool Pliers",
      "price": 10.0,
      "currency": "USD",
      "availability": "No stock warning",
      "purchase_restriction": "",
      "categories": [
        {
          "id": "663",
          "name": "Tools & Equipment",
          "path": "Tools & Equipment",
          "url": "https://epay.gatech.edu/C20793_ustores/web/store_cat.jsp?STOREID=324&CATID=663&SINGLESTORE=true"
        }
      ],
      "listing_descriptions": [],
      "product_description": "",
      "options": [],
      "reference_urls": [],
      "image_urls": [
        "https://epay.gatech.edu/C20793_ustores/web/uploaded_images/guid/1/e/563297-6937-4c40-a0a8-d85ae578fbcc.jpg"
      ],
      "source_url": "https://epay.gatech.edu/C20793_ustores/web/product_detail.jsp?PRODUCTID=6317&SINGLESTORE=true",
      "category_source_urls": [
        "https://epay.gatech.edu/C20793_ustores/web/store_cat.jsp?STOREID=324&CATID=663&SINGLESTORE=true"
      ],
      "notes": ""
    },
    {
      "product_id": "5502",
      "stock_number": "001",
      "name": "Kynup Digital Caliper (150 mm/6 in.)",
      "price": 35.0,
      "currency": "USD",
      "availability": "No stock warning",
      "purchase_restriction": "",
      "categories": [
        {
          "id": "663",
          "name": "Tools & Equipment",
          "path": "Tools & Equipment",
          "url": "https://epay.gatech.edu/C20793_ustores/web/store_cat.jsp?STOREID=324&CATID=663&SINGLESTORE=true"
        }
      ],
      "listing_descriptions": [
        "Amazon link (for reference only)"
      ],
      "product_description": "",
      "options": [],
      "reference_urls": [
        "https://www.amazon.com/Kynup-Measuring-Stainless-Waterproof-Protection/dp/B07X8JQ8L5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"
      ],
      "image_urls": [
        "https://epay.gatech.edu/C20793_ustores/web/uploaded_images/store_324/Screen_Shot_2022-10-07_at_2.52.07_PM.png"
      ],
      "source_url": "https://epay.gatech.edu/C20793_ustores/web/product_detail.jsp?PRODUCTID=5502&SINGLESTORE=true",
      "category_source_urls": [
        "https://epay.gatech.edu/C20793_ustores/web/store_cat.jsp?STOREID=324&CATID=663&SINGLESTORE=true"
      ],
      "notes": ""
    },
    {
      "product_id": "5486",
      "stock_number": "137",
      "name": "Makita Pneumatic 2 in. 18-Gauge Brad Nailer",
      "price": 99.0,
      "currency": "USD",
      "availability": "No stock warning",
      "purchase_restriction": "",
      "categories": [
        {
          "id": "663",
          "name": "Tools & Equipment",
          "path": "Tools & Equipment",
          "url": "https://epay.gatech.edu/C20793_ustores/web/store_cat.jsp?STOREID=324&CATID=663&SINGLESTORE=true"
        }
      ],
      "listing_descriptions": [
        "The Home Depot link (for reference only)"
      ],
      "product_description": "",
      "options": [],
      "reference_urls": [
        "https://www.homedepot.com/p/Makita-Pneumatic-2-in-18-Gauge-Brad-Nailer-AF506/312309197"
      ],
      "image_urls": [
        "https://epay.gatech.edu/C20793_ustores/web/uploaded_images/store_324/nailer.png"
      ],
      "source_url": "https://epay.gatech.edu/C20793_ustores/web/product_detail.jsp?PRODUCTID=5486&SINGLESTORE=true",
      "category_source_urls": [
        "https://epay.gatech.edu/C20793_ustores/web/store_cat.jsp?STOREID=324&CATID=663&SINGLESTORE=true"
      ],
      "notes": ""
    },
    {
      "product_id": "5491",
      "stock_number": "138",
      "name": "Milwaukee 4.75 in. Mini Flush Cutters",
      "price": 15.0,
      "currency": "USD",
      "availability": "No stock warning",
      "purchase_restriction": "",
      "categories": [
        {
          "id": "663",
          "name": "Tools & Equipment",
          "path": "Tools & Equipment",
          "url": "https://epay.gatech.edu/C20793_ustores/web/store_cat.jsp?STOREID=324&CATID=663&SINGLESTORE=true"
        }
      ],
      "listing_descriptions": [
        "The Home Depot link (for reference only)"
      ],
      "product_description": "",
      "options": [],
      "reference_urls": [
        "https://www.homedepot.com/p/Milwaukee-4-75-in-Mini-Flush-Cutters-48-22-6105/305760837"
      ],
      "image_urls": [
        "https://epay.gatech.edu/C20793_ustores/web/uploaded_images/store_324/Screen_Shot_2022-10-06_at_11.33.48_AM.png"
      ],
      "source_url": "https://epay.gatech.edu/C20793_ustores/web/product_detail.jsp?PRODUCTID=5491&SINGLESTORE=true",
      "category_source_urls": [
        "https://epay.gatech.edu/C20793_ustores/web/store_cat.jsp?STOREID=324&CATID=663&SINGLESTORE=true"
      ],
      "notes": ""
    },
    {
      "product_id": "5492",
      "stock_number": "139",
      "name": "Milwaukee 7 in. Wire Strippers",
      "price": 20.0,
      "currency": "USD",
      "availability": "No stock warning",
      "purchase_restriction": "",
      "categories": [
        {
          "id": "663",
          "name": "Tools & Equipment",
          "path": "Tools & Equipment",
          "url": "https://epay.gatech.edu/C20793_ustores/web/store_cat.jsp?STOREID=324&CATID=663&SINGLESTORE=true"
        }
      ],
      "listing_descriptions": [
        "The Home Depot link (for reference only)"
      ],
      "product_description": "",
      "options": [],
      "reference_urls": [
        "https://www.homedepot.com/p/Milwaukee-7-in-Wire-Strippers-48-22-6109/206865419"
      ],
      "image_urls": [
        "https://epay.gatech.edu/C20793_ustores/web/uploaded_images/store_324/Screen_Shot_2022-10-06_at_11.43.20_AM.png"
      ],
      "source_url": "https://epay.gatech.edu/C20793_ustores/web/product_detail.jsp?PRODUCTID=5492&SINGLESTORE=true",
      "category_source_urls": [
        "https://epay.gatech.edu/C20793_ustores/web/store_cat.jsp?STOREID=324&CATID=663&SINGLESTORE=true"
      ],
      "notes": ""
    },
    {
      "product_id": "5494",
      "stock_number": "141",
      "name": "Milwaukee 9 in. High Leverage Lineman's Pliers with Crimper",
      "price": 27.0,
      "currency": "USD",
      "availability": "No stock warning",
      "purchase_restriction": "",
      "categories": [
        {
          "id": "663",
          "name": "Tools & Equipment",
          "path": "Tools & Equipment",
          "url": "https://epay.gatech.edu/C20793_ustores/web/store_cat.jsp?STOREID=324&CATID=663&SINGLESTORE=true"
        }
      ],
      "listing_descriptions": [
        "The Home Depot link (for reference only)"
      ],
      "product_description": "",
      "options": [],
      "reference_urls": [
        "https://www.homedepot.com/p/Milwaukee-9-in-High-Leverage-Lineman-s-Pliers-with-Crimper-48-22-6100/205652185"
      ],
      "image_urls": [
        "https://epay.gatech.edu/C20793_ustores/web/uploaded_images/store_324/Screen_Shot_2022-10-06_at_11.54.15_AM.png"
      ],
      "source_url": "https://epay.gatech.edu/C20793_ustores/web/product_detail.jsp?PRODUCTID=5494&SINGLESTORE=true",
      "category_source_urls": [
        "https://epay.gatech.edu/C20793_ustores/web/store_cat.jsp?STOREID=324&CATID=663&SINGLESTORE=true"
      ],
      "notes": ""
    },
    {
      "product_id": "5484",
      "stock_number": "134",
      "name": "Milwaukee Cushion Grip Screwdriver Set (6-Piece)",
      "price": 30.0,
      "currency": "USD",
      "availability": "No stock warning",
      "purchase_restriction": "",
      "categories": [
        {
          "id": "663",
          "name": "Tools & Equipment",
          "path": "Tools & Equipment",
          "url": "https://epay.gatech.edu/C20793_ustores/web/store_cat.jsp?STOREID=324&CATID=663&SINGLESTORE=true"
        }
      ],
      "listing_descriptions": [
        "The Home Depot link (for reference only)"
      ],
      "product_description": "",
      "options": [],
      "reference_urls": [
        "https://www.homedepot.com/p/Milwaukee-Cushion-Grip-Screwdriver-Set-6-Piece-48-22-2886/302212579"
      ],
      "image_urls": [
        "https://epay.gatech.edu/C20793_ustores/web/uploaded_images/store_324/screwdriver6.png"
      ],
      "source_url": "https://epay.gatech.edu/C20793_ustores/web/product_detail.jsp?PRODUCTID=5484&SINGLESTORE=true",
      "category_source_urls": [
        "https://epay.gatech.edu/C20793_ustores/web/store_cat.jsp?STOREID=324&CATID=663&SINGLESTORE=true"
      ],
      "notes": ""
    },
    {
      "product_id": "6314",
      "stock_number": "",
      "name": "Milwaukee FASTBACK Compact Folding Utility Knife with General Purpose Blade",
      "price": 9.0,
      "currency": "USD",
      "availability": "No stock warning",
      "purchase_restriction": "",
      "categories": [
        {
          "id": "663",
          "name": "Tools & Equipment",
          "path": "Tools & Equipment",
          "url": "https://epay.gatech.edu/C20793_ustores/web/store_cat.jsp?STOREID=324&CATID=663&SINGLESTORE=true"
        }
      ],
      "listing_descriptions": [],
      "product_description": "",
      "options": [],
      "reference_urls": [],
      "image_urls": [
        "https://epay.gatech.edu/C20793_ustores/web/uploaded_images/guid/6/2/b4d498-0ced-4559-84be-50b590fe1be0.jpg"
      ],
      "source_url": "https://epay.gatech.edu/C20793_ustores/web/product_detail.jsp?PRODUCTID=6314&SINGLESTORE=true",
      "category_source_urls": [
        "https://epay.gatech.edu/C20793_ustores/web/store_cat.jsp?STOREID=324&CATID=663&SINGLESTORE=true"
      ],
      "notes": ""
    },
    {
      "product_id": "5483",
      "stock_number": "133",
      "name": "Milwaukee Screwdriver Set (10-Piece)",
      "price": 40.0,
      "currency": "USD",
      "availability": "No stock warning",
      "purchase_restriction": "",
      "categories": [
        {
          "id": "663",
          "name": "Tools & Equipment",
          "path": "Tools & Equipment",
          "url": "https://epay.gatech.edu/C20793_ustores/web/store_cat.jsp?STOREID=324&CATID=663&SINGLESTORE=true"
        }
      ],
      "listing_descriptions": [
        "The Home Depot link (for reference only)"
      ],
      "product_description": "",
      "options": [],
      "reference_urls": [
        "https://www.homedepot.com/p/Milwaukee-Screwdriver-Set-10-Piece-48-22-2710/302174758"
      ],
      "image_urls": [
        "https://epay.gatech.edu/C20793_ustores/web/uploaded_images/store_324/screwdriver.png"
      ],
      "source_url": "https://epay.gatech.edu/C20793_ustores/web/product_detail.jsp?PRODUCTID=5483&SINGLESTORE=true",
      "category_source_urls": [
        "https://epay.gatech.edu/C20793_ustores/web/store_cat.jsp?STOREID=324&CATID=663&SINGLESTORE=true"
      ],
      "notes": ""
    },
    {
      "product_id": "5501",
      "stock_number": "004",
      "name": "Mitutoyo 500-196-30 Digimatic Stainless Steel Digital Caliper",
      "price": 144.0,
      "currency": "USD",
      "availability": "No stock warning",
      "purchase_restriction": "",
      "categories": [
        {
          "id": "663",
          "name": "Tools & Equipment",
          "path": "Tools & Equipment",
          "url": "https://epay.gatech.edu/C20793_ustores/web/store_cat.jsp?STOREID=324&CATID=663&SINGLESTORE=true"
        }
      ],
      "listing_descriptions": [
        "Store link (for reference only)"
      ],
      "product_description": "",
      "options": [],
      "reference_urls": [
        "https://www.globalindustrial.com/p/mitutoyo-500-196-30-0-6-digimatic-digital-caliper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"
      ],
      "image_urls": [
        "https://epay.gatech.edu/C20793_ustores/web/uploaded_images/store_324/Screen_Shot_2022-10-07_at_2.44.53_PM.png"
      ],
      "source_url": "https://epay.gatech.edu/C20793_ustores/web/product_detail.jsp?PRODUCTID=5501&SINGLESTORE=true",
      "category_source_urls": [
        "https://epay.gatech.edu/C20793_ustores/web/store_cat.jsp?STOREID=324&CATID=663&SINGLESTORE=true"
      ],
      "notes": ""
    },
    {
      "product_id": "5487",
      "stock_number": "136",
      "name": "RexBeti 16 piece File Set",
      "price": 23.0,
      "currency": "USD",
      "availability": "No stock warning",
      "purchase_restriction": "",
      "categories": [
        {
          "id": "663",
          "name": "Tools & Equipment",
          "path": "Tools & Equipment",
          "url": "https://epay.gatech.edu/C20793_ustores/web/store_cat.jsp?STOREID=324&CATID=663&SINGLESTORE=true"
        }
      ],
      "listing_descriptions": [
        "Secure grip for optimal control and excellent removal rate."
      ],
      "product_description": "",
      "options": [],
      "reference_urls": [],
      "image_urls": [
        "https://epay.gatech.edu/C20793_ustores/web/uploaded_images/store_324/81i5Hgh5OwL._AC_SX679_.jpg"
      ],
      "source_url": "https://epay.gatech.edu/C20793_ustores/web/product_detail.jsp?PRODUCTID=5487&SINGLESTORE=true",
      "category_source_urls": [
        "https://epay.gatech.edu/C20793_ustores/web/store_cat.jsp?STOREID=324&CATID=663&SINGLESTORE=true"
      ],
      "notes": ""
    },
    {
      "product_id": "6316",
      "stock_number": "",
      "name": "WEN 10761 Electronic 6.1-Inch Digital Caliper",
      "price": 11.0,
      "currency": "USD",
      "availability": "No stock warning",
      "purchase_restriction": "",
      "categories": [
        {
          "id": "663",
          "name": "Tools & Equipment",
          "path": "Tools & Equipment",
          "url": "https://epay.gatech.edu/C20793_ustores/web/store_cat.jsp?STOREID=324&CATID=663&SINGLESTORE=true"
        }
      ],
      "listing_descriptions": [],
      "product_description": "",
      "options": [],
      "reference_urls": [],
      "image_urls": [
        "https://epay.gatech.edu/C20793_ustores/web/uploaded_images/guid/6/7/9ae5dc-ee89-4546-8ba8-f6f13569c7c3.jpg"
      ],
      "source_url": "https://epay.gatech.edu/C20793_ustores/web/product_detail.jsp?PRODUCTID=6316&SINGLESTORE=true",
      "category_source_urls": [
        "https://epay.gatech.edu/C20793_ustores/web/store_cat.jsp?STOREID=324&CATID=663&SINGLESTORE=true"
      ],
      "notes": ""
    },
    {
      "product_id": "5816",
      "stock_number": "160001",
      "name": "1 in. x 4 in. x 8 ft. Prime Whitewood Stud",
      "price": 7.5,
      "currency": "USD",
      "availability": "No stock warning",
      "purchase_restriction": "",
      "categories": [
        {
          "id": "684",
          "name": "Wood-Working",
          "path": "Wood-Working",
          "url": "https://epay.gatech.edu/C20793_ustores/web/store_cat.jsp?STOREID=324&CATID=684&SINGLESTORE=true"
        }
      ],
      "listing_descriptions": [],
      "product_description": "",
      "options": [],
      "reference_urls": [],
      "image_urls": [
        "https://epay.gatech.edu/C20793_ustores/web/uploaded_images/guid/9/1/cd7ba1-bfe9-48d8-8c53-f4d2b28f4fc1.jpg"
      ],
      "source_url": "https://epay.gatech.edu/C20793_ustores/web/product_detail.jsp?PRODUCTID=5816&SINGLESTORE=true",
      "category_source_urls": [
        "https://epay.gatech.edu/C20793_ustores/web/store_cat.jsp?STOREID=324&CATID=684&SINGLESTORE=true"
      ],
      "notes": ""
    },
    {
      "product_id": "6496",
      "stock_number": "",
      "name": "1\" Diameter, 36\" long Birch Dowel",
      "price": 3.0,
      "currency": "USD",
      "availability": "No stock warning",
      "purchase_restriction": "",
      "categories": [
        {
          "id": "684",
          "name": "Wood-Working",
          "path": "Wood-Working",
          "url": "https://epay.gatech.edu/C20793_ustores/web/store_cat.jsp?STOREID=324&CATID=684&SINGLESTORE=true"
        }
      ],
      "listing_descriptions": [],
      "product_description": "",
      "options": [],
      "reference_urls": [],
      "image_urls": [
        "https://epay.gatech.edu/C20793_ustores/web/uploaded_images/guid/e/0/9e96b8-94ff-4045-88bc-cbfdc46a4c4a.jpg"
      ],
      "source_url": "https://epay.gatech.edu/C20793_ustores/web/product_detail.jsp?PRODUCTID=6496&SINGLESTORE=true",
      "category_source_urls": [
        "https://epay.gatech.edu/C20793_ustores/web/store_cat.jsp?STOREID=324&CATID=684&SINGLESTORE=true"
      ],
      "notes": ""
    },
    {
      "product_id": "6497",
      "stock_number": "",
      "name": "1\" Diameter, 48\" long Birch Dowel",
      "price": 3.5,
      "currency": "USD",
      "availability": "No stock warning",
      "purchase_restriction": "",
      "categories": [
        {
          "id": "684",
          "name": "Wood-Working",
          "path": "Wood-Working",
          "url": "https://epay.gatech.edu/C20793_ustores/web/store_cat.jsp?STOREID=324&CATID=684&SINGLESTORE=true"
        }
      ],
      "listing_descriptions": [],
      "product_description": "",
      "options": [],
      "reference_urls": [],
      "image_urls": [
        "https://epay.gatech.edu/C20793_ustores/web/uploaded_images/guid/f/1/e75641-85f8-476c-ba92-e7a470e22e77.jpg"
      ],
      "source_url": "https://epay.gatech.edu/C20793_ustores/web/product_detail.jsp?PRODUCTID=6497&SINGLESTORE=true",
      "category_source_urls": [
        "https://epay.gatech.edu/C20793_ustores/web/store_cat.jsp?STOREID=324&CATID=684&SINGLESTORE=true"
      ],
      "notes": ""
    },
    {
      "product_id": "6288",
      "stock_number": "",
      "name": "1/2\" Diameter, 36\" long Birch Dowel",
      "price": 1.5,
      "currency": "USD",
      "availability": "No stock warning",
      "purchase_restriction": "",
      "categories": [
        {
          "id": "684",
          "name": "Wood-Working",
          "path": "Wood-Working",
          "url": "https://epay.gatech.edu/C20793_ustores/web/store_cat.jsp?STOREID=324&CATID=684&SINGLESTORE=true"
        }
      ],
      "listing_descriptions": [],
      "product_description": "",
      "options": [],
      "reference_urls": [],
      "image_urls": [
        "https://epay.gatech.edu/C20793_ustores/web/uploaded_images/guid/4/1/0e406d-d877-4e7e-92f3-e1f323e8f678.jpg"
      ],
      "source_url": "https://epay.gatech.edu/C20793_ustores/web/product_detail.jsp?PRODUCTID=6288&SINGLESTORE=true",
      "category_source_urls": [
        "https://epay.gatech.edu/C20793_ustores/web/store_cat.jsp?STOREID=324&CATID=684&SINGLESTORE=true"
      ],
      "notes": ""
    },
    {
      "product_id": "6289",
      "stock_number": "",
      "name": "1/2\" Diameter, 48\" long Birch Dowel",
      "price": 2.0,
      "currency": "USD",
      "availability": "No stock warning",
      "purchase_restriction": "",
      "categories": [
        {
          "id": "684",
          "name": "Wood-Working",
          "path": "Wood-Working",
          "url": "https://epay.gatech.edu/C20793_ustores/web/store_cat.jsp?STOREID=324&CATID=684&SINGLESTORE=true"
        }
      ],
      "listing_descriptions": [],
      "product_description": "",
      "options": [],
      "reference_urls": [],
      "image_urls": [
        "https://epay.gatech.edu/C20793_ustores/web/uploaded_images/guid/d/a/393961-eb0a-4228-832b-7d455351ccc7.jpg"
      ],
      "source_url": "https://epay.gatech.edu/C20793_ustores/web/product_detail.jsp?PRODUCTID=6289&SINGLESTORE=true",
      "category_source_urls": [
        "https://epay.gatech.edu/C20793_ustores/web/store_cat.jsp?STOREID=324&CATID=684&SINGLESTORE=true"
      ],
      "notes": ""
    },
    {
      "product_id": "5504",
      "stock_number": "160011",
      "name": "2 in. x 4 in. x 8 ft. Prime Whitewood Stud",
      "price": 3.0,
      "currency": "USD",
      "availability": "No stock warning",
      "purchase_restriction": "",
      "categories": [
        {
          "id": "684",
          "name": "Wood-Working",
          "path": "Wood-Working",
          "url": "https://epay.gatech.edu/C20793_ustores/web/store_cat.jsp?STOREID=324&CATID=684&SINGLESTORE=true"
        }
      ],
      "listing_descriptions": [
        "The Home Depot link (for reference only)"
      ],
      "product_description": "",
      "options": [],
      "reference_urls": [
        "https://www.homedepot.com/p/2-in-x-4-in-x-8-ft-Prime-Whitewood-Stud-058449/312528776"
      ],
      "image_urls": [
        "https://epay.gatech.edu/C20793_ustores/web/uploaded_images/store_324/framing-studs-058449-64_600.jpg"
      ],
      "source_url": "https://epay.gatech.edu/C20793_ustores/web/product_detail.jsp?PRODUCTID=5504&SINGLESTORE=true",
      "category_source_urls": [
        "https://epay.gatech.edu/C20793_ustores/web/store_cat.jsp?STOREID=324&CATID=684&SINGLESTORE=true"
      ],
      "notes": ""
    },
    {
      "product_id": "4985",
      "stock_number": "160013",
      "name": "MDF (Medium Density Fiberboard) 1/4 in. x 2 ft. x 4 ft.",
      "price": 15.0,
      "currency": "USD",
      "availability": "No stock warning",
      "purchase_restriction": "",
      "categories": [
        {
          "id": "684",
          "name": "Wood-Working",
          "path": "Wood-Working",
          "url": "https://epay.gatech.edu/C20793_ustores/web/store_cat.jsp?STOREID=324&CATID=684&SINGLESTORE=true"
        }
      ],
      "listing_descriptions": [
        "The Home Depot link (for reference only)\nPlease place orders on the Invention Studio store site for free pickup at the Studio Store"
      ],
      "product_description": "The Home Depot link (for reference only)\nPlease place orders on the Invention Studio store site for free pickup at the Studio Store",
      "options": [],
      "reference_urls": [
        "https://www.homedepot.com/p/Medium-Density-Fiberboard-Common-1-4-in-x-2-ft-x-4-ft-Actual-0-216-in-x-23-75-in-x-47-75-in-1508104/202089069"
      ],
      "image_urls": [
        "https://epay.gatech.edu/C20793_ustores/web/uploaded_images/store_324/Screenshot_2021-05-02_143711.jpg"
      ],
      "source_url": "https://epay.gatech.edu/C20793_ustores/web/product_detail.jsp?PRODUCTID=4985&SINGLESTORE=true",
      "category_source_urls": [
        "https://epay.gatech.edu/C20793_ustores/web/store_cat.jsp?STOREID=324&CATID=684&SINGLESTORE=true"
      ],
      "notes": ""
    },
    {
      "product_id": "6500",
      "stock_number": "0582113",
      "name": "Murtenze 1.5 Inch Mini Solid Brass Hinges",
      "price": 1.5,
      "currency": "USD",
      "availability": "No stock warning",
      "purchase_restriction": "",
      "categories": [
        {
          "id": "684",
          "name": "Wood-Working",
          "path": "Wood-Working",
          "url": "https://epay.gatech.edu/C20793_ustores/web/store_cat.jsp?STOREID=324&CATID=684&SINGLESTORE=true"
        }
      ],
      "listing_descriptions": [],
      "product_description": "Amazon Link(For Reference)",
      "options": [],
      "reference_urls": [
        "https://www.amazon.com/Murtenze-Hinges%EF%BC%8CBrass-Cabinet-Hinges-Drawer/dp/B0DSZXZ58K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"
      ],
      "image_urls": [
        "https://epay.gatech.edu/C20793_ustores/web/uploaded_images/guid/7/f/cac8b3-467c-4990-8d18-0f9eb99ede82.jpg"
      ],
      "source_url": "https://epay.gatech.edu/C20793_ustores/web/product_detail.jsp?PRODUCTID=6500&SINGLESTORE=true",
      "category_source_urls": [
        "https://epay.gatech.edu/C20793_ustores/web/store_cat.jsp?STOREID=324&CATID=684&SINGLESTORE=true"
      ],
      "notes": ""
    },
    {
      "product_id": "6499",
      "stock_number": "",
      "name": "Plutouyar 6Pack Butt Hinge 1 Inch Mini 304 Stainless Steel",
      "price": 5.0,
      "currency": "USD",
      "availability": "No stock warning",
      "purchase_restriction": "",
      "categories": [
        {
          "id": "684",
          "name": "Wood-Working",
          "path": "Wood-Working",
          "url": "https://epay.gatech.edu/C20793_ustores/web/store_cat.jsp?STOREID=324&CATID=684&SINGLESTORE=true"
        }
      ],
      "listing_descriptions": [],
      "product_description": "Amazon Link(For Reference)",
      "options": [],
      "reference_urls": [
        "https://www.amazon.com/Piutouyar-Stainless-Cabinet-Folding-Mounting/dp/B09LHJ95YS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"
      ],
      "image_urls": [
        "https://epay.gatech.edu/C20793_ustores/web/uploaded_images/guid/7/9/09e574-1cfe-4f12-934a-cafbe5d6551e.jpg"
      ],
      "source_url": "https://epay.gatech.edu/C20793_ustores/web/product_detail.jsp?PRODUCTID=6499&SINGLESTORE=true",
      "category_source_urls": [
        "https://epay.gatech.edu/C20793_ustores/web/store_cat.jsp?STOREID=324&CATID=684&SINGLESTORE=true"
      ],
      "notes": ""
    },
    {
      "product_id": "6706",
      "stock_number": "",
      "name": "Acrylic 12 x 12",
      "price": 5.0,
      "currency": "USD",
      "availability": "No stock warning",
      "purchase_restriction": "",
      "categories": [],
      "listing_descriptions": [],
      "product_description": "",
      "options": [],
      "reference_urls": [],
      "image_urls": [],
      "source_url": "https://epay.gatech.edu/C20793_ustores/web/product_detail.jsp?PRODUCTID=6706&SINGLESTORE=true",
      "category_source_urls": [],
      "notes": "Found on store homepage and in store search; absent from all category listings."
    }
  ],
  "options": [
    {
      "product_id": "5552",
      "product_name": "70's Theme Invention Studio Hoodie",
      "option": "Size",
      "value": "Small",
      "source_option_id": "809",
      "displayed_price": 25.0,
      "currency": "USD",
      "availability": "No stock warning",
      "source_url": "https://epay.gatech.edu/C20793_ustores/web/product_detail.jsp?PRODUCTID=5552&SINGLESTORE=true"
    },
    {
      "product_id": "5552",
      "product_name": "70's Theme Invention Studio Hoodie",
      "option": "Size",
      "value": "Medium",
      "source_option_id": "810",
      "displayed_price": 25.0,
      "currency": "USD",
      "availability": "No stock warning",
      "source_url": "https://epay.gatech.edu/C20793_ustores/web/product_detail.jsp?PRODUCTID=5552&SINGLESTORE=true"
    },
    {
      "product_id": "5552",
      "product_name": "70's Theme Invention Studio Hoodie",
      "option": "Size",
      "value": "Large",
      "source_option_id": "811",
      "displayed_price": 25.0,
      "currency": "USD",
      "availability": "No stock warning",
      "source_url": "https://epay.gatech.edu/C20793_ustores/web/product_detail.jsp?PRODUCTID=5552&SINGLESTORE=true"
    },
    {
      "product_id": "5555",
      "product_name": "\"It's an Invention Studio Thing\" Hoodie",
      "option": "Size",
      "value": "Small",
      "source_option_id": "806",
      "displayed_price": 25.0,
      "currency": "USD",
      "availability": "No stock warning",
      "source_url": "https://epay.gatech.edu/C20793_ustores/web/product_detail.jsp?PRODUCTID=5555&SINGLESTORE=true"
    },
    {
      "product_id": "5555",
      "product_name": "\"It's an Invention Studio Thing\" Hoodie",
      "option": "Size",
      "value": "Medium",
      "source_option_id": "807",
      "displayed_price": 25.0,
      "currency": "USD",
      "availability": "No stock warning",
      "source_url": "https://epay.gatech.edu/C20793_ustores/web/product_detail.jsp?PRODUCTID=5555&SINGLESTORE=true"
    },
    {
      "product_id": "5555",
      "product_name": "\"It's an Invention Studio Thing\" Hoodie",
      "option": "Size",
      "value": "Large",
      "source_option_id": "808",
      "displayed_price": 25.0,
      "currency": "USD",
      "availability": "No stock warning",
      "source_url": "https://epay.gatech.edu/C20793_ustores/web/product_detail.jsp?PRODUCTID=5555&SINGLESTORE=true"
    },
    {
      "product_id": "5887",
      "product_name": "White T-Shirt",
      "option": "Size",
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
    },
    {
      "product_id": "6259",
      "product_name": "Electrical Tape (30' Length, 0.7\" Width)",
      "option": "Color",
      "value": "White",
      "source_option_id": "1108",
      "displayed_price": 1.5,
      "currency": "USD",
      "availability": "No stock warning",
      "source_url": "https://epay.gatech.edu/C20793_ustores/web/product_detail.jsp?PRODUCTID=6259&SINGLESTORE=true"
    },
    {
      "product_id": "6259",
      "product_name": "Electrical Tape (30' Length, 0.7\" Width)",
      "option": "Color",
      "value": "Black",
      "source_option_id": "1109",
      "displayed_price": 1.5,
      "currency": "USD",
      "availability": "No stock warning",
      "source_url": "https://epay.gatech.edu/C20793_ustores/web/product_detail.jsp?PRODUCTID=6259&SINGLESTORE=true"
    }
  ],
  "categories": [
    {
      "category_id": "575",
      "name": "Raw Materials",
      "path": "Raw Materials",
      "parent_id": "",
      "advertised_product_count": 1,
      "extracted_direct_product_count": 1,
      "extracted_including_subcategories": 1,
      "difference": 0,
      "product_ids": [
        "6718"
      ],
      "url": "https://epay.gatech.edu/C20793_ustores/web/store_cat.jsp?STOREID=324&CATID=575&SINGLESTORE=true",
      "note": ""
    },
    {
      "category_id": "584",
      "name": "Paint",
      "path": "Paint",
      "parent_id": "",
      "advertised_product_count": 9,
      "extracted_direct_product_count": 9,
      "extracted_including_subcategories": 9,
      "difference": 0,
      "product_ids": [
        "4901",
        "4902",
        "5026",
        "5027",
        "5028",
        "5029",
        "5466",
        "5467",
        "6230"
      ],
      "url": "https://epay.gatech.edu/C20793_ustores/web/store_cat.jsp?STOREID=324&CATID=584&SINGLESTORE=true",
      "note": ""
    },
    {
      "category_id": "577",
      "name": "Electronics",
      "path": "Electronics",
      "parent_id": "",
      "advertised_product_count": 14,
      "extracted_direct_product_count": 1,
      "extracted_including_subcategories": 14,
      "difference": 0,
      "product_ids": [
        "4907",
        "4990",
        "6258",
        "6263",
        "6264",
        "6265",
        "6266",
        "6267",
        "6268",
        "6270",
        "6271",
        "6448",
        "6449",
        "6498"
      ],
      "url": "https://epay.gatech.edu/C20793_ustores/web/store_cat.jsp?STOREID=324&CATID=577&SINGLESTORE=true",
      "note": ""
    },
    {
      "category_id": "572",
      "name": "Miscellaneous",
      "path": "Miscellaneous",
      "parent_id": "",
      "advertised_product_count": 16,
      "extracted_direct_product_count": 15,
      "extracted_including_subcategories": 15,
      "difference": 1,
      "product_ids": [
        "4876",
        "4984",
        "5498",
        "5500",
        "5516",
        "5517",
        "6111",
        "6112",
        "6166",
        "6229",
        "6309",
        "6313",
        "6719",
        "6727",
        "6734"
      ],
      "url": "https://epay.gatech.edu/C20793_ustores/web/store_cat.jsp?STOREID=324&CATID=572&SINGLESTORE=true",
      "note": "Store advertises 16 items, but displays 15. No pagination or subcategory links were present."
    },
    {
      "category_id": "663",
      "name": "Tools & Equipment",
      "path": "Tools & Equipment",
      "parent_id": "",
      "advertised_product_count": 12,
      "extracted_direct_product_count": 12,
      "extracted_including_subcategories": 12,
      "difference": 0,
      "product_ids": [
        "5483",
        "5484",
        "5486",
        "5487",
        "5491",
        "5492",
        "5494",
        "5501",
        "5502",
        "6314",
        "6316",
        "6317"
      ],
      "url": "https://epay.gatech.edu/C20793_ustores/web/store_cat.jsp?STOREID=324&CATID=663&SINGLESTORE=true",
      "note": ""
    },
    {
      "category_id": "667",
      "name": "Merchandise",
      "path": "Merchandise",
      "parent_id": "",
      "advertised_product_count": 6,
      "extracted_direct_product_count": 6,
      "extracted_including_subcategories": 6,
      "difference": 0,
      "product_ids": [
        "5552",
        "5555",
        "5886",
        "5887",
        "5888",
        "6348"
      ],
      "url": "https://epay.gatech.edu/C20793_ustores/web/store_cat.jsp?STOREID=324&CATID=667&SINGLESTORE=true",
      "note": ""
    },
    {
      "category_id": "680",
      "name": "Rope, Twine, and Wire",
      "path": "Rope, Twine, and Wire",
      "parent_id": "",
      "advertised_product_count": 1,
      "extracted_direct_product_count": 1,
      "extracted_including_subcategories": 1,
      "difference": 0,
      "product_ids": [
        "5505"
      ],
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
      "difference": 0,
      "product_ids": [
        "6001",
        "6281",
        "6284",
        "6285"
      ],
      "url": "https://epay.gatech.edu/C20793_ustores/web/store_cat.jsp?STOREID=324&CATID=693&SINGLESTORE=true",
      "note": ""
    }
  ]
}

Record these and continue the work.
