farev/robotarmtest/inbox/done/20261029-211040.md

---
from: user
created: 2026-10-30T01:10:40Z
---

where can I find the part list I need to order from amazon with specific links? I noticed on the BOM that we have many candidates choose the preffered ones
