farev/robotarmtest/design/v1/poses/reach-table/views/front.png

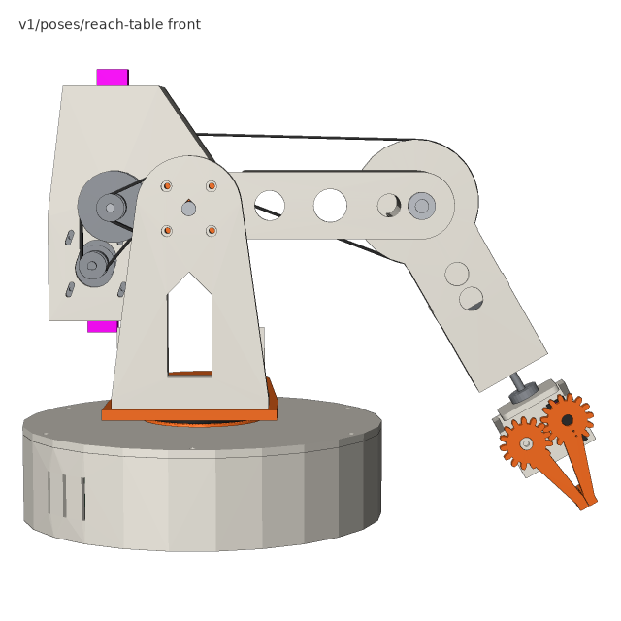
design/v1/poses/reach-table/views/front.png
