farev/robotarmtest/design/v1/poses/reach-table/views/iso.png

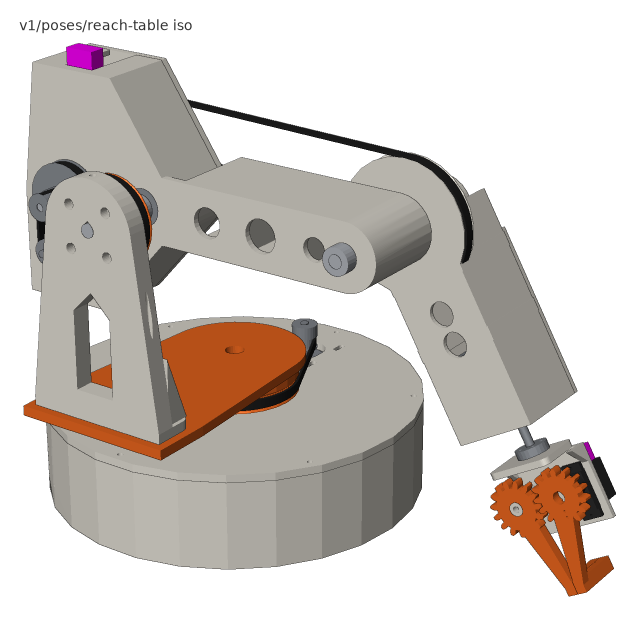
design/v1/poses/reach-table/views/iso.png
