farev/robotarmtest/design/v1/poses/reach-table/views/side.png

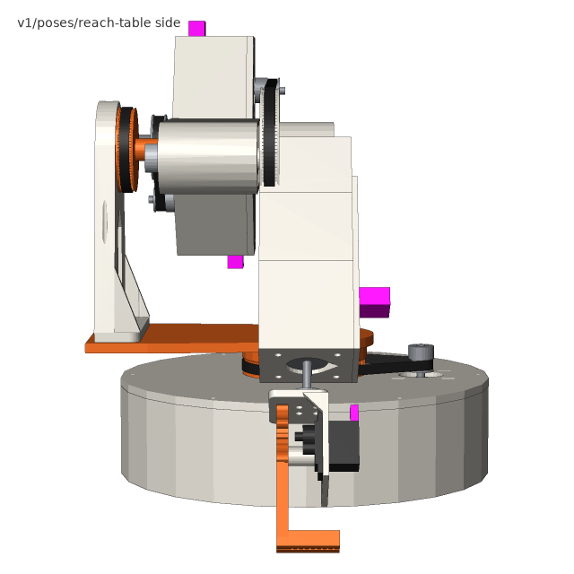
design/v1/poses/reach-table/views/side.png
