farev/robotarmtest/design/v1/poses/reach-table/views/top.png

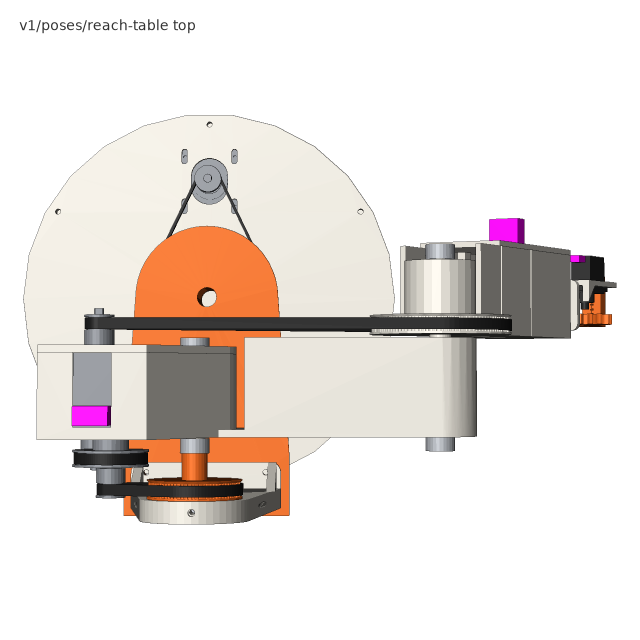
design/v1/poses/reach-table/views/top.png
