farev/robotarmtest/design/v1/views/front.png

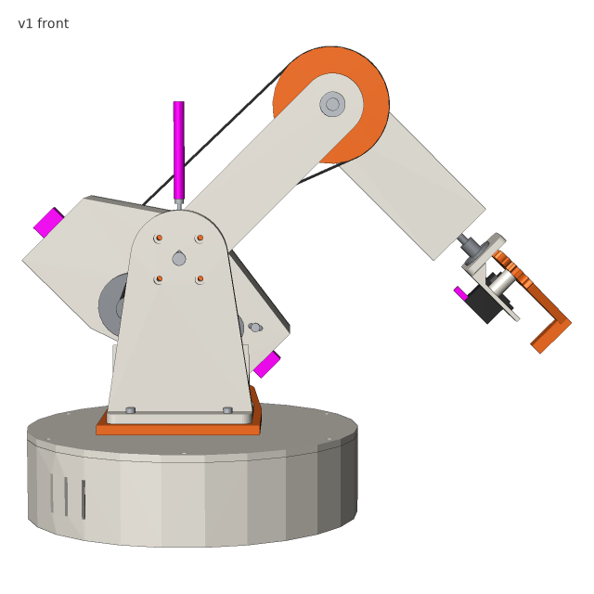
design/v1/views/front.png
