farev/robotarmtest/design/v1/views/iso.png

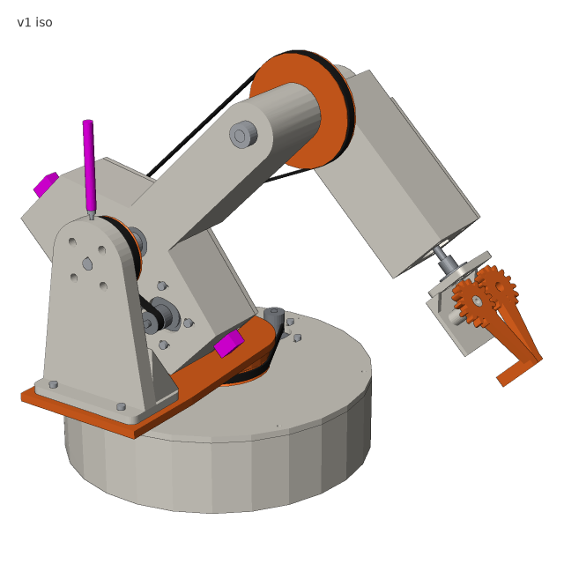
design/v1/views/iso.png
