farev/robotarmtest/design/v1/views/side.png

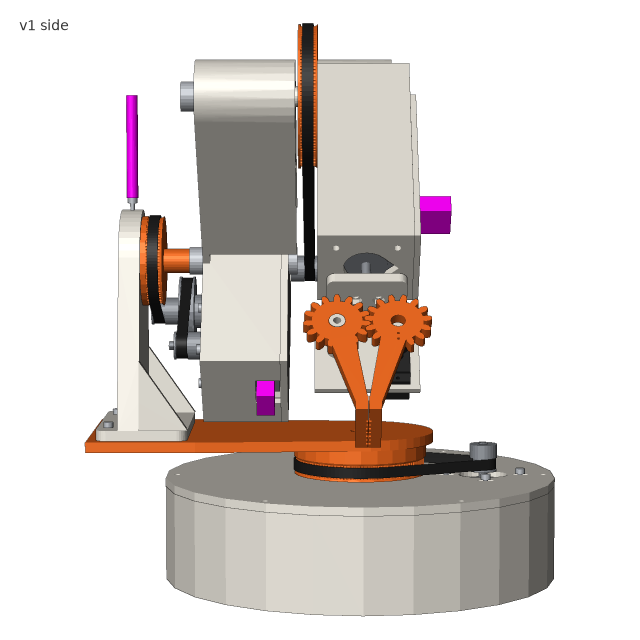
design/v1/views/side.png
