farev/robotarmtest/design/v1/views/top.png

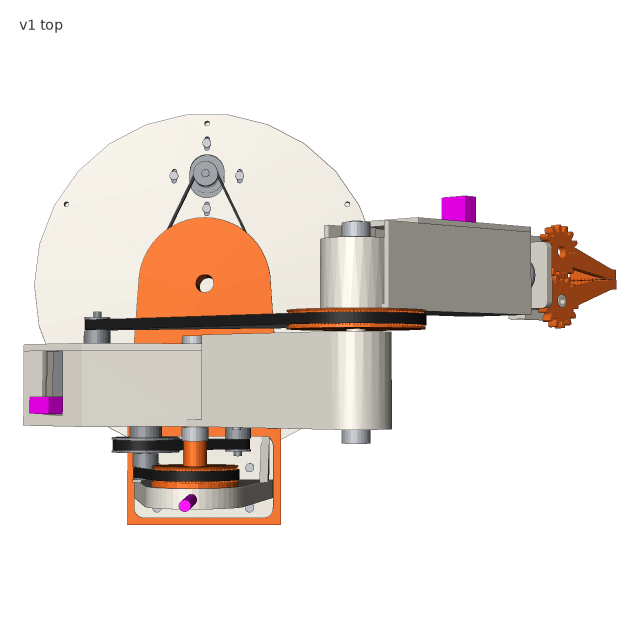
design/v1/views/top.png
