farev/robotarmtest/inspiration/redline-20261030-162351.png

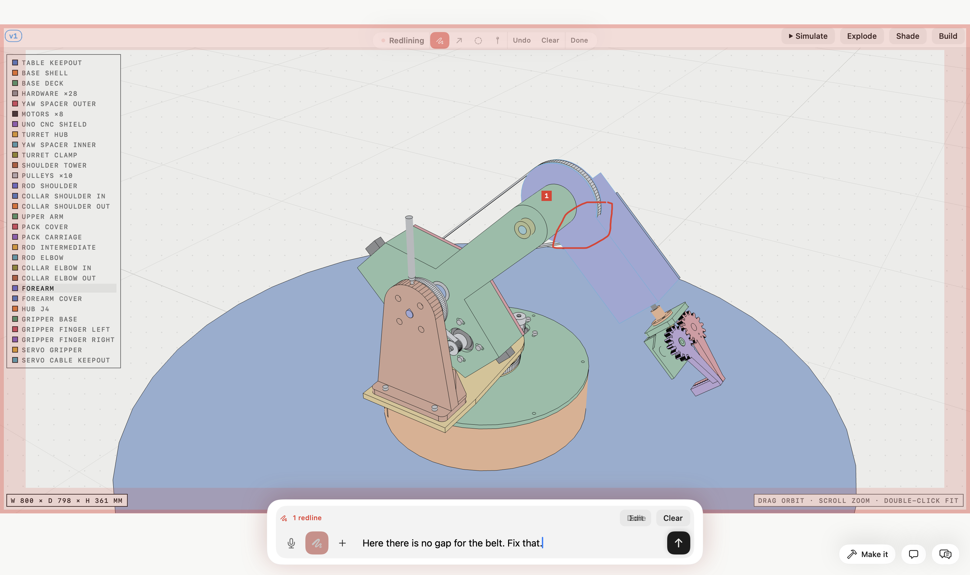
inspiration/redline-20261030-162351.png
