farev/robotarmtest/sim/fea-v1/plots/stress_along.png

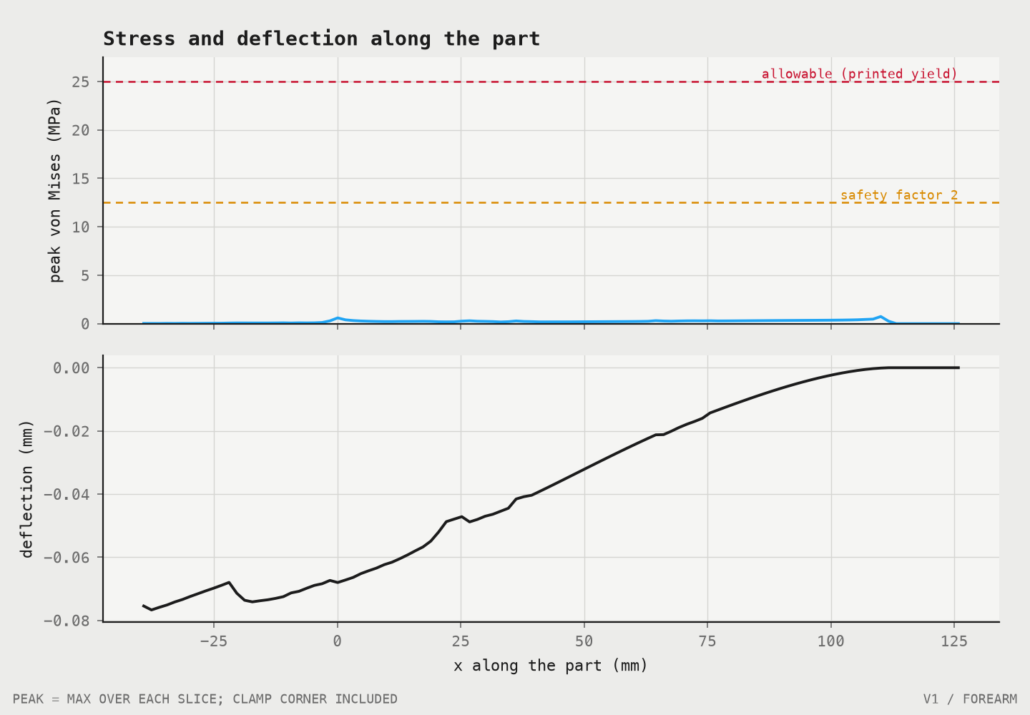
sim/fea-v1/plots/stress_along.png
