farev/robotarmtest/sim/thermal-v1/plots/heatup.png

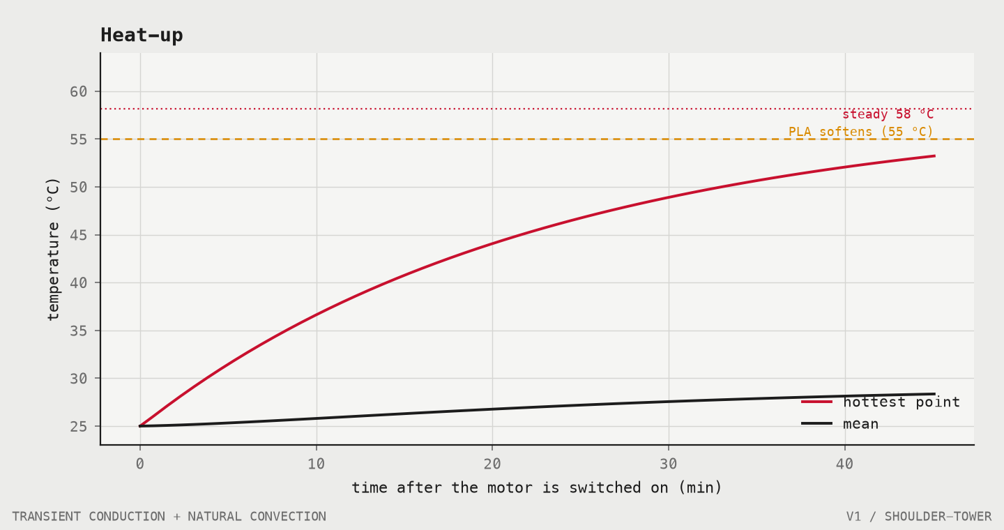
sim/thermal-v1/plots/heatup.png
