farev/robotarmtest/sim/thermal-v1/plots/temperature_map.png

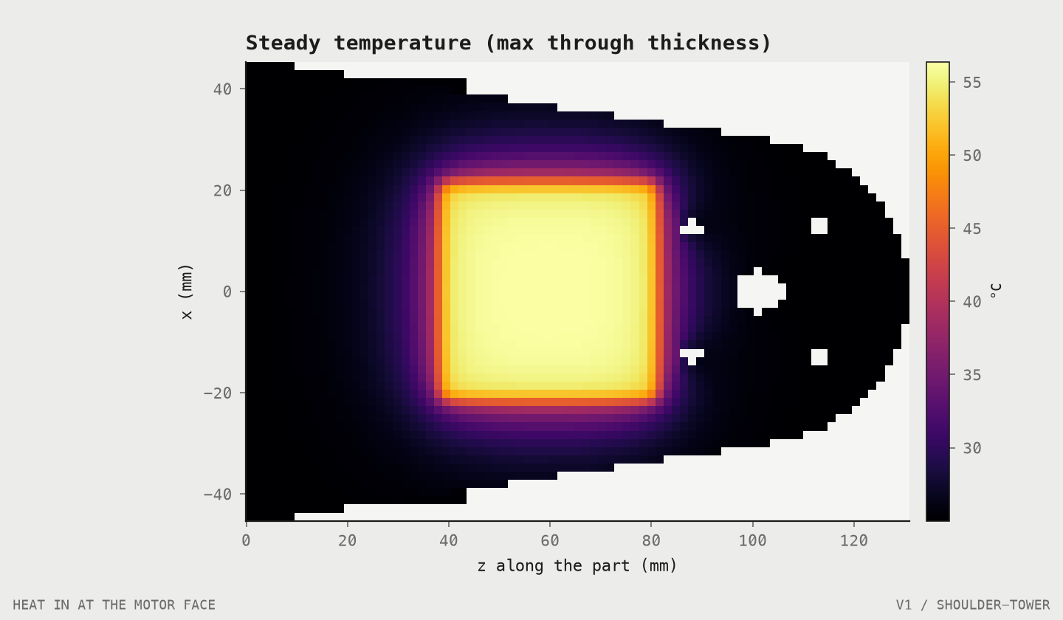
sim/thermal-v1/plots/temperature_map.png
