farev/robotarmtest/.mechy/reviews/2026-10-29-pre-order.md

# Pre-order review, 2026-10-29

Verdict: not ready (7 blocking, 10 should fix, 10 unverified)
Files read: requirements.yaml, brief.md, decisions.md, parts/build_plan.md, parts/components.yaml, parts/compatibility.yaml,
parts/models/*.yaml (nema17-42shdc, gt2-20t-5mm, gt2-60t-5mm, flange-coupling-5mm, collar-8mm, rod-5x52, belt-j1/s1/j3, mg90s,
uno-cnc-shield), design/v1/assembly.yaml, design/v1/printed/base-shell.py, layout.py (constants), docs/v1/order-list.md,
docs/v1/build-notes.md, research/gt-invention-studio-store.md

Listing data below was fetched today (2026-10-29) with a plain HTTP GET. Amazon served the full buy box this time and
showed "Delivering to Atlanta 30324" (not 30332, but the same metro). "Prime" dates only apply if the buyer has Prime.
Without Prime, every Amazon line showed "FREE delivery Tuesday, November 3 on orders ... over $35" at the earliest.

## Blocking

1. **Cart not committed: no buy item is `selected`.** Every item to buy is `preferred` (8) or `candidate` (8). Eight
   candidates still have `stock_checked: unverified` (components.yaml:103, 119, 133, 178, 206, 264, 279, 319), and their notes
   say "page not checked" or "page would not load". `validate-parts` passes (`"items": 25, "violations": []`) only because
   no item is `selected`. Coverage (step 1) therefore fails for every buy function in build_plan.md:13-29. Fix: re-pick using
   the findings below, record today's price, stock and date, and set `selected`.

2. **608-2RS bearings (B07H84P2K1) are out of stock.** Evidence: https://www.amazon.com/dp/B07H84P2K1 says "Currently
   unavailable. We don't know when or if this item will be back in stock." This was also the fate of the first pick
   (components.yaml:108). Nothing else in the order covers the 4 shoulder and elbow bearings. Fix: buy 608-2RS locally
   (any skate shop, as order-list.md:36 says) or pick another listing and check it today.

3. **5 mm rod (B0FXF4RFMP) costs $66.52 + $10.50 shipping and arrives Nov 10-20.** Evidence: the listing shows
   "$66.52" and "$10.50 delivery November 10 - 20". The size shown is "L: 3.94 in / 100mm" (2 pcs, h8), but the page's
   detail block shows ASIN B096QC2YDK. That is $77 for one 52 mm intermediate shaft, a line over $30 with `datasheet:
   unverified` (components.yaml:205). Fix: use a 5 mm h6/h8 rod or a 5 x 50+ mm dowel pin from a source that delivers
   in time (or from the studio), or a cut 5 mm drill-blank. Check the 52 mm cut length still fits.

4. **6806-2RS (B0DFC7TRRH): $45.23, arrives Nov 10-19, and its datasheet and checks do not cover the listed variant.**
   Evidence: the listing shows "$45.23", "Only 18 left in stock", "FREE delivery November 10 - 19". The specs (WAAZVXS,
   30 x 42 x 7, C0, ABEC-1) match. The line total is over $30, but `datasheet` is a generic bearingsdirect page ($14.74
   each there) and the only compat check is `unverified` (compatibility.yaml:108-112). Fix: buy 2 locally (bike shop,
   BB30 6806) or a 2- to 4-pack, then add a verified check.

5. **8 mm shaft collars (B0DQKVNBST): the "8 mm option" the notes tell you to pick does not exist.** Evidence: the
   listing's size selector shows "Size Name: 5/16 Inch", and the only other options are "1/2 Inch" and "3/8 Inch". The
   title is "Shaft Collar 8mm 5/16 Inch Bore", and the bullet says "8 mm x 14 mm x 8 mm / 0.31 Inch". components.yaml:225
   and order-list.md:20 ("pick the 8 mm option, not 5/16") cannot be followed. A true 5/16 in bore is 7.94 mm, which is
   smaller than the rod's 7.97-7.995 mm (rod listing B0D7M8XBG4: "tolerance -0.005mm to -0.03mm"), so it would not go on.
   The page also shows "Only 9 left" and Prime "Sunday, November 1". compatibility.yaml has no bore check for the collar,
   only an envelope check. Fix: pick a listing sold explicitly as metric 8 mm bore, and add a collar-to-rod bore check.

6. **Delivery misses the Saturday Oct 31 deadline (decisions.md:10, order-list.md:3) on parts the arm cannot run
   without.** Evidence, today's pages (Atlanta 30324):
   - GT2 pulley kit B09V5C1F7C: Prime "Sunday, November 1". This kit is the only source of the four 20T pulleys (J1, J2,
     stage 2, J3), the 60T and both 200 mm belts.
   - 625-2RS B0BZ2Z5B4W: "$29.61", "FREE delivery November 10 - 20". The backup B08LTLKQ1P is $32.29, Nov 10-19.
   - 520 mm belt B01GZDU64U: "$12.88", "$4 delivery November 12 - 23". The backup B018528Z38 is "fastest delivery
     November 4 - 6".
   - DC jack B08D11S5ZH: "$10.99", "Usually ships within 4 to 5 days", "$6 delivery November 17 - 27".
   - 5 mm rod and 6806: see items 3 and 4. 608: see item 2.

   Only the coupling, 8 mm rod, E-stop, fuse holder, LM2596 and stepper cables show Saturday Oct 31, and only with Prime.
   Fix: buy the bearings, belts and pulleys locally (Micro Center Atlanta stocks GT2 pulleys and belts, skate and bike
   shops stock the bearings), or move the deadline.

7. **Gripper servo cannot be wired: the servo extension and the buck-to-servo connector are not in the parts list.**
   build_plan.md:26 requires a "servo extension ~1 m". components.yaml has no item for it, and order-list.md:40 only says
   "Still needed but not on Amazon above". The MG90S lead (~25 cm) has to reach the base from the wrist, which is roughly
   0.6-0.8 m of path including the elbow and yaw loops. The LM2596 module has solder pads or terminals, not a 3-pin servo
   header, so a servo pigtail or a header is also needed. Fix: add a 1 m 3-pin servo extension and a male servo lead,
   or a 3-pin header, as owned or bought items.

## Should fix

1. **End-stops missing.** build_plan.md:24 says "buy | 3 × lever micro switches (J1, J2, J3)". There is no item in
   components.yaml or the orders. build-notes.md:129 allows homing by eye, so either add the switches or change the plan
   to "deferred".
2. **Wiring and consumables not covered.** None of these is in components.yaml:
   - hookup wire for jack → fuse → E-stop → shield and for the buck in/out (the fuse holder pigtails are not enough);
   - spiral wrap and zip ties (research/gt-invention-studio-store.md:15: the store's zip-tie bundle "is **out of
     stock**"), heat-shrink and threadlocker (build_plan.md:26, 29);
   - crimp housings and pins plus a crimp tool. build-notes.md:109 says "pass bare wires, crimp the shield end
     afterwards" because the cables' connectors cannot pass the turret's Ø12 bore: an XH 4-pin housing is about 12.4 mm
     long and a PH 6-pin about 13.9 mm.

   List each as owned (studio) or bought.
3. **Filament not covered.** About 830 g PLA (build-notes.md:4), plus PETG for the motor parts. No item and no `owned`
   entry.
4. **Spares short of the build notes.** Inserts: components.yaml:72 has qty 35, which equals the exact need, but
   build-notes.md:46 says "Total 35 inserts (buy 50)". Washers: components.yaml:83 lists 4, but build-notes.md:61 calls
   for "2 washers on J1" on each of 4 screws when the motor thread is under 5 mm, which is 8.
5. **build_plan.md is out of date with the parts list.** Line 22 says "16 mm latching switch", "7.5 A inline fuse" and a
   "12 mm hole". The parts list and CAD use a 22 mm E-stop (22.3 hole), a 10 A fuse (components.yaml:308,
   order-list.md:23) and an 11.3 mm jack hole (base-shell.py:69). The 10 A fuse is above the PSU's 6 A and above the
   jack's own rating (components.yaml:282 quotes "0.5-3 A" for this jack type), so it protects neither. Use the plan's
   7.5 A, or 5 A for an est. 2-3 A draw.
6. **Driver current and torque margins disagree between files.** compatibility.yaml:5 sets 0.7 A (Vref 0.56 V).
   build-notes.md:11 and 121 set **0.6 A** (Vref 0.48 V) while the motor parts are PLA, and decisions.md:15 accepts PLA
   for the deadline. Holding torque scales roughly with current, so at 0.6 A: 0.34 × 0.6/0.9 = 0.227 N·m. J2 needs 1.18 /
   12 / 0.90 = 0.109 N·m (48 % of that, not the 32 % in compatibility.yaml:125). J3 needs 0.57 / 6 / 0.95 = 0.100 N·m
   (44 %, not 29 %). decisions.md:24 quotes 29 % and 30 %, a third set of numbers. These are still under 50 %, but they
   rest on holding torque taken from a sibling motor (unverified, item U3). Update the checks to the current you will
   actually set.
7. **MG90S checks are marked `verified` on evidence that does not say it.** The part bought is a Miuzei MG90S (store
   product 6265), but the datasheet is TowerPro's. The TowerPro page says only "Operating voltage: 4.8V". It gives no
   4.8-6.6 V range, no ~0.8 A stall current and no 50 Hz 1-2 ms PWM, all of which compatibility.yaml:55 and 60 claim from
   it. Separately, the gripper cut-out uses `CUT = 0.3` per side (gripper-base.py:24), while mg90s.yaml:38 says
   "leave >= 0.5 mm clearance per side". Set those checks to unverified until the Miuzei servo is measured, or widen the
   cut-out.
8. **Cost estimate is about half the real total.** order-list.md:33 says "~$115–140 total". The prices shown today for
   the 13 lines that have one add up to $245.84, plus $20.50 of shipping, which is $266.34 without the 608s. Most of the
   gap is the $66.52 rod and the $45.23 bearing pack. requirements.yaml has no budget, so this is not a failed rule, but
   the user is planning on the wrong number.
9. **The E-stop drops the arm.** build-notes.md:126: the "NC contacts in series with +24 V to the shield". Cutting motor
   power removes holding torque, and the J2 (12:1) and J3 (6:1) belt drives are back-drivable, so the arm falls under
   gravity at the moment of the stop. Note this in the build notes (park the arm before stopping, or keep a hand on it),
   or decide it is acceptable.
10. **Compatibility checks missing** (interfaces that touch, share power or exchange a signal and have no entry in
    compatibility.yaml):
    - stepper cable 6-pin PH2.0 to the motor socket, and the 4-pin XH2.54 end to the CNC shield headers (incl. coil
      pin order);
    - DC-022B thread to the 11.3 mm base hole (base-shell.py:63 says the hole was sized for a "Vetco 321B needs 11.1", not
      the DC-022B);
    - ZB2 E-stop to the 22.3 teardrop hole in the 3 mm wall (BASE_WALL, layout.py:116);
    - collar bore to the 8 mm rod;
    - 608 and 625 to their printed pockets (only coupon rows, no entries);
    - 8 mm rod to the printed 8.2/8.3 bores;
    - flange coupling 16 mm PCD to the gripper-base holes;
    - M3 x 8 and M3 x 10 screws to the motor thread depth;
    - LM2596 output to the servo connector;
    - Uno to its USB cable;
    - J1 yaw and J4 roll torque budgets (build_plan.md:16 claims "< 0.05 N·m" with no check);
    - Uno pin budget (4 step/dir + servo on A3 + 3 end-stops).

## Unverified

1. **PSU plug size.** It must be 5.5 x 2.1 to fit the jack being bought. Many 24 V 6 A bricks use 5.5 x 2.5
   (compatibility.yaml:43-47, still unverified). The user should read the plug **before** ordering the jack.
2. **Motor connector and pinout.** The cables assume a 6-pin PH2.0 socket ("Anet-style", components.yaml:321). No
   datasheet exists for 42SHDC3026-15B (nema17-42shdc.yaml:4). Look at the motors: if they have fixed leads, the cables
   are a wrong purchase.
3. **Motor body length (40), shaft length (24), thread depth (4.5) and holding torque (0.34 N·m).** All are estimates
   from a sibling model (nema17-42shdc.yaml:11, 15-18). Measure them before ordering the pulleys and coupling.
4. **Miuzei MG90S: 180° positional or 360° continuous?** Miuzei sells both. The store page only renders the title
   "Miuzei MG90S 9G Metal Geared Micro Servo Motor". Its price ($3.50) and stock render client-side and could not be read;
   stock_checked rests on the user's catalog capture. Check the label at pickup.
5. **E-stop DC rating.** The listing gives "Current Rating 10 A, Operating Voltage 600 volts", AC only. Breaking about
   2-3 A at 24 V DC is not rated (compatibility.yaml:38-42).
6. **Fuse holder.** The 32 V DC rating is not on the listing (compatibility.yaml:33-37).
7. **CNC Shield checks** (supply 12-36 V, 4 sockets with A-axis jumpers, Uno stacking; compatibility.yaml:8-27). These
   are marked `verified`, but the evidence page did not load today: `getaddrinfo ENOTFOUND blog.protoneer.co.nz`. These
   are owned parts, so this affects setup, not the order.
8. **Studio heat-set inserts.** The hole is sized for CNC Kitchen M3 x 5.7. 3djake confirms "Insert length (L): 5.7",
   "Diameter of hole ⌀ D3: 4.0". The studio's insert type is unknown (compatibility.yaml:113-117), so print coupon row C.
9. **GT2 pulley envelope.** The kit listing gives no hub, flange or length dimensions. The CAD's 16 mm length, 16 mm hub
   and 42 mm 60T flange are estimates (gt2-20t-5mm.yaml:19-33, gt2-60t-5mm.yaml:19-33), and they set the J1 seat and
   the J2 stack on the 52 mm rod.
10. **USB-A to USB-B cable** ("owned?", build_plan.md:27), the **coupling flange hole size and thread** (not on the
    uxcell listing), and **delivery to ZIP 30332** (pages showed 30324).

## Checked

- `validate-parts`: `{"ok": true, "items": 25, "violations": []}`. No `preferred` or `selected` item carries
  `compat: issue`. No item is `selected`, so the >$30 datasheet rule was applied by hand (blocking items 3 and 4).
- 14 Amazon listings plus 2 backups were re-opened today with the full buy box. Values confirmed:
  - kit B09V5C1F7C: "Both Bore size is 5mm", 2 × 60T, 2 × 20T, 2 × 200 mm, $11.89, In Stock;
  - rod B0D7M8XBG4: 8 × 150, "-0.005mm to -0.03mm", 2 pcs, $6.49, "Only 15 left";
  - coupling B07PLB2P4W: "Inner Diameter: 5mm, Total Height: 12mm, Cylinder Outer Diameter: 10mm, Cylinder Height: 10mm,
    Base Diameter: 22mm, Base Height: 2mm, Mounting Hole Distance: 16mm", which matches flange-coupling-5mm.yaml
    (that yaml cites VXB/WHEELTEC; the uxcell page is now the better source), $8.09, "Only 18 left";
  - E-stop B07MJPRMRL: ZB2-BE102C, 1 NC, latching, $9.99, In Stock;
  - fuse holder B0DG97B5HL: 16 AWG ATC/ATO, 10 × 10 A + 10 × 15 A, $7.49, In Stock;
  - LM2596 B08L5VRBZS: "DC 3 -40 V", "recommended to use under 2A", 4 pcs, $6.99, In Stock;
  - cables B0D57RRQVP: 1 m, "XH2.54 4Pin to 6Pin PH2.0", 6 pcs, $7.99, In Stock;
  - 625, 6806, 520 belt (2GT-520-6, "Teeth 260", 6 mm) and DC jack (5.5 × 2.1, 5 pcs): dimensions as named.
- Invention Studio Store pages for 6296, 6265, 6316 and 6313 load without login. Their titles match components.yaml
  (2GT closed loop 6 mm × 300 mm, Miuzei MG90S, WEN 10761, M3 assortment). Price and stock are rendered by script, not in
  the page source.
- Belt loops recomputed from pitch diameters (L = 2C + π(D+d)/2 + (D−d)²/4C):
  - J1 20T/120T at C 73.07: 300.0 mm, wrap 128° (7.1 teeth);
  - J2 stage 1 20T/60T at C 58.62: 200.0 mm;
  - J2 stage 2 20T/80T at C 46.04: 200.0 mm, wrap 131° (7.3 teeth);
  - J3 20T/120T at C 187.30: 520.0 mm, wrap 160°.
- Quantities against the assembly: 20T 4 needed, 4 bought; 60T 1 needed, 4 bought; 200 mm belts 2 needed, 4 bought;
  608 4 of 10; 625 2 of 10; 6806 2 of 10; collars 4 of 10; coupling 1 of 2. The M3 screw tally from build-notes.md §2
  (30 × 8, 15 × 10, 10 × 12, 1 × 30, 1 × 6 = 57) matches order-list.md:43. Nothing `owned` is in `orders`, and nothing
  is bought for an owned function.
- Electrical:
  - A4988 against Pololu 1182: "operates from 8 V to 35 V", "approximately 1 A per phase without a heat sink",
    V_REF = 8 × I × R_CS. 0.6-0.7 A is under the motor's 0.9 A and the 1 A uncooled limit; 24 V is inside 8-35 V with
    11 V margin.
  - LM2596: 24 V is inside 3-40 V; 6 V out with a 1.5 V headroom requirement is met.
  - Supply: 6 A PSU against an est. 2-3 A draw plus the servo buck (6 V × 0.8 A / 0.85 / 24 V ≈ 0.24 A). This is an
    estimate, already marked unverified.
- Requirements:
  - country US: all listings deliver to Atlanta;
  - bed: the largest part is BASE_D 230 mm, against the 256 mm bed;
  - requirements.yaml sets no budget, weight limit or firmware need to check against;
  - PETG count: requirements.yaml:6 says "4 motor-clamping parts", but build-notes.md:30 and assembly.yaml mark 5
    (base-deck, upper-arm, pack-cover, pack-carriage, forearm). Align the wording.
