farev/robotarmtest/design/v1/printed/shoulder-tower.step

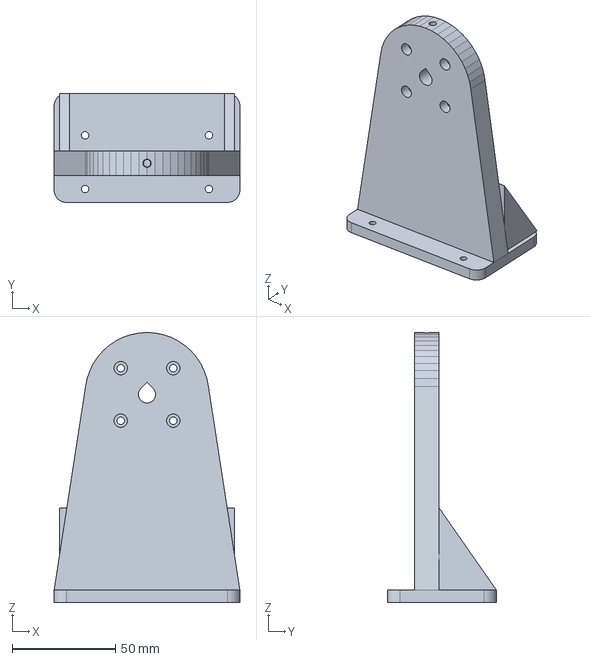
[picture p14: CAD file, 2026-10-30]
design/v1/printed/shoulder-tower.step
90.0 x 52.8 x 130.8 mm
