farev/robotarmtest/parts/models/gt2-60t-5mm.step

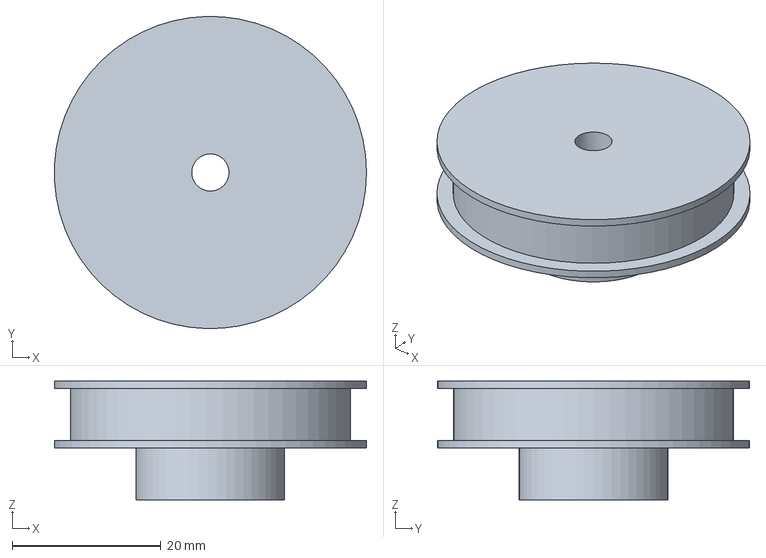
[picture p15: CAD file, 2026-10-30]
parts/models/gt2-60t-5mm.step
42.0 x 42.0 x 16.0 mm
