farev/robotarmtest/design/v1/printed/turret-hub.step

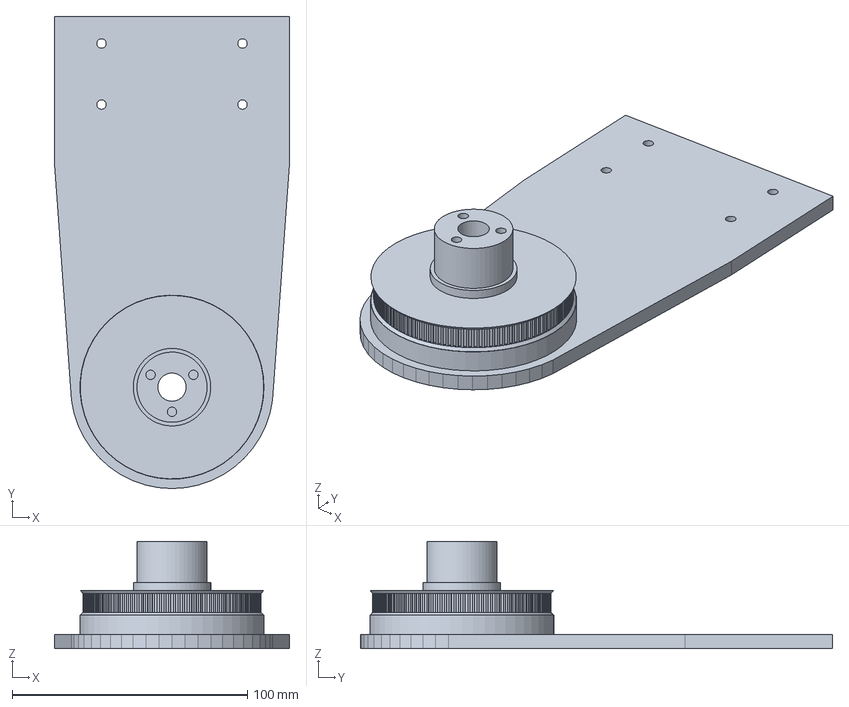
[picture p16: CAD file, 2026-10-30]
design/v1/printed/turret-hub.step
100.0 x 200.9 x 45.7 mm
