farev/robotarmtest/parts/models/rod-8x124.step

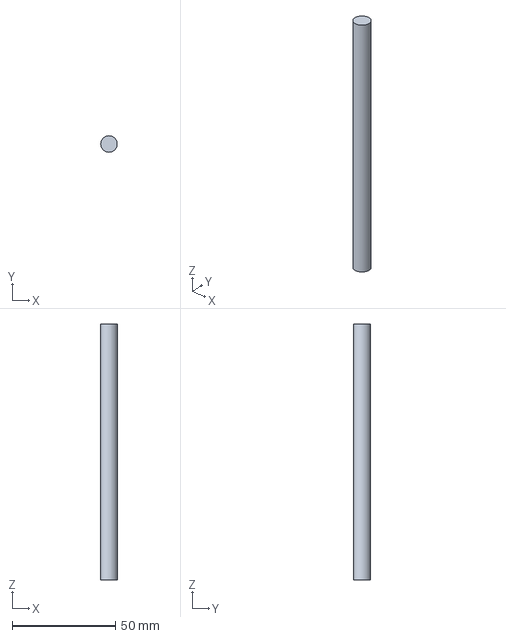
[picture p17: CAD file, 2026-10-30]
parts/models/rod-8x124.step
7.99 x 8.00 x 124.0 mm
