farev/robotarmtest/design/v1/printed/base-deck.step

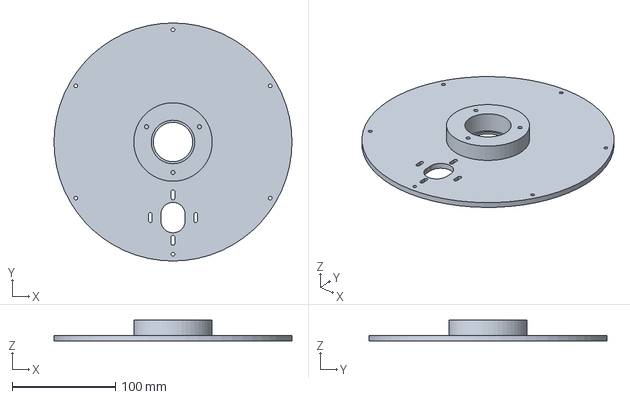
[picture p18: CAD file, 2026-10-30]
design/v1/printed/base-deck.step
230.0 x 230.0 x 20.0 mm
