farev/robotarmtest/parts/models/belt-s1-gt2-200.step

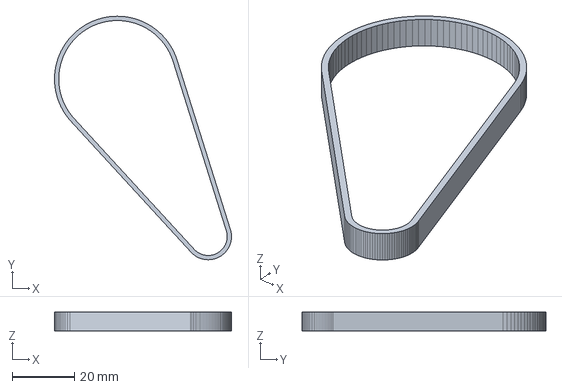
[picture p19: CAD file, 2026-10-30]
parts/models/belt-s1-gt2-200.step
57.1 x 78.5 x 6.00 mm
