farev/robotarmtest/design/v1/printed/coupon-fits.step

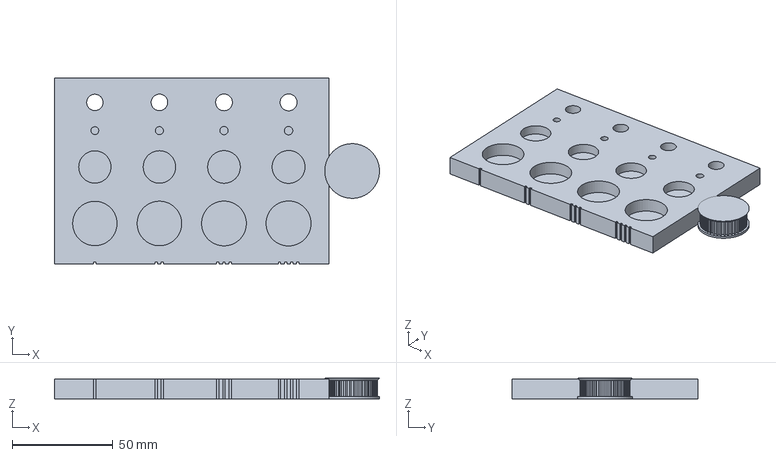
[picture p20: CAD file, 2026-10-30]
design/v1/printed/coupon-fits.step
161.1 x 92.0 x 10.4 mm
