farev/robotarmtest/parts/models/belt-s2-gt2-200.step

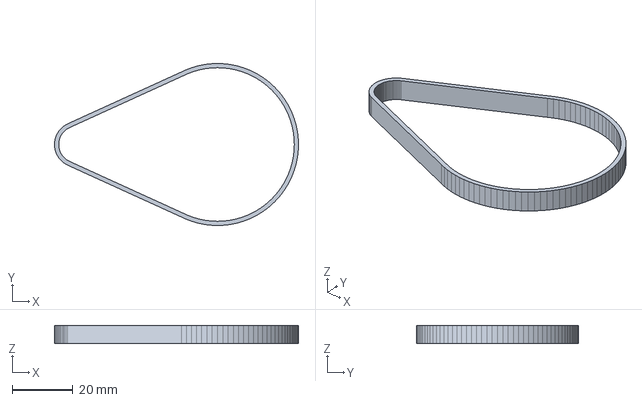
[picture p21: CAD file, 2026-10-30]
parts/models/belt-s2-gt2-200.step
80.2 x 53.2 x 6.00 mm
