farev/robotarmtest/design/v1/printed/yaw-spacer-outer.step

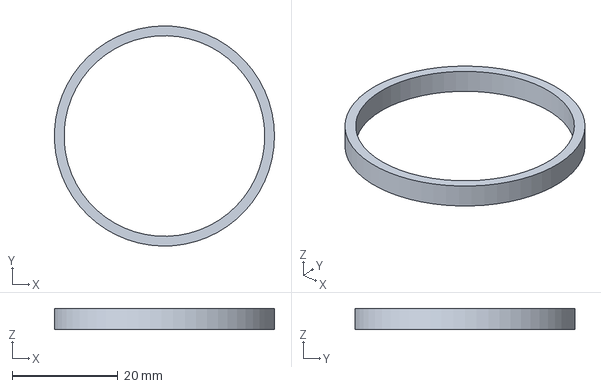
[picture p22: CAD file, 2026-10-30]
design/v1/printed/yaw-spacer-outer.step
41.7 x 41.7 x 4.00 mm
