farev/robotarmtest/parts/models/collar-8mm.step

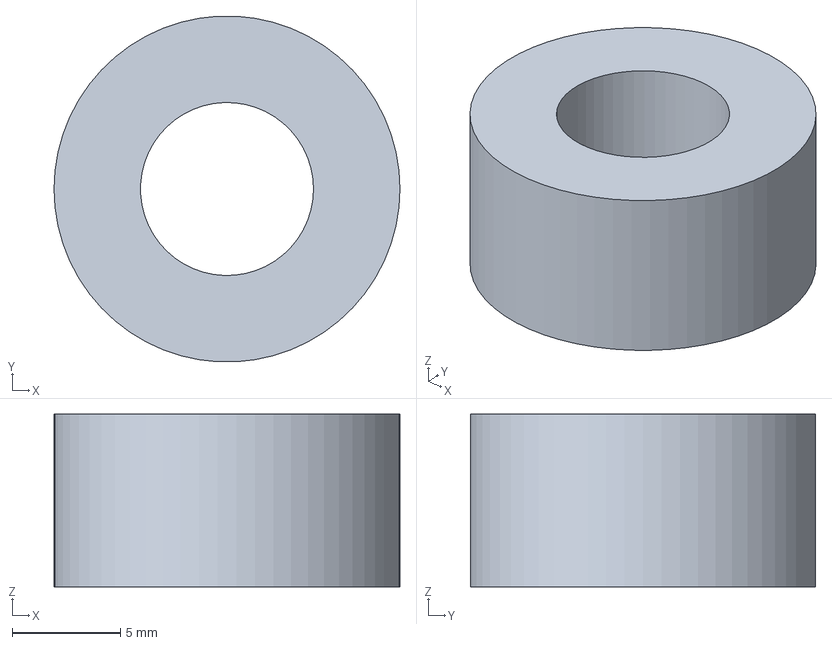
[picture p23: CAD file, 2026-10-30]
parts/models/collar-8mm.step
16.0 x 16.0 x 8.00 mm
