farev/robotarmtest/design/v1/printed/pack-carriage.step

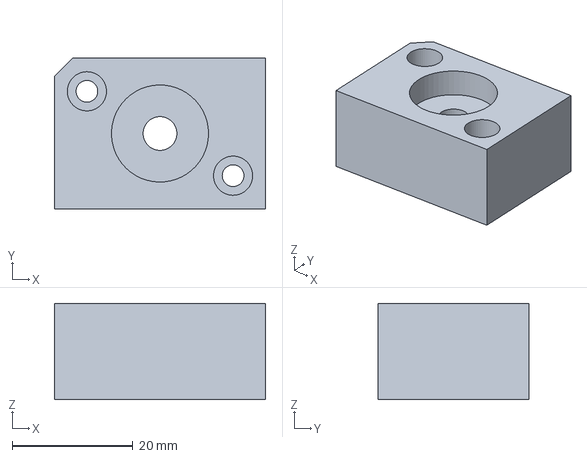
[picture p24: CAD file, 2026-10-30]
design/v1/printed/pack-carriage.step
35.0 x 25.0 x 16.0 mm
