farev/robotarmtest/parts/models/rod-5x52.step

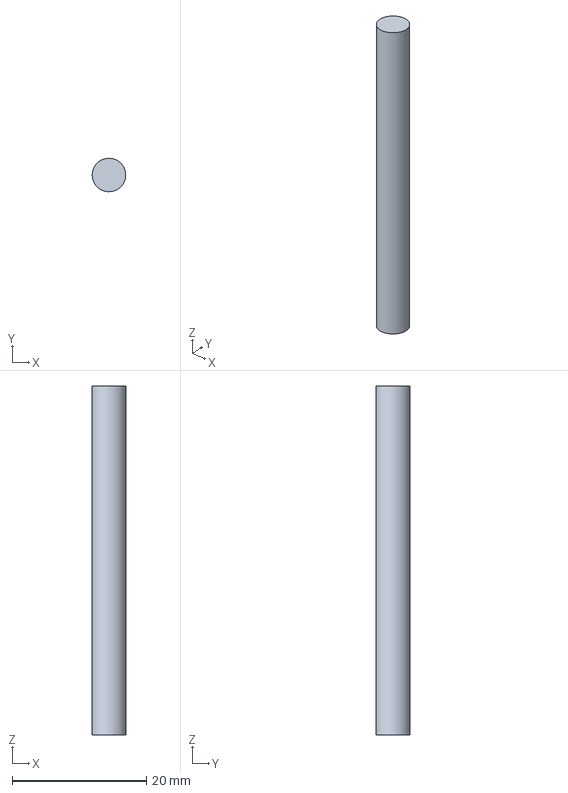
[picture p25: CAD file, 2026-10-30]
parts/models/rod-5x52.step
5.00 x 5.00 x 52.0 mm
