farev/robotarmtest/design/v1/printed/base-shell.step

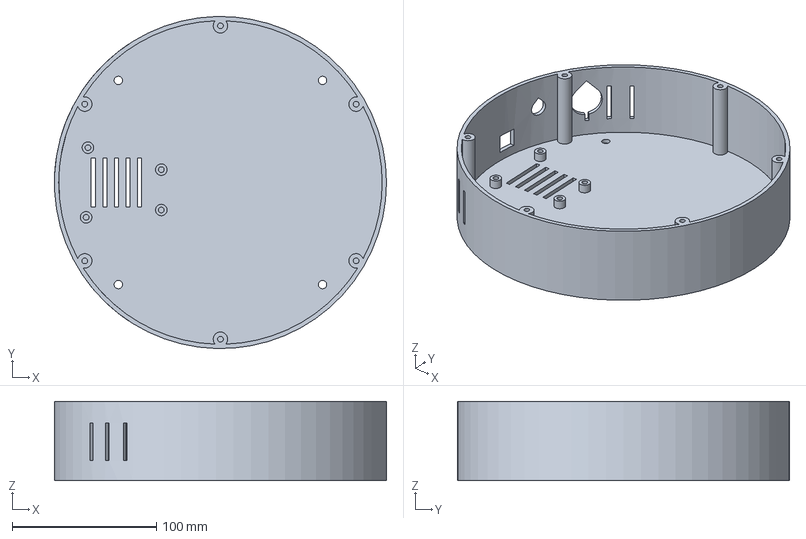
[picture p26: CAD file, 2026-10-30]
design/v1/printed/base-shell.step
229.9 x 229.9 x 55.0 mm
