farev/robotarmtest/parts/models/bearing-6806.step

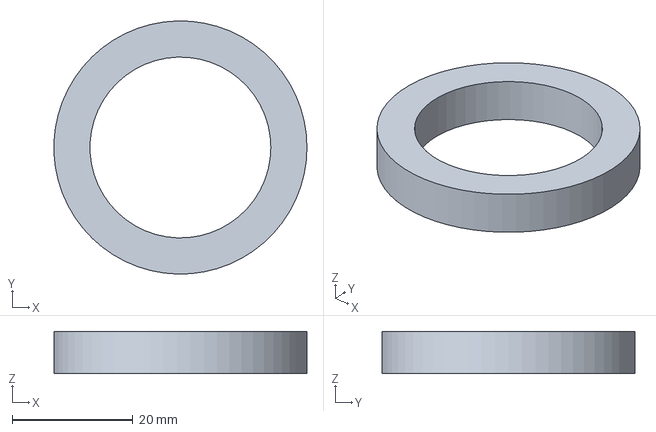
[picture p27: CAD file, 2026-10-30]
parts/models/bearing-6806.step
42.0 x 42.0 x 7.00 mm
