farev/robotarmtest/design/v1/printed/gripper-finger-right.step

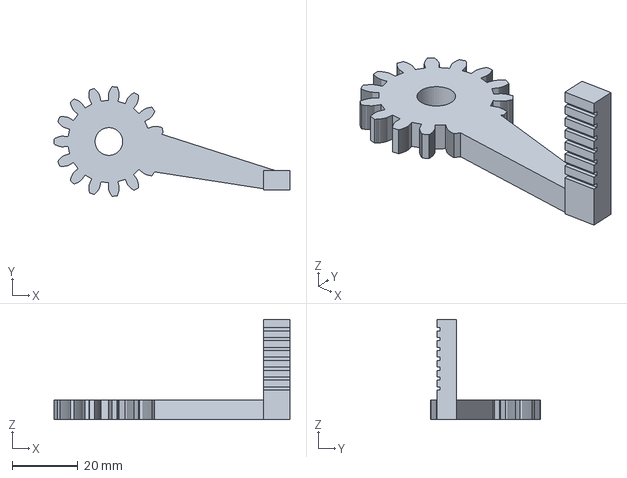
[picture p28: CAD file, 2026-10-30]
design/v1/printed/gripper-finger-right.step
71.7 x 33.3 x 30.5 mm
