farev/robotarmtest/parts/models/belt-j1-gt2-300.step

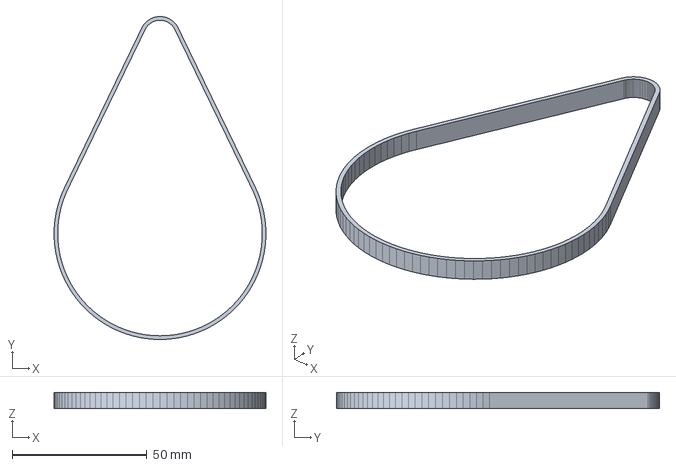
[picture p29: CAD file, 2026-10-30]
parts/models/belt-j1-gt2-300.step
78.7 x 119.9 x 6.00 mm
