farev/robotarmtest/design/v1/printed/shoulder-pulley-80t.step

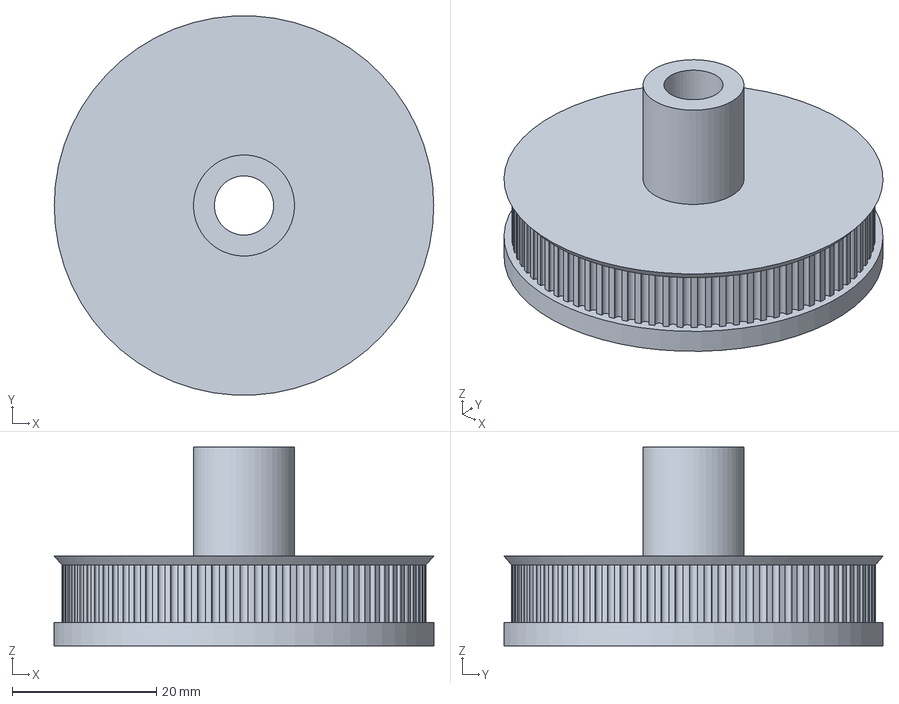
[picture p30: CAD file, 2026-10-30]
design/v1/printed/shoulder-pulley-80t.step
52.6 x 52.5 x 27.5 mm
