farev/robotarmtest/parts/models/rod-8x100.step

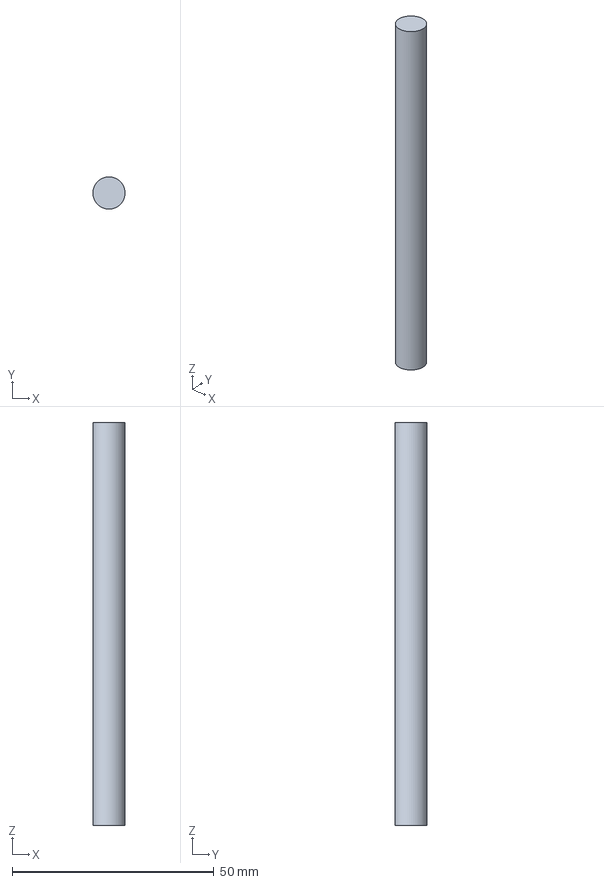
[picture p31: CAD file, 2026-10-30]
parts/models/rod-8x100.step
7.99 x 8.00 x 100.0 mm
