farev/robotarmtest/design/v1/printed/forearm.step

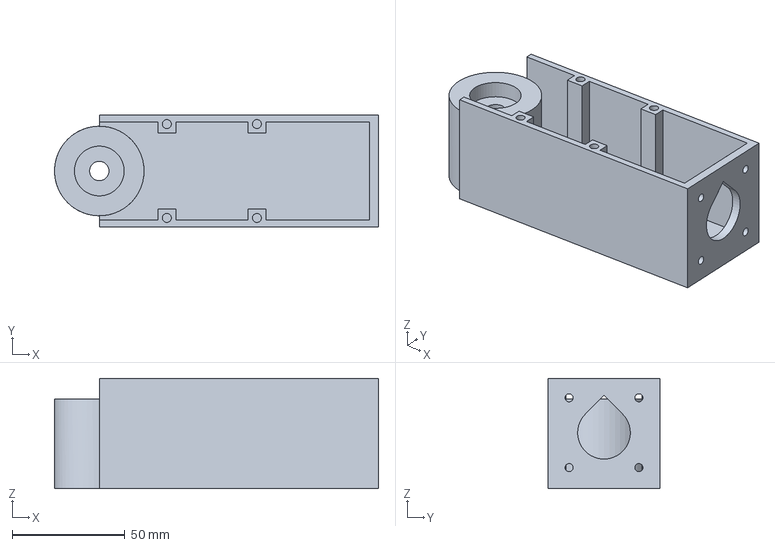
[picture p32: CAD file, 2026-10-30]
design/v1/printed/forearm.step
143.9 x 49.7 x 49.0 mm
