farev/robotarmtest/parts/models/bearing-625.step

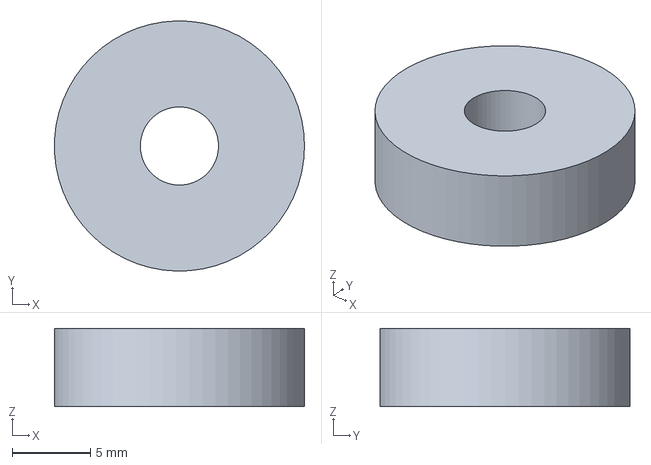
[picture p33: CAD file, 2026-10-30]
parts/models/bearing-625.step
16.0 x 16.0 x 5.00 mm
