farev/robotarmtest/design/v1/printed/pack-cover.step

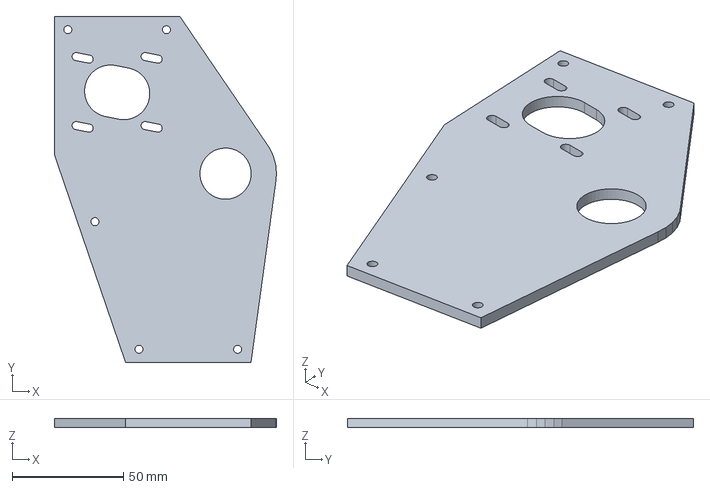
[picture p34: CAD file, 2026-10-30]
design/v1/printed/pack-cover.step
99.7 x 155.6 x 4.00 mm
