farev/robotarmtest/parts/models/bearing-608.step

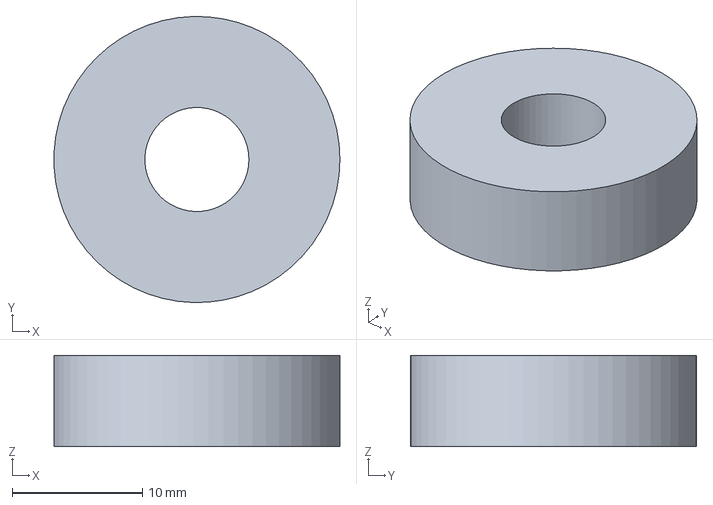
[picture p35: CAD file, 2026-10-30]
parts/models/bearing-608.step
22.0 x 22.0 x 7.00 mm
