farev/robotarmtest/design/v1/printed/turret-clamp.step

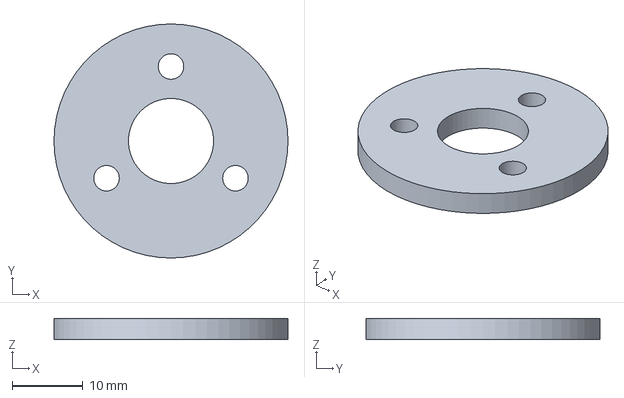
[picture p36: CAD file, 2026-10-30]
design/v1/printed/turret-clamp.step
33.0 x 33.0 x 3.00 mm
