farev/robotarmtest/parts/models/belt-j3-gt2-520.step

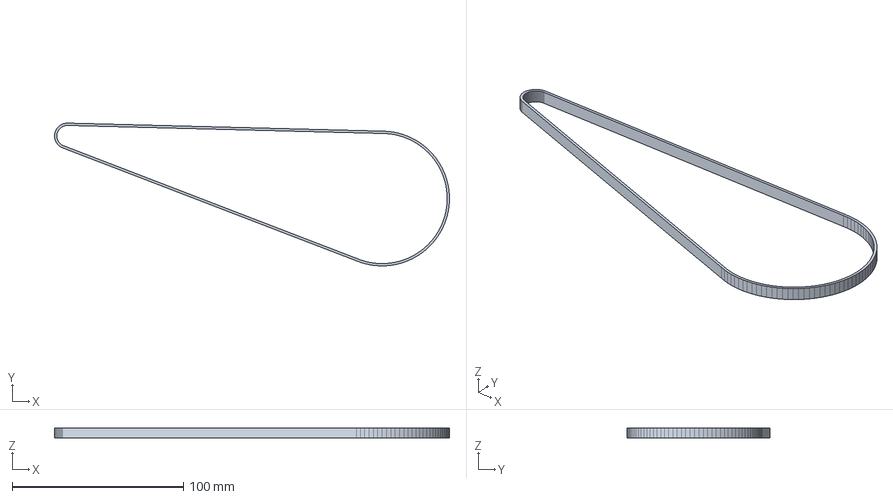
[picture p37: CAD file, 2026-10-30]
parts/models/belt-j3-gt2-520.step
230.6 x 83.4 x 6.00 mm
