farev/robotarmtest/design/v1/printed/bearing-cap.step

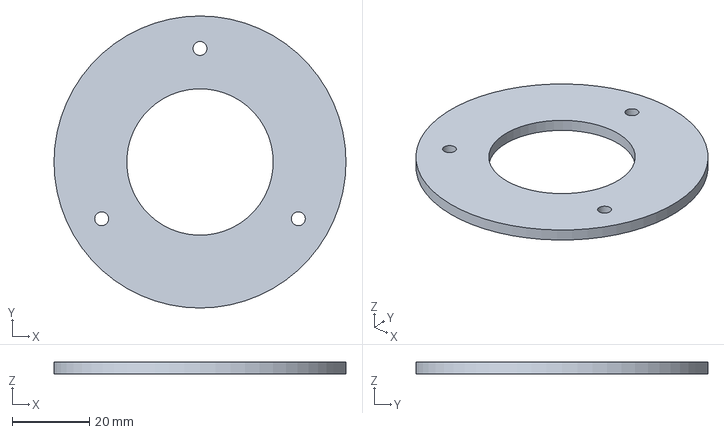
[picture p38: CAD file, 2026-10-30]
design/v1/printed/bearing-cap.step
75.8 x 75.8 x 3.00 mm
