farev/robotarmtest/parts/models/flange-coupling-5mm.step

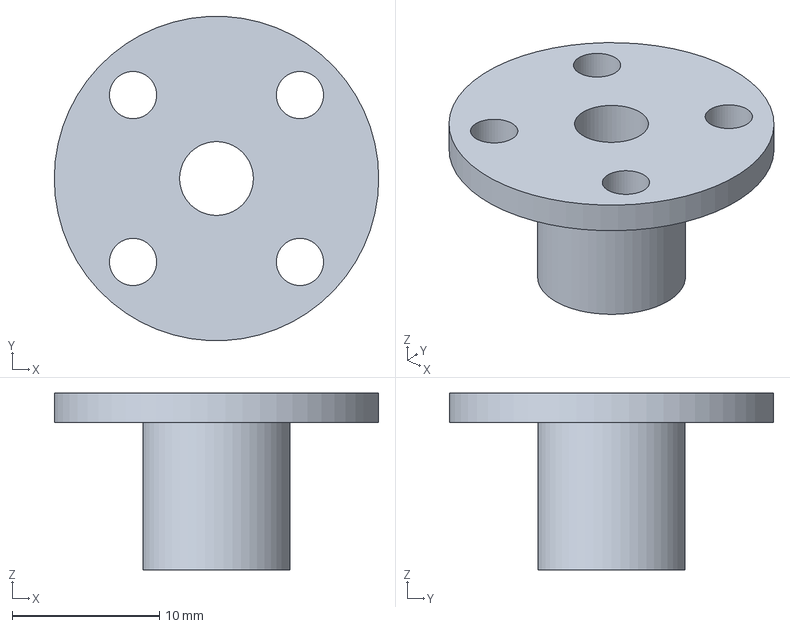
[picture p39: CAD file, 2026-10-30]
parts/models/flange-coupling-5mm.step
22.0 x 22.0 x 12.0 mm
