farev/robotarmtest/design/v1/printed/forearm-cover.step

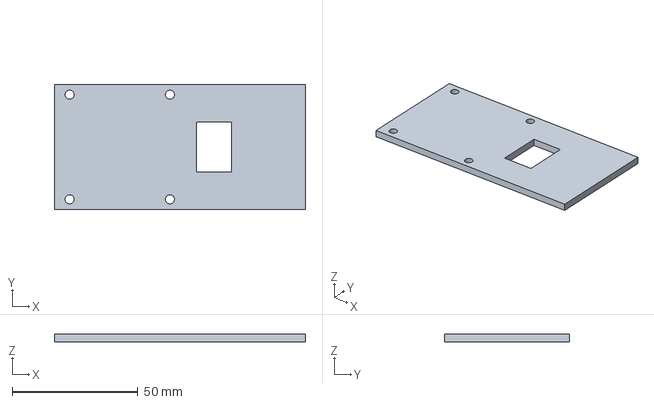
[picture p40: CAD file, 2026-10-30]
design/v1/printed/forearm-cover.step
100.0 x 49.7 x 3.00 mm
