farev/robotarmtest/parts/models/gt2-20t-5mm.step

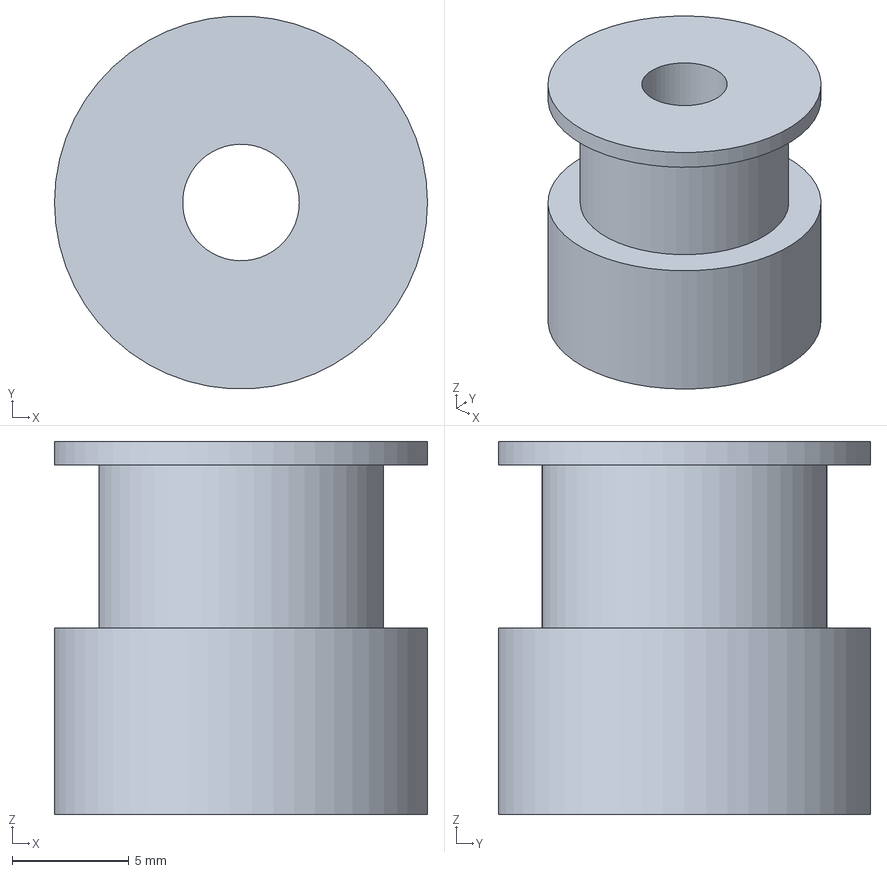
[picture p41: CAD file, 2026-10-30]
parts/models/gt2-20t-5mm.step
16.0 x 16.0 x 16.0 mm
