farev/robotarmtest/design/v1/printed/bearing-shim.step

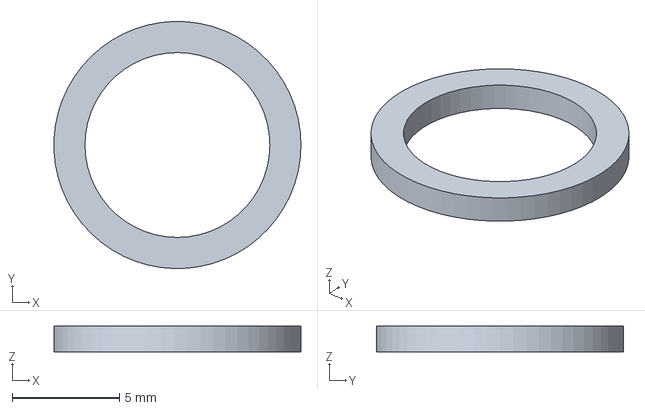
[picture p42: CAD file, 2026-10-30]
design/v1/printed/bearing-shim.step
11.5 x 11.5 x 1.20 mm
