farev/robotarmtest/design/v1/printed/upper-arm.step

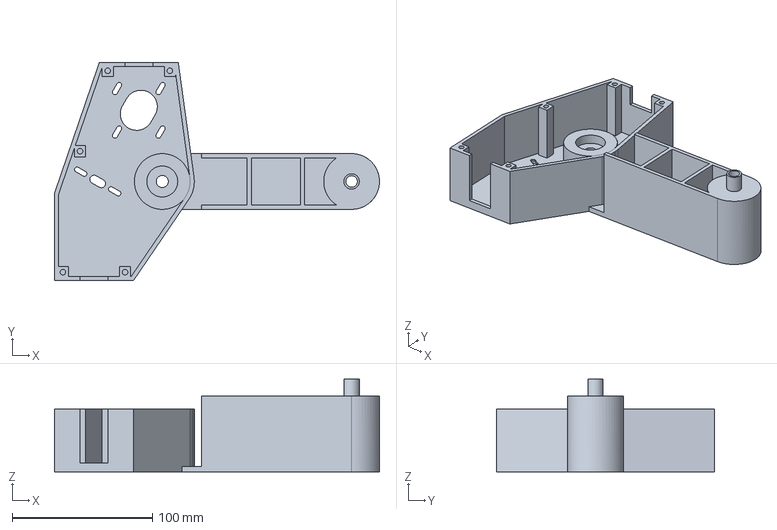
[picture p43: CAD file, 2026-10-30]
design/v1/printed/upper-arm.step
231.7 x 155.6 x 66.2 mm
