farev/robotarmtest/parts/models/mg90s.step

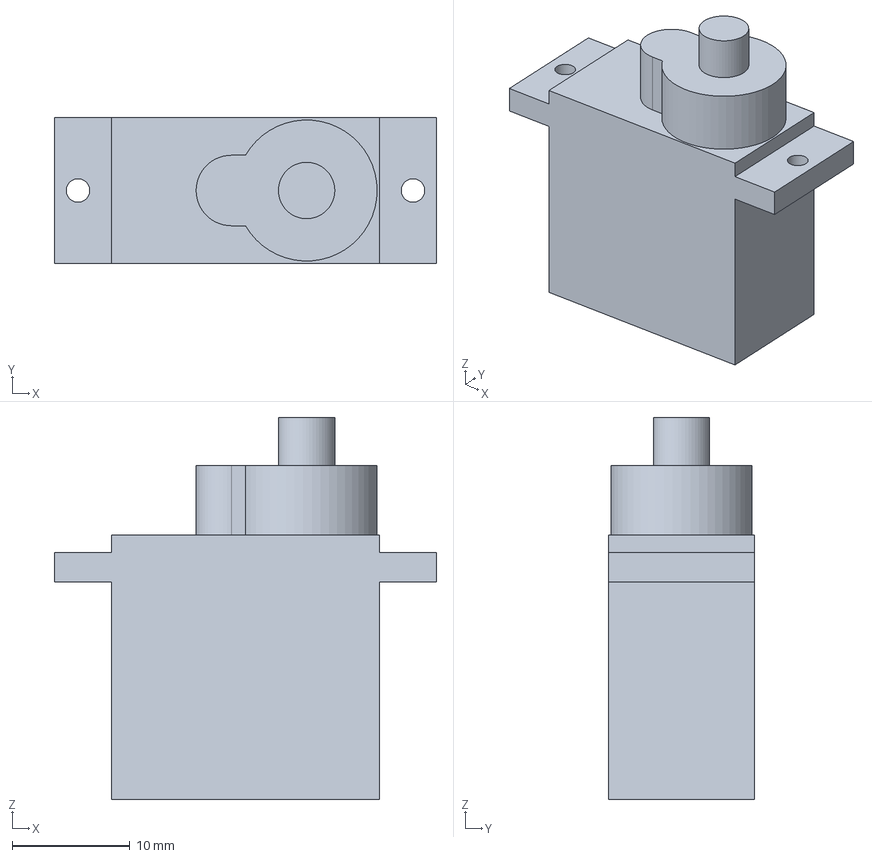
[picture p44: CAD file, 2026-10-30]
parts/models/mg90s.step
32.5 x 12.4 x 32.5 mm
