farev/robotarmtest/design/v1/printed/gripper-base.step

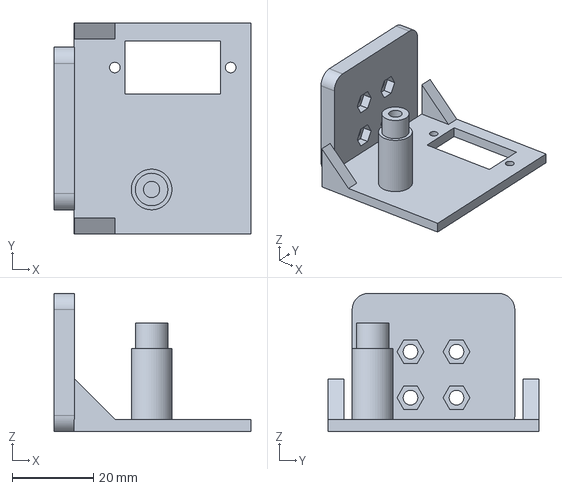
[picture p45: CAD file, 2026-10-30]
design/v1/printed/gripper-base.step
48.5 x 52.0 x 34.0 mm
