farev/robotarmtest/design/v1/printed/coupon-yaw.step

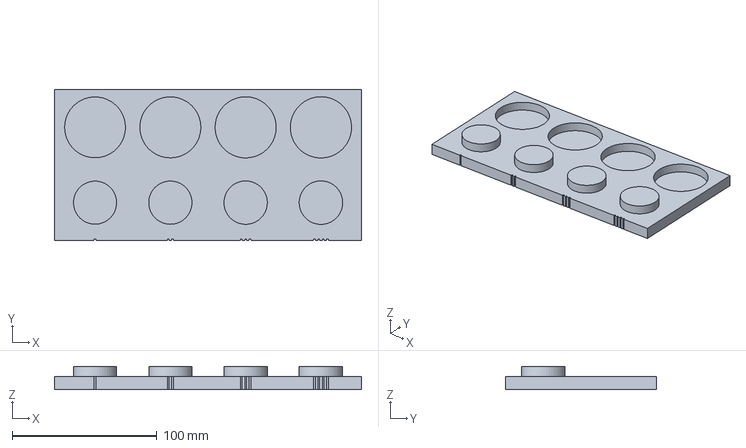
[picture p46: CAD file, 2026-10-30]
design/v1/printed/coupon-yaw.step
212.0 x 104.0 x 16.0 mm
