farev/robotarmtest/parts/models/nema17-plug-keepout.step

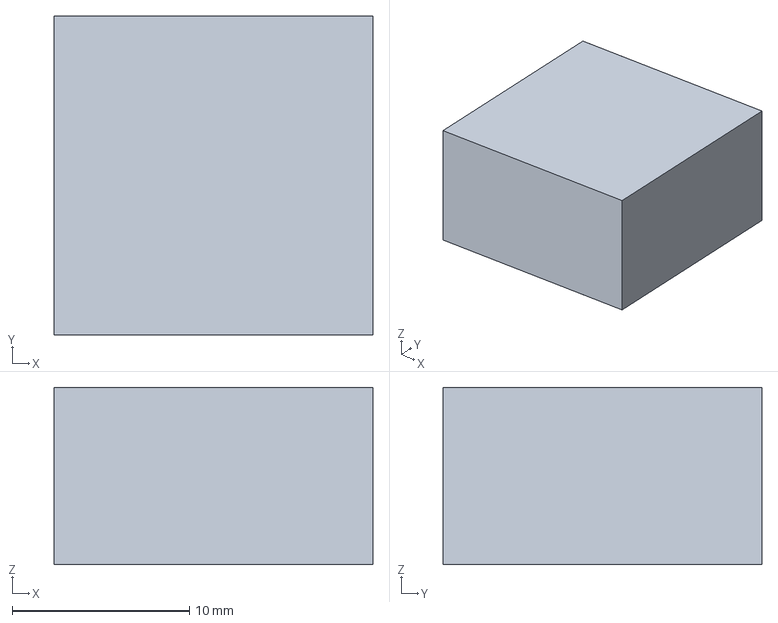
[picture p47: CAD file, 2026-10-30]
parts/models/nema17-plug-keepout.step
18.0 x 18.0 x 10.0 mm
