farev/robotarmtest/design/v1/printed/yaw-spacer-inner.step

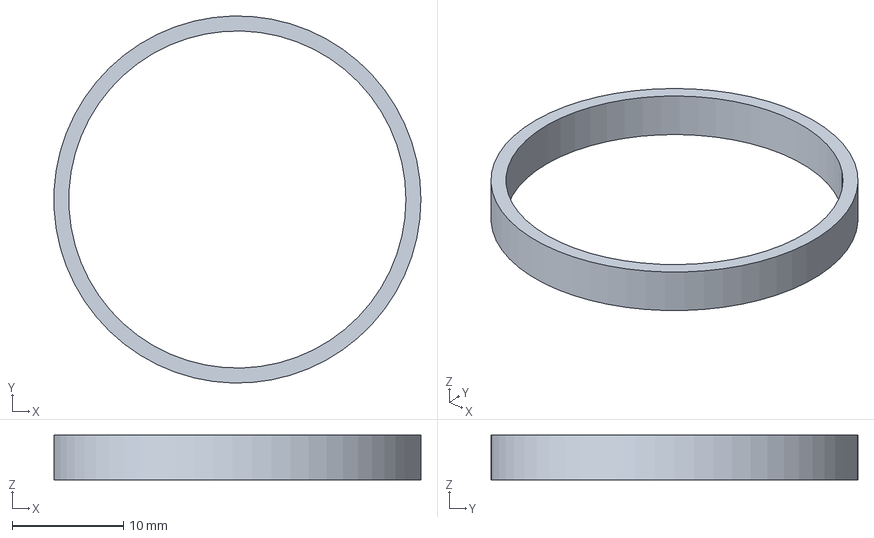
[picture p48: CAD file, 2026-10-30]
design/v1/printed/yaw-spacer-inner.step
33.0 x 33.0 x 4.00 mm
