farev/robotarmtest/parts/models/m3-key-keepout.step

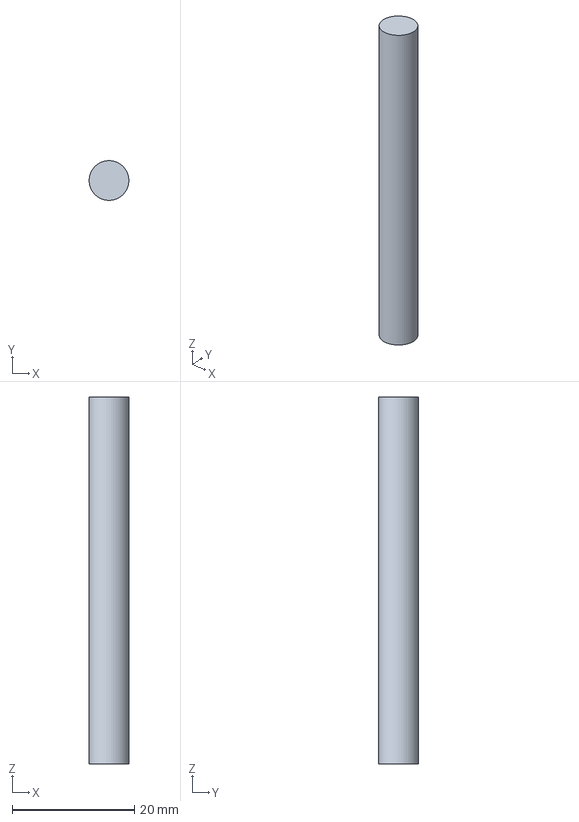
[picture p49: CAD file, 2026-10-30]
parts/models/m3-key-keepout.step
6.49 x 6.50 x 60.0 mm
