farev/robotarmtest/design/v1/printed/gripper-finger-left.step

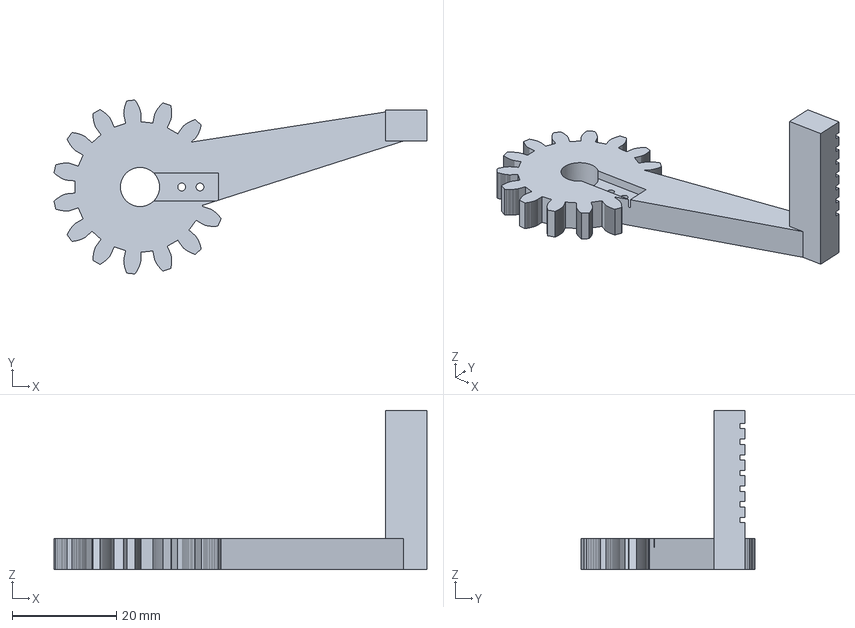
[picture p50: CAD file, 2026-10-30]
design/v1/printed/gripper-finger-left.step
71.5 x 33.3 x 30.5 mm
