farev/robotarmtest/design/v1/printed/elbow-pulley-120t.step

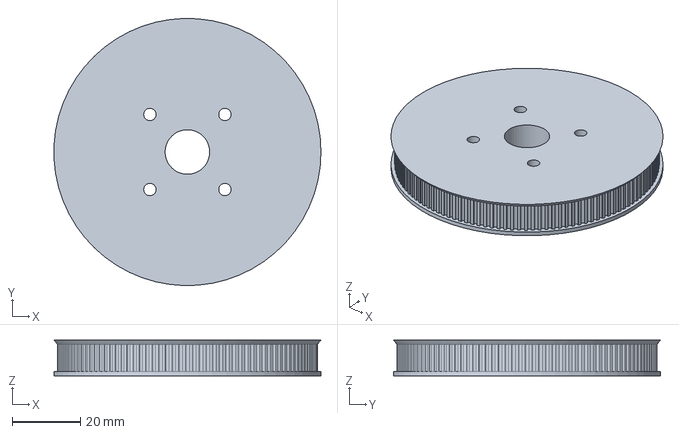
[picture p51: CAD file, 2026-10-30]
design/v1/printed/elbow-pulley-120t.step
78.0 x 78.0 x 10.4 mm
