farev/robotarmtest/parts/models/nema17-42shdc.step

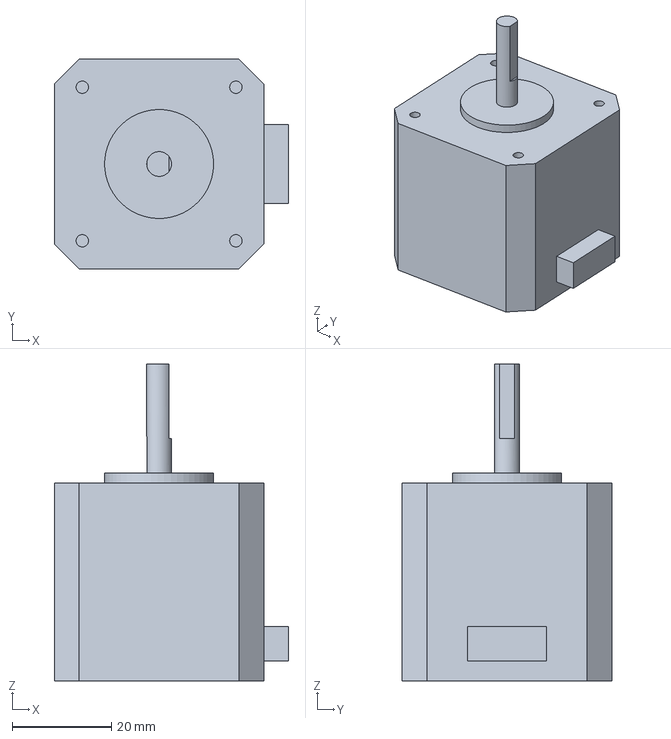
[picture p52: CAD file, 2026-10-30]
parts/models/nema17-42shdc.step
47.3 x 42.3 x 64.0 mm
