farev/robotarmtest/parts/models/rod-8x113.step

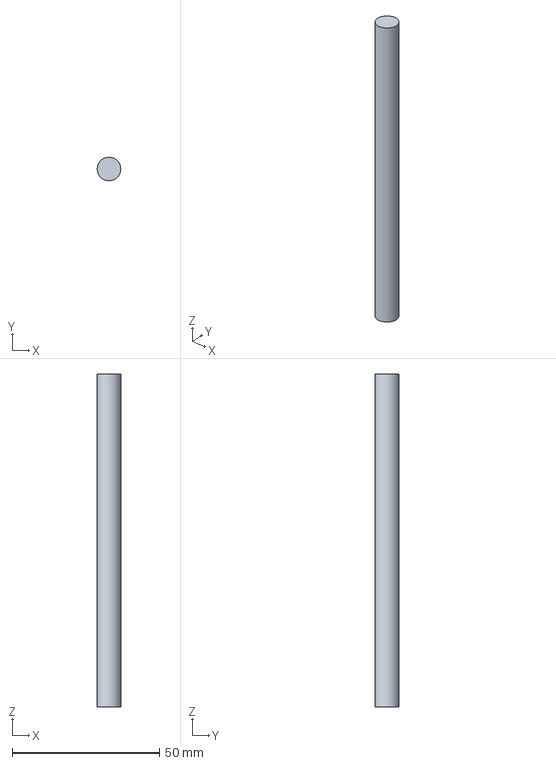
[picture p53: CAD file, 2026-10-30]
parts/models/rod-8x113.step
7.99 x 8.00 x 113.0 mm
