farev/robotarmtest/parts/models/uno-cnc-shield.step

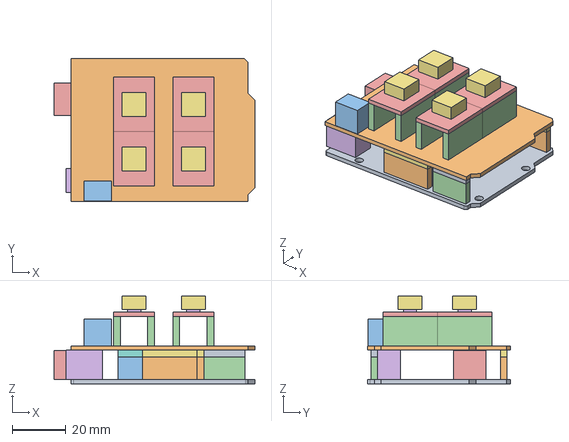
[picture p54: CAD file, 2026-10-30]
parts/models/uno-cnc-shield.step
74.9 x 53.3 x 32.8 mm
