farev/robotarmtest/parts/models/table-keepout.step

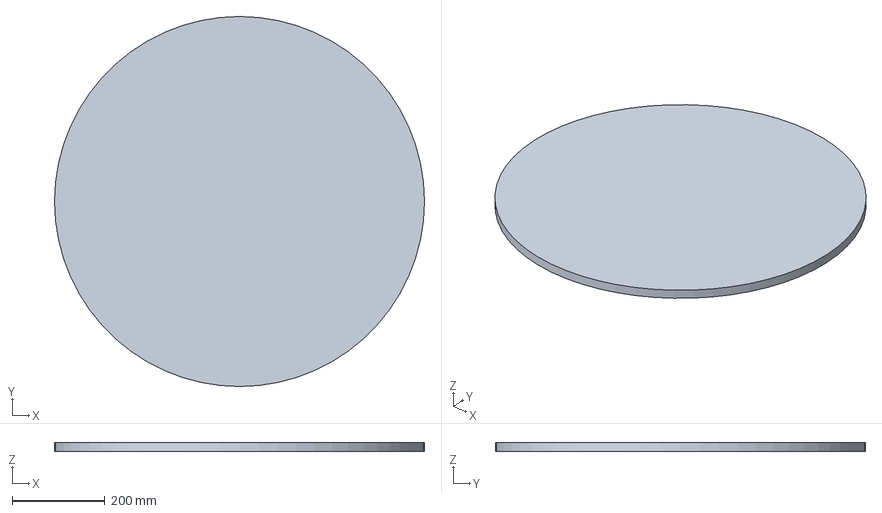
[picture p55: CAD file, 2026-10-30]
parts/models/table-keepout.step
800.0 x 800.0 x 20.0 mm
