farev/robotarmtest/parts/models/mg90s-keepout.step

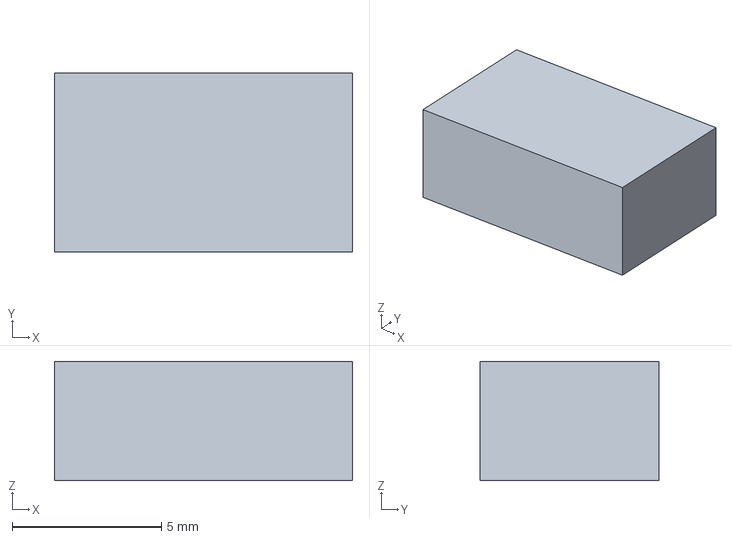
[picture p56: CAD file, 2026-10-30]
parts/models/mg90s-keepout.step
10.0 x 6.00 x 4.00 mm
