farev/robotarmtest/(list of files, cad)

Other CAD files:
design/v1/printed/base-deck.stl
design/v1/printed/base-shell.stl
design/v1/printed/bearing-cap.stl
design/v1/printed/bearing-shim.stl
design/v1/printed/coupon-fits.stl
design/v1/printed/coupon-yaw.stl
design/v1/printed/elbow-pulley-120t.stl
design/v1/printed/forearm-cover.stl
design/v1/printed/forearm.stl
design/v1/printed/gripper-base.stl
design/v1/printed/gripper-finger-left.stl
design/v1/printed/gripper-finger-right.stl
design/v1/printed/pack-carriage.stl
design/v1/printed/pack-cover.stl
design/v1/printed/shoulder-pulley-80t.stl
design/v1/printed/shoulder-tower.stl
design/v1/printed/turret-clamp.stl
design/v1/printed/turret-hub.stl
design/v1/printed/upper-arm.stl
design/v1/printed/yaw-spacer-inner.stl
design/v1/printed/yaw-spacer-outer.stl
parts/models/m3x10-shcs.step
parts/models/m3x12-shcs.step
parts/models/m3x30-shcs.step
parts/models/m3x8-shcs.step
