farev/robotarmtest/design/v1/joints.yaml

note: '4-DOF belt arm (yaw, shoulder, elbow, wrist roll) + servo gripper whose geared
  fingers mirror each other. Belts are rigid with the link that carries them (they
  do not stretch in the viewer). Joint frames come from make_assembly.py (yaw Rz(q1)
  at the origin; shoulder Ry(-q2) at z 187; elbow Ry(-q3) 135 mm along the upper arm;
  wrist Rx(q4) at the coupling face 145 mm along the forearm). The pose snapshots
  are not listed: each adds a table keep-out that the home file leaves out, so rig-check
  counts them as build views and cannot compare them. Their joint values are stretched
  (0,0,0,0), up (0,90,0,0), folded (0,90,-135,0), reach-table (0,0,-43,0), shoulder-down
  (90,-30,8,0), elbow-up (0,30,120,0), yaw-150 (150,45,-90,180), soft-limit (0,20,-84,0).'
joints:
- id: yaw
  label: J1 base yaw
  type: revolute
  parent: null
  origin:
  - 0
  - 0
  - 0
  axis:
  - 0
  - 0
  - 1
  parts:
  - turret-hub
  - yaw-spacer-inner
  - turret-clamp
  - shoulder-tower
  - shoulder-pulley-80t
  - rod-shoulder
  - bearing-shim
  - collar-shoulder-in
  - bearing-shim-2
  - collar-shoulder-out
  - screw-tower-foot-1
  - screw-tower-foot-2
  - screw-tower-foot-3
  - screw-tower-foot-4
  - screw-shaft-lock
  - screw-shaft-lock-key-keepout
  home: 0
  limits:
  - -150
  - 150
- id: shoulder
  label: J2 shoulder
  type: revolute
  parent: yaw
  origin:
  - 0
  - 0
  - 187
  axis:
  - 0
  - -1
  - 0
  parts:
  - upper-arm
  - pack-cover
  - pack-carriage
  - bearing-608-sh-1
  - bearing-608-sh-2
  - motor-j2
  - plug-motor-j2-keepout
  - pulley-j2-20t
  - rod-intermediate
  - bearing-625-1
  - bearing-625-2
  - pulley-s1-60t
  - pulley-s2-20t
  - motor-j3
  - plug-motor-j3-keepout
  - pulley-j3-20t
  - belt-s1
  - belt-s2
  - belt-j3
  - rod-elbow
  - collar-elbow-in
  - bearing-shim-3
  - collar-elbow-out
  - screw-j2-1
  - screw-j2-2
  - screw-j2-3
  - screw-j2-4
  - screw-carriage-1
  - screw-carriage-2
  home: 45
  limits:
  - -30
  - 90
- id: elbow
  label: J3 elbow
  type: revolute
  parent: shoulder
  origin:
  - 95.4594
  - 0
  - 282.4594
  axis:
  - 0
  - -1
  - 0
  parts:
  - forearm
  - forearm-cover
  - elbow-pulley-120t
  - bearing-608-el-1
  - bearing-608-el-2
  - motor-j4
  - plug-motor-j4-keepout
  - hub-j4
  home: -90
  limits:
  - -135
  - 120
- id: wrist
  label: J4 wrist roll
  type: revolute
  parent: elbow
  origin:
  - 197.9895
  - 0
  - 179.9295
  axis:
  - 0.707107
  - 0
  - -0.707107
  parts:
  - gripper-base
  - servo-gripper
  - servo-cable-keepout
  home: 0
  limits:
  - -180
  - 180
- id: finger-l
  label: Gripper open
  type: revolute
  parent: wrist
  origin:
  - 214.9601
  - 15
  - 162.9589
  axis:
  - 0.707107
  - 0
  - 0.707107
  parts:
  - gripper-finger-left
  home: 0
  limits:
  - 0
  - 30
- id: finger-r
  type: revolute
  parent: wrist
  origin:
  - 214.9601
  - -15
  - 162.9589
  axis:
  - 0.707107
  - 0
  - 0.707107
  parts:
  - gripper-finger-right
  home: 0
  limits:
  - -30
  - 0
  coupled:
  - joint: finger-l
    ratio: -1
poses: []
assembly_sha256: 8a9999f2830716e24af30a45aab652651220f2841095b512f52c73498559cf4c
glb_sha256: 66297e848471f88347fcb7c003cff08a3c024d77a69f4e61a7ef2e33752ca938
checked:
  ok: true
  poses: []
