farev/robotarmtest/(commit log)

2026-10-29 mechy init
    [motors.yaml]
2026-10-30 Add v1 design, parts, research, docs and project state
    [base-deck.step, base-deck.stl, base-shell.step, base-shell.stl, bearing-608.step, bearing-625.step, bearing-6806.step, bearing-cap.step]
2026-10-30 Mechy: Here there is no gap for the belt. Fix that.
    [base-deck.step, base-shell.step, bearing-608.step, bearing-625.step, bearing-6806.step, bearing-cap.step, bearing-shim.step, belt-j1-gt2-300.step]
2026-11-02 Save local v1 work: gripper finger joints and Mechy logs
